scedillo-wq/TanqueComb/IMG-20260904-WA0024.jpg

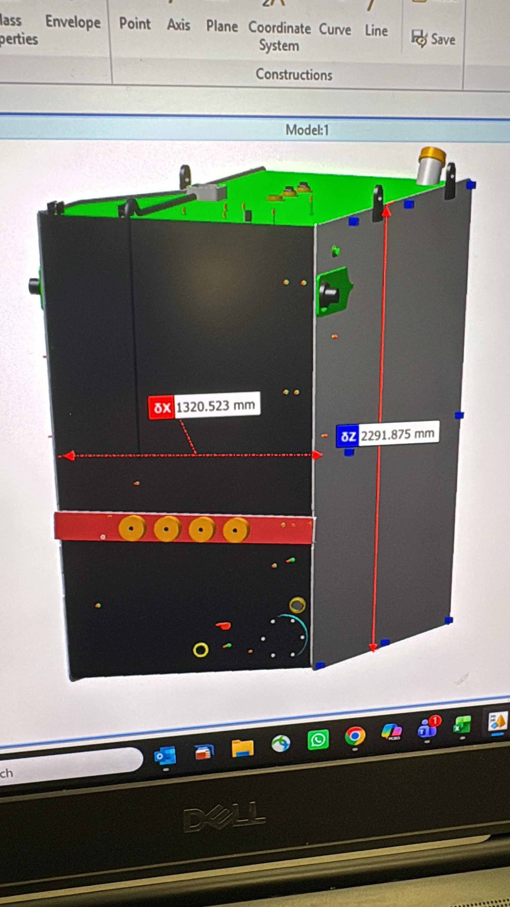
IMG-20260904-WA0024.jpg
