scedillo-wq/TanqueComb/Plano TK1.jpeg

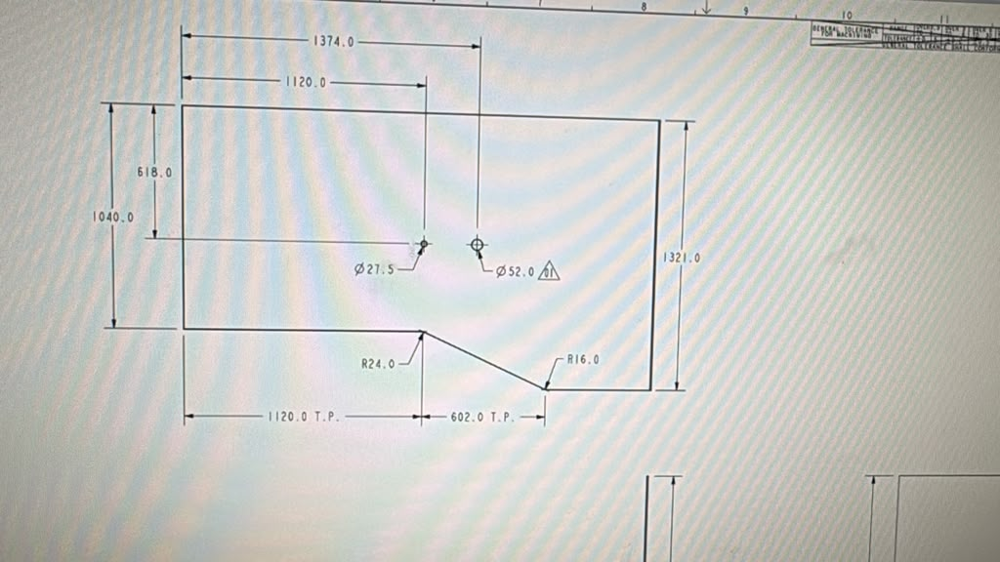
Plano TK1.jpeg
