scedillo-wq/TanqueComb/README.md

# TanqueComb
naliza las propuestas de raul, realiza las 2 propuestas en 3d compatible con fusion360 saca los planos y ademas realiza el analisis de elementos finitos apoyate del contexto adjunto
