scedillo-wq/TanqueComb/Stress Analysis Report 2 (1).pdf

31/12/2016 | Stress Analysis Report 2
file:///C:/Users/DOCUMENTOS/Desktop/SIMULACION/ENSAMBLE%20GENERAL%20Stress%20Analysis%20Report%2031_12_2016.html | 1/50

# Stress Analysis Report 2

Analyzed File: | ENSAMBLE GENERAL.iam
Autodesk Inventor Version: | 2015 (Build 190159000, 159)
Creation Date: | 31/12/2016, 11:25 a.m.
Simulation Author: | DOCUMENTOS
Summary:

### Project Info (iProperties)

Summary
Author DOCUMENTOS

Project
Part Number | ENSAMBLE GENERAL
Designer | DOCUMENTOS
Cost | S/. 0.00
Date Created | 31/12/2016

Status
Design Status WorkInProgress

Physical
Mass | 686.139 kg
Area | 67517700 mm^2
Volume | 686139000 mm^3
Center of Gravity | x=368.817 mm y=-534.213 mm z=354.259 mm

Note: Physical values could be different from Physical values used by FEA reported below.

## SIMULACION ENSAYO

General objective and settings:
Design Objective | Single Point
Simulation Type | Static Analysis
Last Modification Date | 31/12/2016, 11:22 a.m.
Detect and Eliminate Rigid Body Modes | No
Separate Stresses Across Contact Surfaces | No
Motion Loads Analysis | No

Mesh settings:
Avg. Element Size (fraction of model diameter) | 0.1
Min. Element Size (fraction of avg. size) | 0.2
Grading Factor | 1.5
Max. Turn Angle | 60 deg
Create Curved Mesh Elements | No

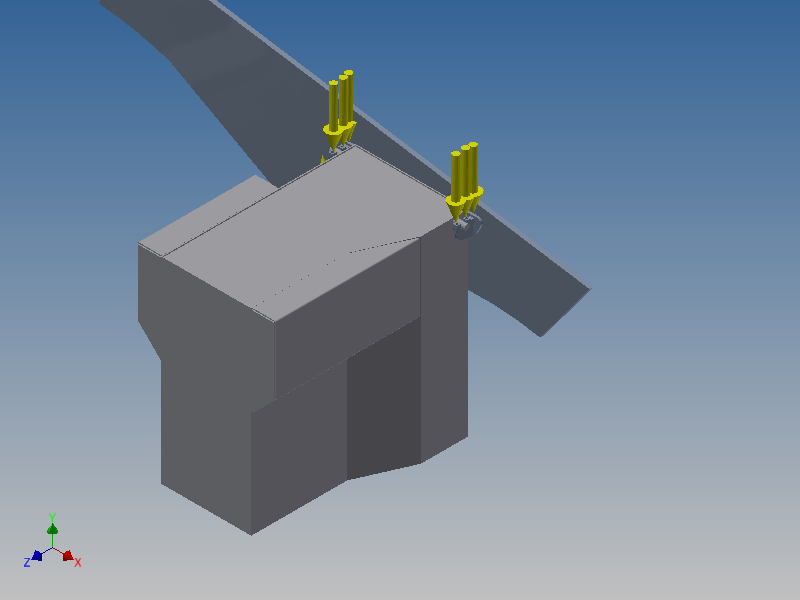
[picture p12: figure]

file:///C:/Users/DOCUMENTOS/Desktop/SIMULACION/ENSAMBLE%20GENERAL%20Stress%20Analysis%20Report%2031_12_2016.html | 2/50
Create Curved Mesh Elements | No
Use part based measure for Assembly mesh | Yes

### Material(s)

Name | Steel
General | Mass Density | 7.85 g/cm^3
| Yield Strength | 207 MPa
| Ultimate Tensile Strength | 345 MPa
Stress | Young's Modulus | 210 GPa
| Poisson's Ratio | 0.3 ul
| Shear Modulus | 80.7692 GPa
Part Name(s) | ESQUELETO 2 TANQUE COMBUSTIBLE CUERPO 1 TAPA 1 TAPA 1 CUERPO 2 TAPA 2 EJE PIN EJE PIN

### Operating conditions

Gravity
Load Type | Gravity
Magnitude | 9810.000 mm/s^2
Vector X | 0.000 mm/s^2
Vector Y | -9810.000 mm/s^2
Vector Z | 0.000 mm/s^2

Selected Face(s)

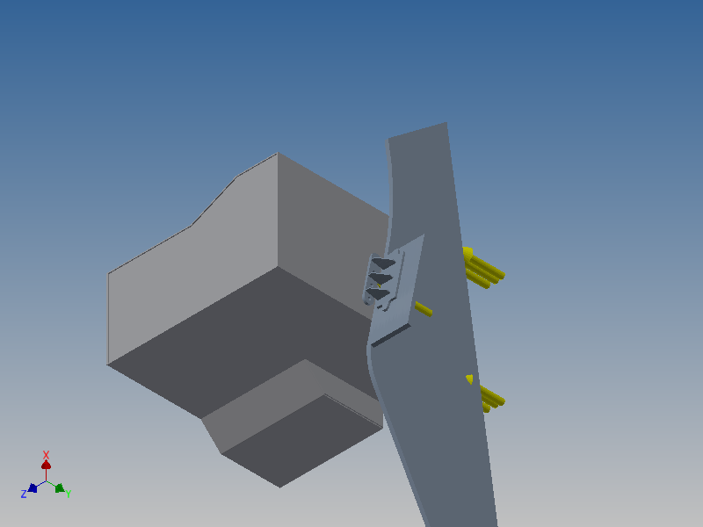
[picture p13: figure]
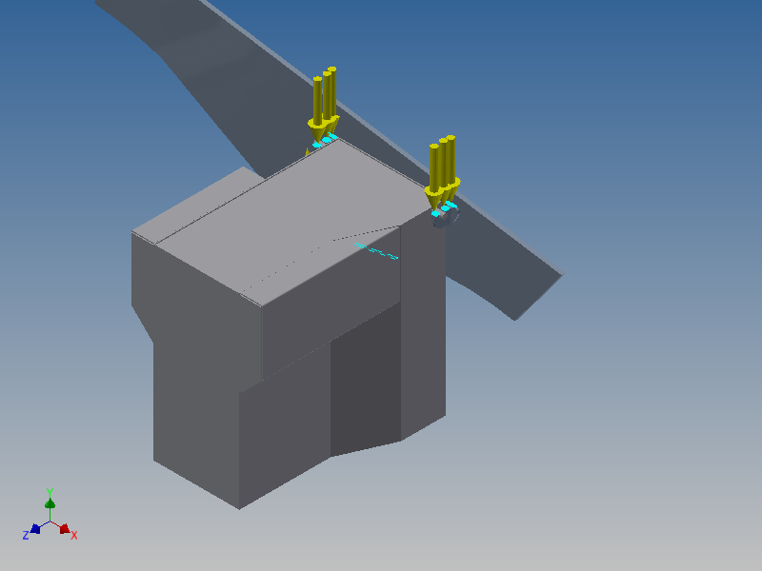
[picture p14: figure]

file:///C:/Users/DOCUMENTOS/Desktop/SIMULACION/ENSAMBLE%20GENERAL%20Stress%20Analysis%20Report%2031_12_2016.html | 3/50

Force:1
Load Type | Force
Magnitude | 88200.000 N
Vector X | 0.000 N
Vector Y | -88200.000 N
Vector Z | 0.000 N

Selected Face(s)

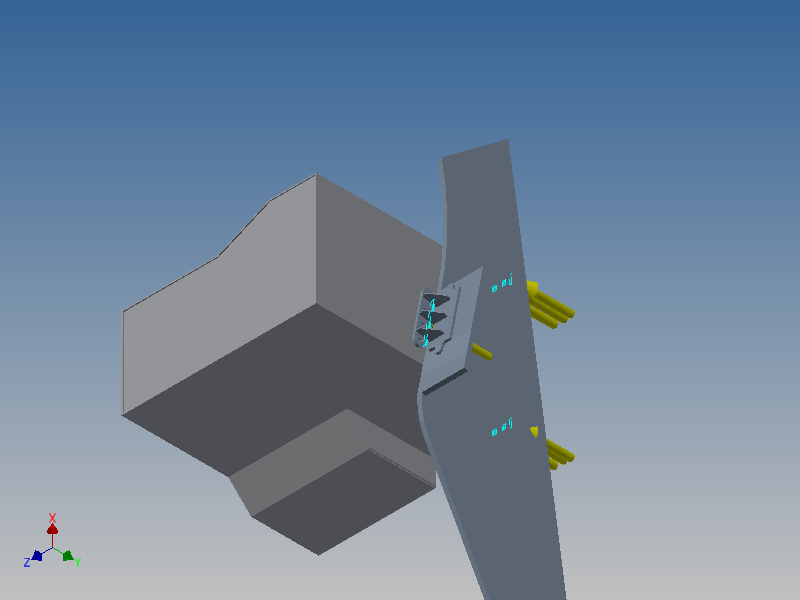
[picture p15: figure]
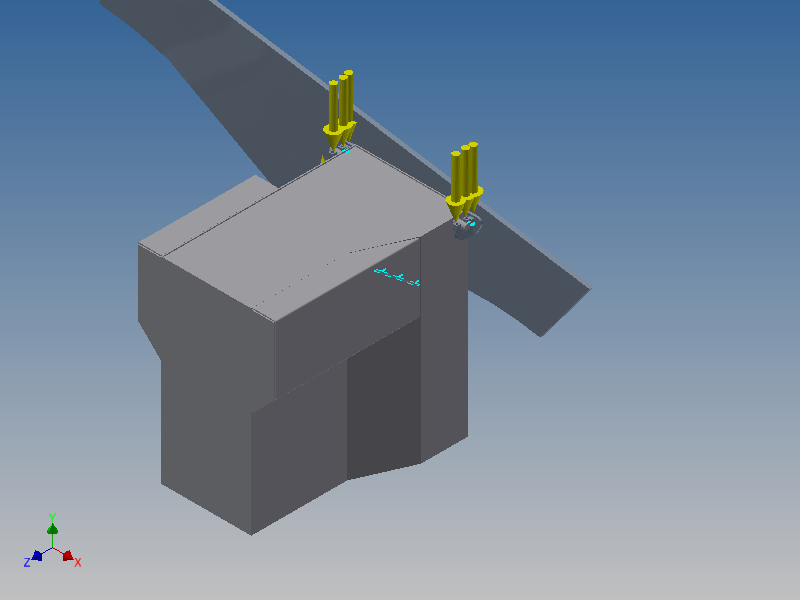
[picture p16: figure]

file:///C:/Users/DOCUMENTOS/Desktop/SIMULACION/ENSAMBLE%20GENERAL%20Stress%20Analysis%20Report%2031_12_2016.html | 4/50

Remote Force:1
Load Type | Remote Force
Magnitude | 88200.000 N
Vector X | -17099.795 N
Vector Y | 86526.511 N
Vector Z | 0.000 N
Remote Point X | 0.000 mm
Remote Point Y | 0.000 mm
Remote Point Z | 0.000 mm

Selected Face(s)

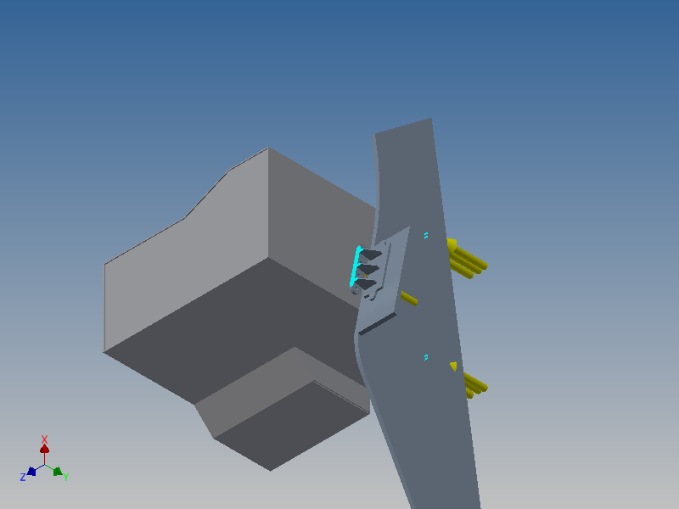
[picture p17: figure]
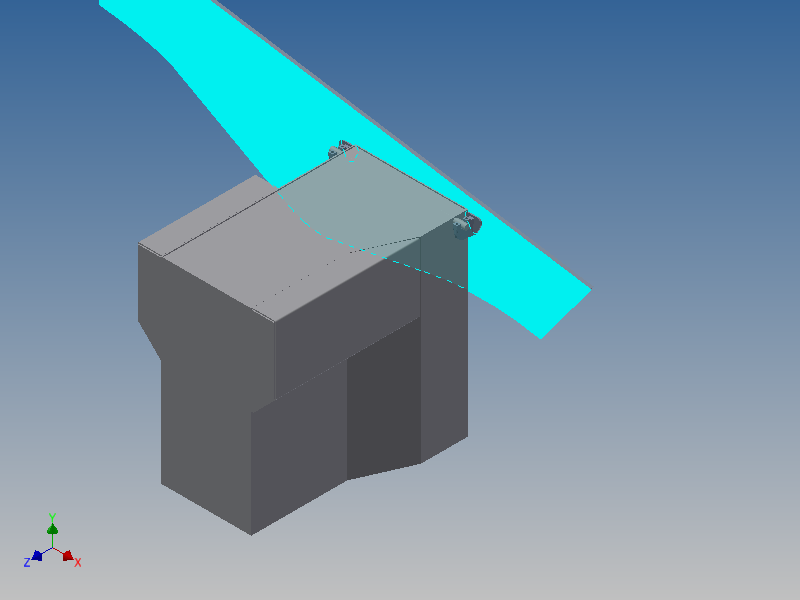
[picture p18: figure]

file:///C:/Users/DOCUMENTOS/Desktop/SIMULACION/ENSAMBLE%20GENERAL%20Stress%20Analysis%20Report%2031_12_2016.html | 5/50

Fixed Constraint:1
Constraint Type Fixed Constraint

Selected Face(s)

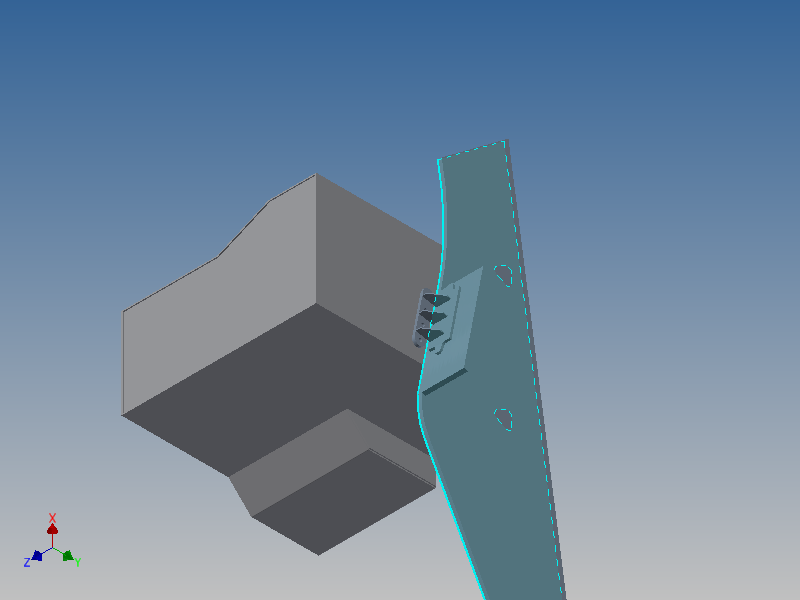
[picture p19: figure]

file:///C:/Users/DOCUMENTOS/Desktop/SIMULACION/ENSAMBLE%20GENERAL%20Stress%20Analysis%20Report%2031_12_2016.html | 6/50

Contacts (Bonded)
Name | Part Name(s)
Bonded:1 | ESQUELETO 2:1 TANQUE COMB. GENERAL 1:1/TANQUE COMBUSTIBLE_1
Bonded:2 | TANQUE COMB. GENERAL 1:1/TANQUE COMBUSTIBLE_1 TANQUE COMB. GENERAL 1:1/ENSAMBLE CAJON 01_4/CUERPO 1_8
Bonded:3 | TANQUE COMB. GENERAL 1:1/TANQUE COMBUSTIBLE_1 TANQUE COMB. GENERAL 1:1/ENSAMBLE CAJON 01_4/TAPA 1_9
Bonded:4 | TANQUE COMB. GENERAL 1:1/TANQUE COMBUSTIBLE_1 TANQUE COMB. GENERAL 1:1/ENSAMBLE CAJON 01_4/TAPA 1_10
Bonded:5 | TANQUE COMB. GENERAL 1:1/TANQUE COMBUSTIBLE_1 TANQUE COMB. GENERAL 1:1/ENSAMBLE CAJON 02_5/CUERPO 2_6
Bonded:6 | TANQUE COMB. GENERAL 1:1/TANQUE COMBUSTIBLE_1 TANQUE COMB. GENERAL 1:1/ENSAMBLE CAJON 02_5/TAPA 2_7
Bonded:7 | TANQUE COMB. GENERAL 1:1/ENSAMBLE CAJON 01_4/CUERPO 1_8 TANQUE COMB. GENERAL 1:1/ENSAMBLE CAJON 01_4/TAPA 1_9
Bonded:8 | TANQUE COMB. GENERAL 1:1/ENSAMBLE CAJON 01_4/CUERPO 1_8 TANQUE COMB. GENERAL 1:1/ENSAMBLE CAJON 01_4/TAPA 1_9
Bonded:9 | TANQUE COMB. GENERAL 1:1/ENSAMBLE CAJON 01_4/CUERPO 1_8 TANQUE COMB. GENERAL 1:1/ENSAMBLE CAJON 01_4/TAPA 1_10
Bonded:10 | TANQUE COMB. GENERAL 1:1/ENSAMBLE CAJON 01_4/CUERPO 1_8 TANQUE COMB. GENERAL 1:1/ENSAMBLE CAJON 01_4/TAPA 1_10
Bonded:11 | TANQUE COMB. GENERAL 1:1/ENSAMBLE CAJON 02_5/CUERPO 2_6 TANQUE COMB. GENERAL 1:1/ENSAMBLE CAJON 02_5/TAPA 2_7
Bonded:12 | TANQUE COMB. GENERAL 1:1/ENSAMBLE CAJON 02_5/CUERPO 2_6 TANQUE COMB. GENERAL 1:1/ENSAMBLE CAJON 02_5/TAPA 2_7

### Results

Reaction Force and Moment on Constraints
Constraint Name | Reaction Force | Reaction Moment
Magnitude | Component (X,Y,Z) | Magnitude | Component (X,Y,Z)
Fixed Constraint:1 | 57115.9 N | 17099.8 N | 88454.9 N m | -13486.9 N m
| | 54496 N | | 3426.82 N m
| | 0 N | | 87353.5 N m

Result Summary
Name | Minimum | Maximum
Volume | 686139000 mm^3
Mass | 5386.19 kg

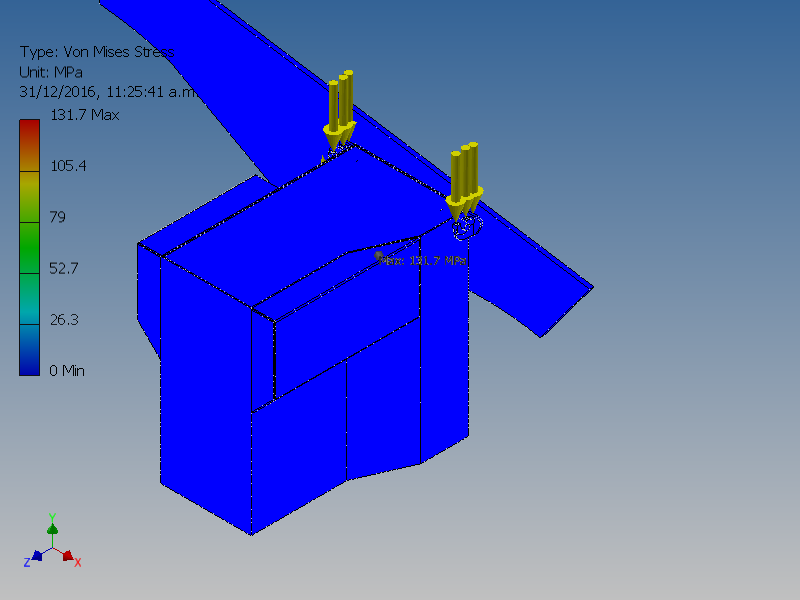
[picture p20: figure]

file:///C:/Users/DOCUMENTOS/Desktop/SIMULACION/ENSAMBLE%20GENERAL%20Stress%20Analysis%20Report%2031_12_2016.html | 7/50
Mass | 5386.19 kg
Von Mises Stress
0.00000579188 MPa | 131.688 MPa
1st Principal Stress | -20.3792 MPa | 41.4119 MPa
3rd Principal Stress | -154.852 MPa | 3.88798 MPa
Displacement | 0 mm | 3517.83 mm
Safety Factor | 1.57189 ul | 15 ul
Stress XX | -47.8519 MPa | 19.2757 MPa
Stress XY | -10.1605 MPa | 52.5278 MPa
Stress XZ | -18.8326 MPa | 8.06918 MPa
Stress YY | -120.83 MPa | 25.5228 MPa
Stress YZ | -17.5065 MPa | 25.0024 MPa
Stress ZZ | -35.0782 MPa | 20.6811 MPa
X Displacement | -21.416 mm | 21.7659 mm
Y Displacement | -3517.83 mm | 0.0466419 mm
Z Displacement | -37.3652 mm | 36.8066 mm
Equivalent Strain | 0.000000000024127 ul | 0.000572764 ul
1st Principal Strain | -0.00000106062 ul | 0.000219728 ul
3rd Principal Strain | -0.000670939 ul | 0.00000387183 ul
Strain XX | -0.000140328 ul | 0.000106401 ul
Strain XY | -0.0000628984 ul | 0.000325172 ul
Strain XZ | -0.000116583 ul | 0.0000499521 ul
Strain YY | -0.000460327 ul | 0.000107784 ul
Strain YZ | -0.000108374 ul | 0.000154777 ul
Strain ZZ | -0.0000836718 ul | 0.000113239 ul
Contact Pressure | 0 MPa | 106.77 MPa
Contact Pressure X | -72.1221 MPa | 104.44 MPa
Contact Pressure Y | -25.3022 MPa | 21.4789 MPa
Contact Pressure Z | -11.3562 MPa | 9.55096 MPa

Figures

Von Mises Stress

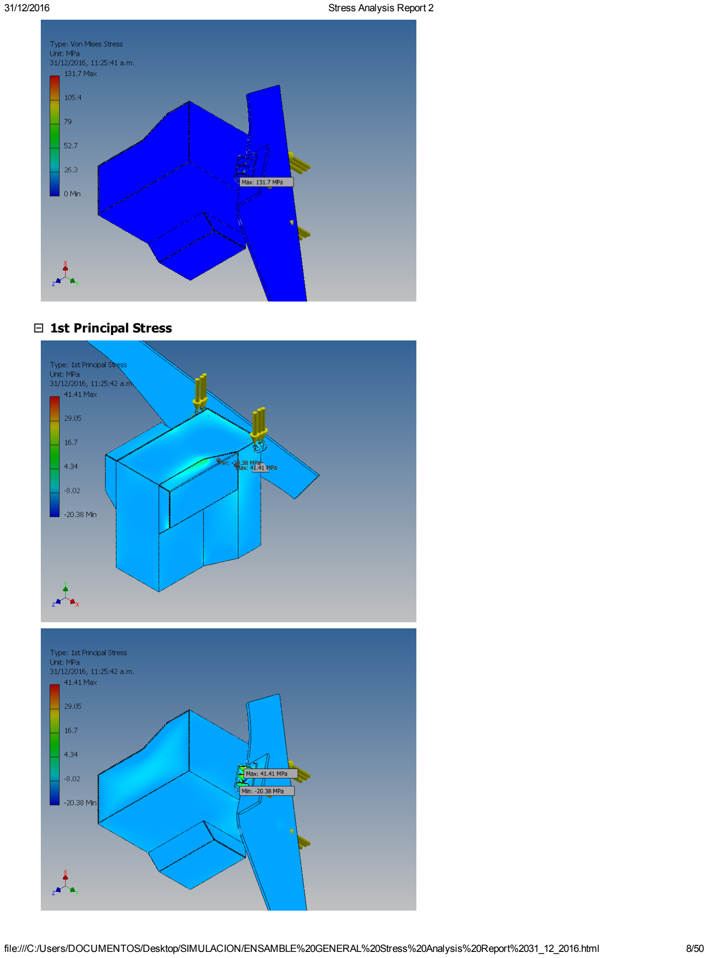
[picture p21: page 8]

file:///C:/Users/DOCUMENTOS/Desktop/SIMULACION/ENSAMBLE%20GENERAL%20Stress%20Analysis%20Report%2031_12_2016.html | 8/50

1st Principal Stress

3rd Principal Stress

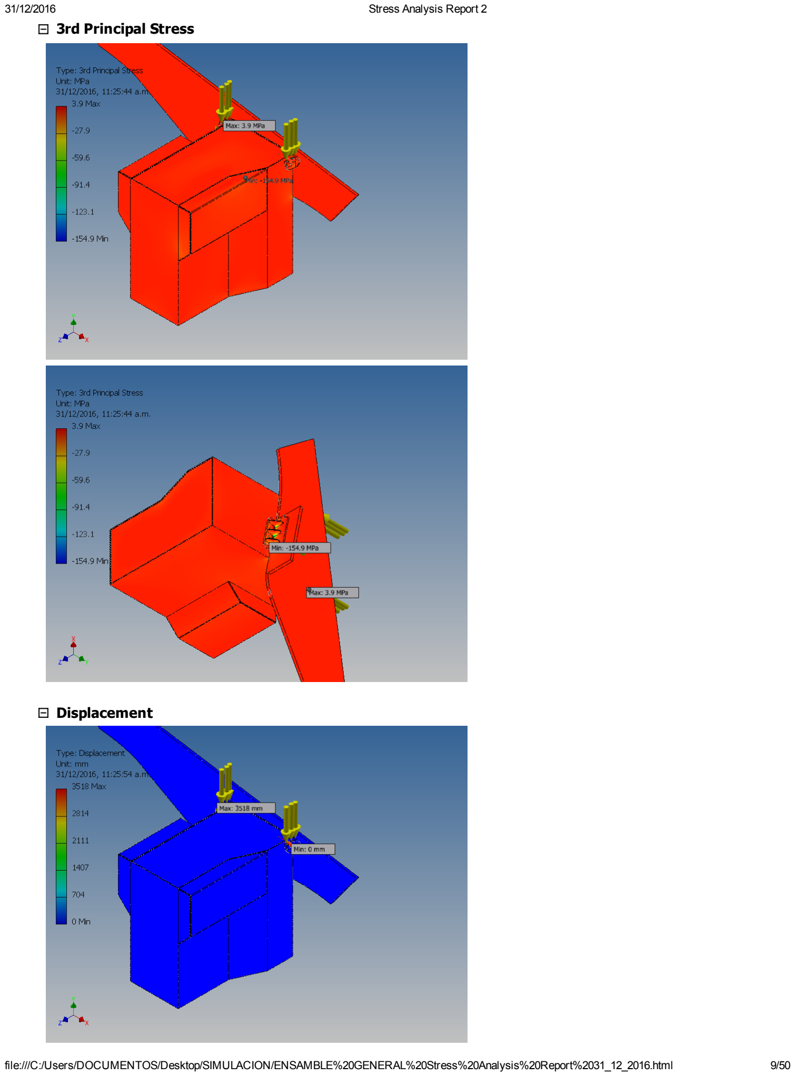
[picture p22: page 9]

file:///C:/Users/DOCUMENTOS/Desktop/SIMULACION/ENSAMBLE%20GENERAL%20Stress%20Analysis%20Report%2031_12_2016.html | 9/50

3rd Principal Stress

Displacement

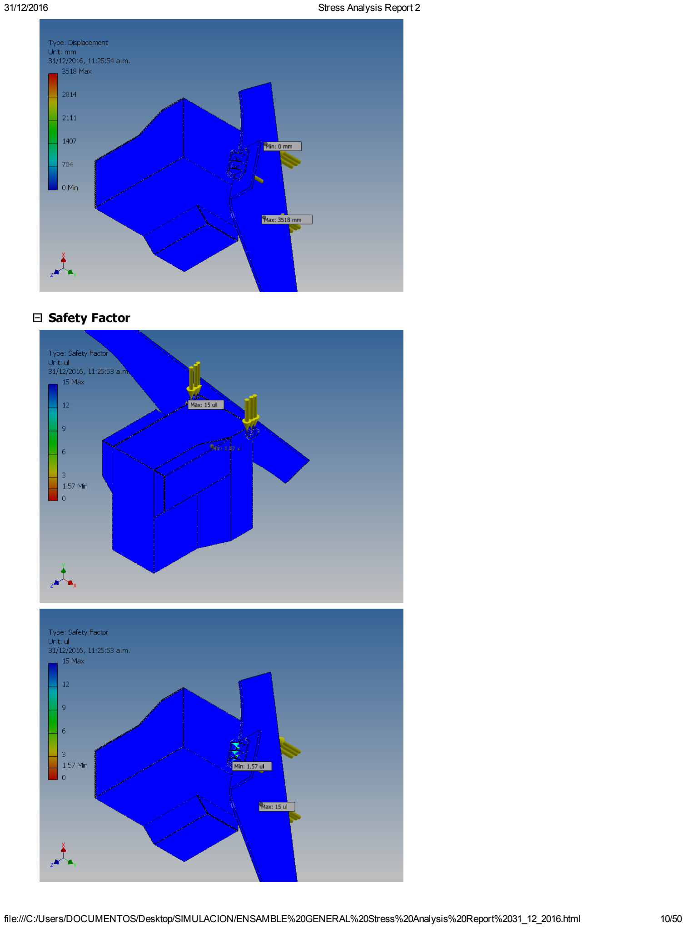
[picture p23: page 10]

file:///C:/Users/DOCUMENTOS/Desktop/SIMULACION/ENSAMBLE%20GENERAL%20Stress%20Analysis%20Report%2031_12_2016.html | 10/50

Safety Factor

Stress XX

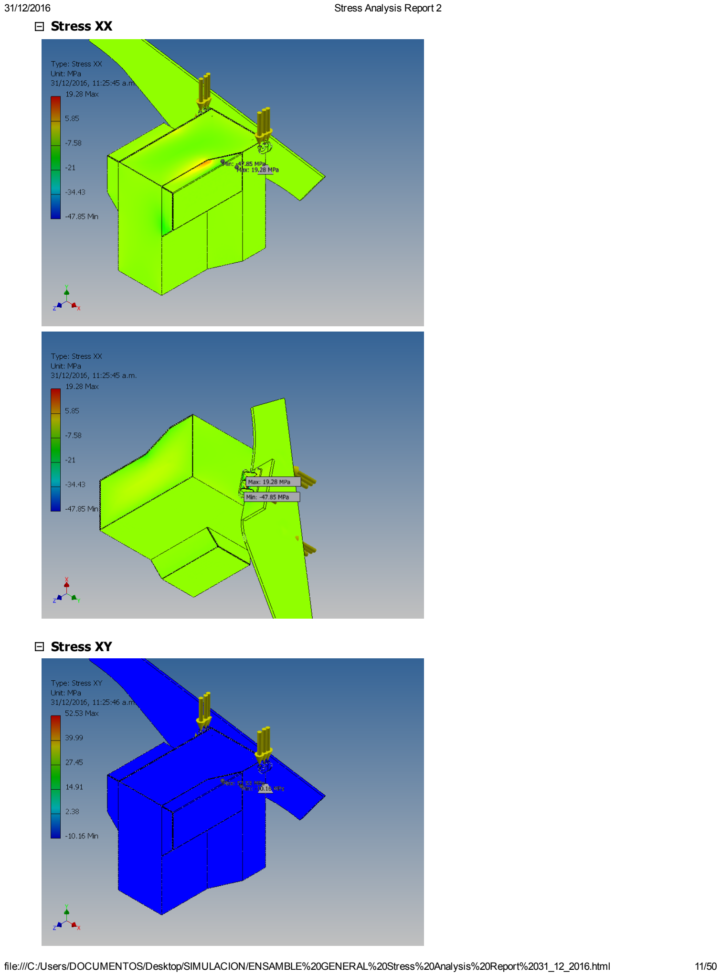
[picture p24: page 11]

file:///C:/Users/DOCUMENTOS/Desktop/SIMULACION/ENSAMBLE%20GENERAL%20Stress%20Analysis%20Report%2031_12_2016.html | 11/50

Stress XX

Stress XY

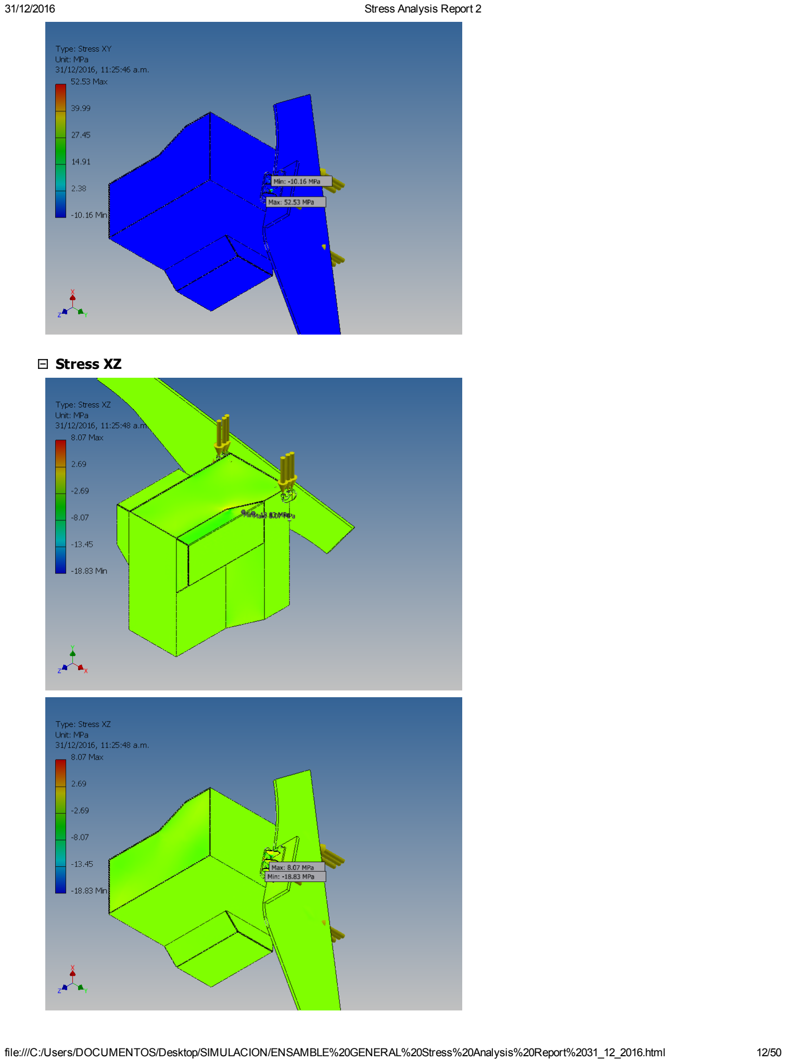
[picture p25: page 12]

file:///C:/Users/DOCUMENTOS/Desktop/SIMULACION/ENSAMBLE%20GENERAL%20Stress%20Analysis%20Report%2031_12_2016.html | 12/50

Stress XZ

Stress YY

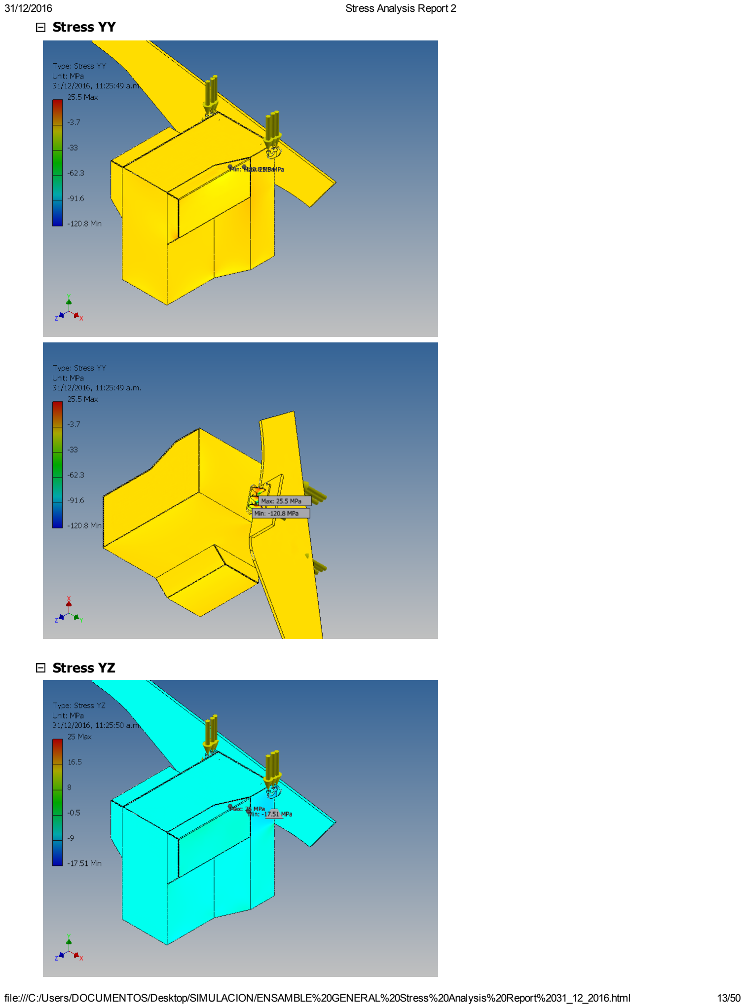
[picture p26: page 13]

file:///C:/Users/DOCUMENTOS/Desktop/SIMULACION/ENSAMBLE%20GENERAL%20Stress%20Analysis%20Report%2031_12_2016.html | 13/50

Stress YY

Stress YZ

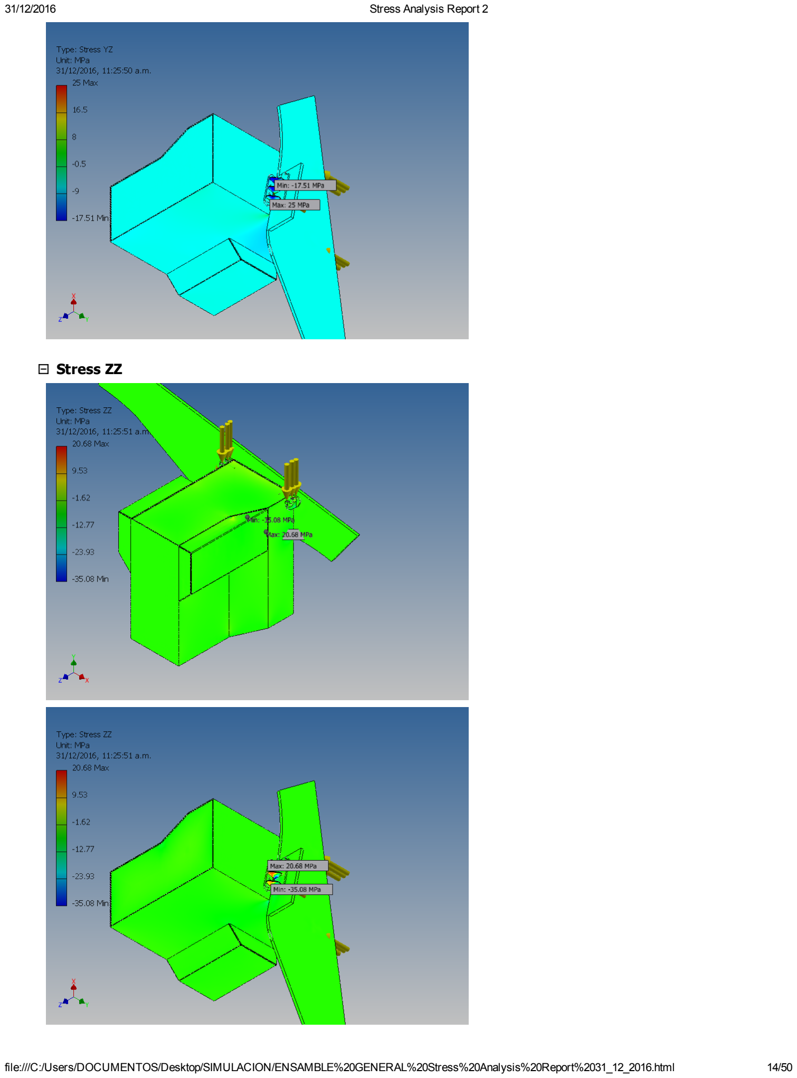
[picture p27: page 14]

file:///C:/Users/DOCUMENTOS/Desktop/SIMULACION/ENSAMBLE%20GENERAL%20Stress%20Analysis%20Report%2031_12_2016.html | 14/50

Stress ZZ

X Displacement

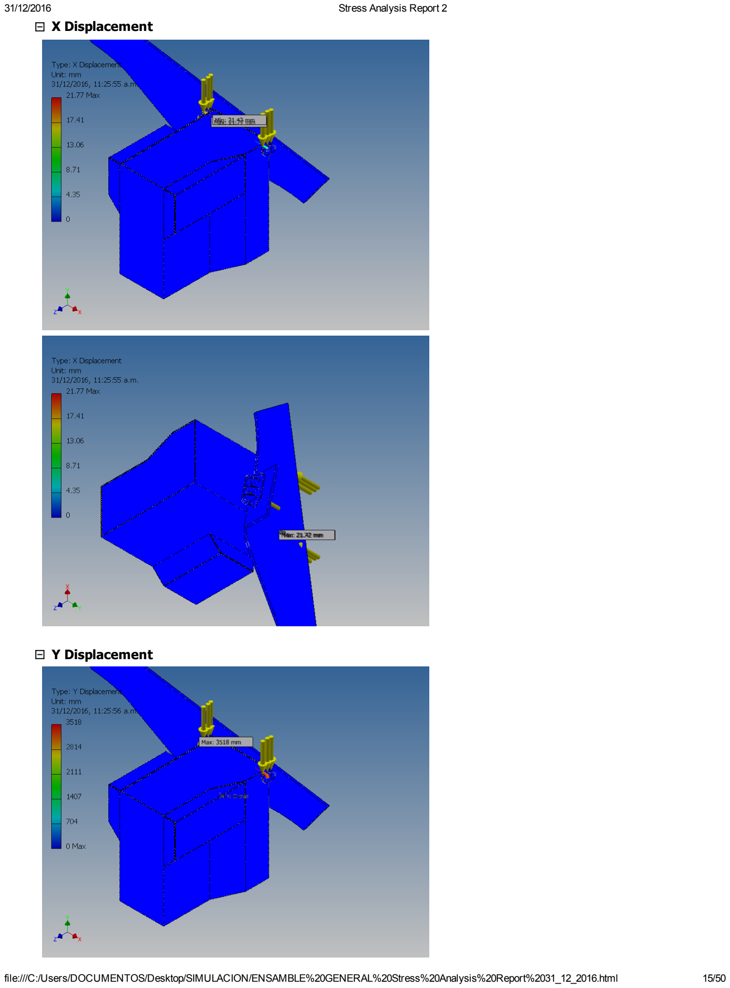
[picture p28: page 15]

file:///C:/Users/DOCUMENTOS/Desktop/SIMULACION/ENSAMBLE%20GENERAL%20Stress%20Analysis%20Report%2031_12_2016.html | 15/50

X Displacement

Y Displacement

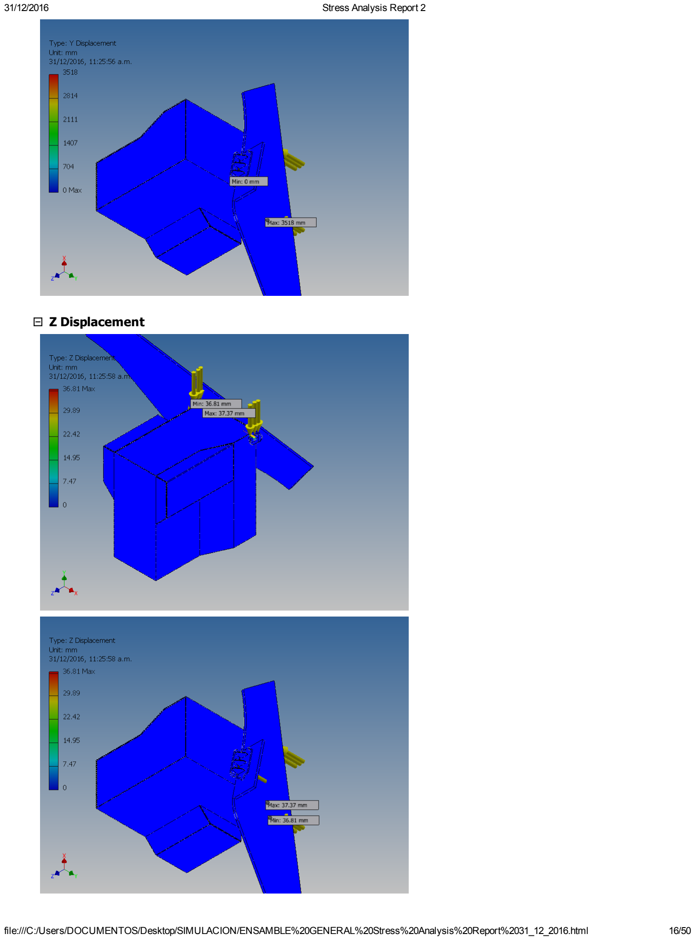
[picture p29: page 16]

file:///C:/Users/DOCUMENTOS/Desktop/SIMULACION/ENSAMBLE%20GENERAL%20Stress%20Analysis%20Report%2031_12_2016.html | 16/50

Z Displacement

Equivalent Strain

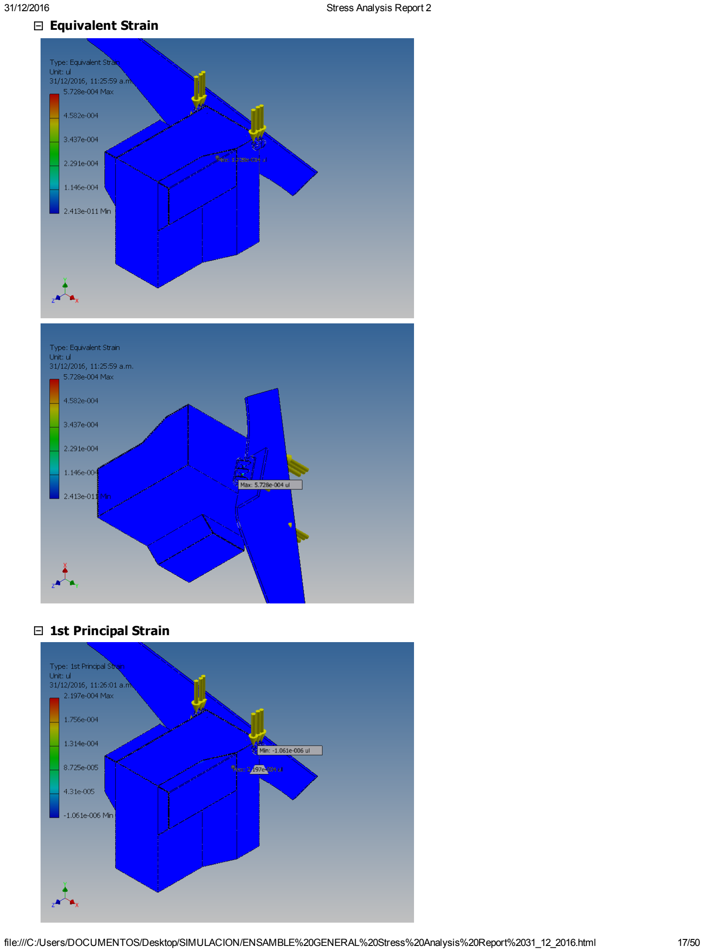
[picture p30: page 17]

file:///C:/Users/DOCUMENTOS/Desktop/SIMULACION/ENSAMBLE%20GENERAL%20Stress%20Analysis%20Report%2031_12_2016.html | 17/50

Equivalent Strain

1st Principal Strain

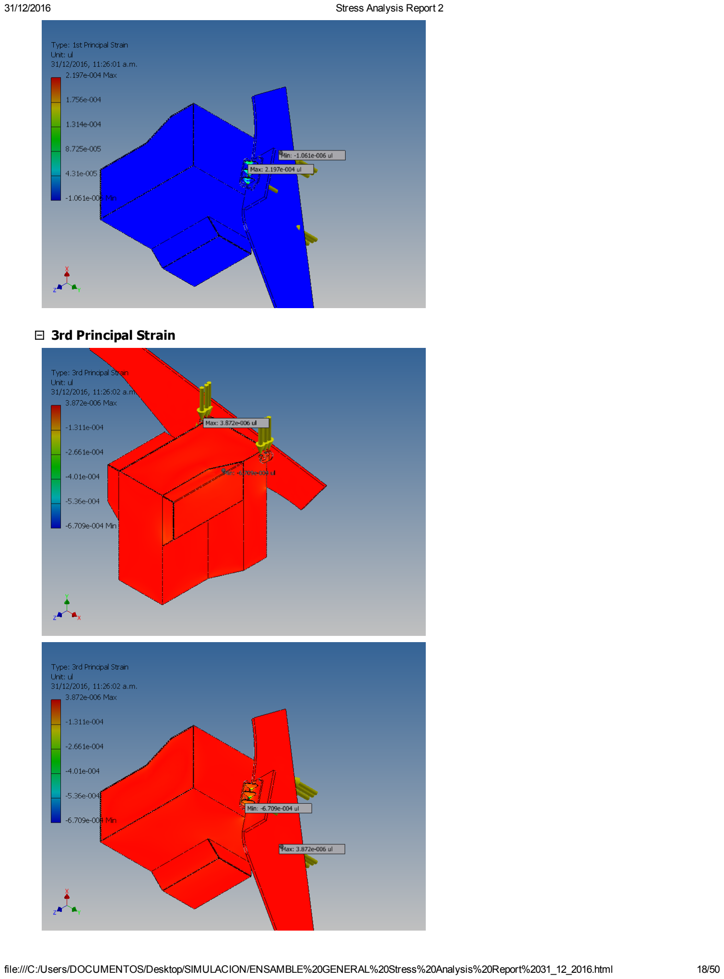
[picture p31: page 18]

file:///C:/Users/DOCUMENTOS/Desktop/SIMULACION/ENSAMBLE%20GENERAL%20Stress%20Analysis%20Report%2031_12_2016.html | 18/50

3rd Principal Strain

Strain XX

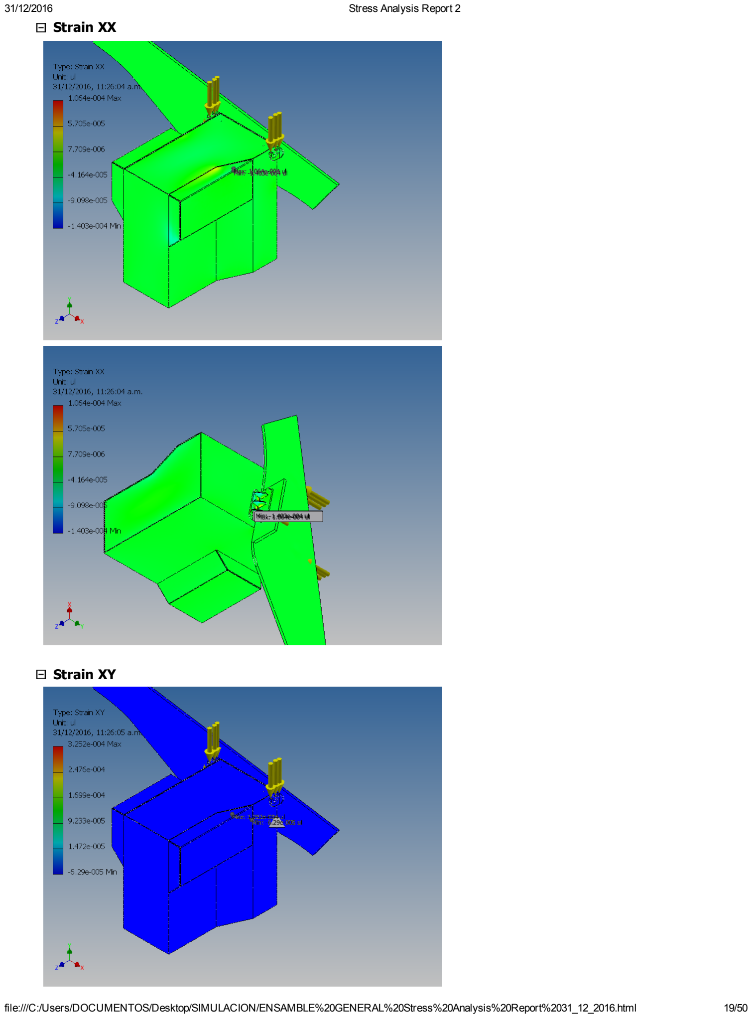
[picture p32: page 19]

file:///C:/Users/DOCUMENTOS/Desktop/SIMULACION/ENSAMBLE%20GENERAL%20Stress%20Analysis%20Report%2031_12_2016.html | 19/50

Strain XX

Strain XY

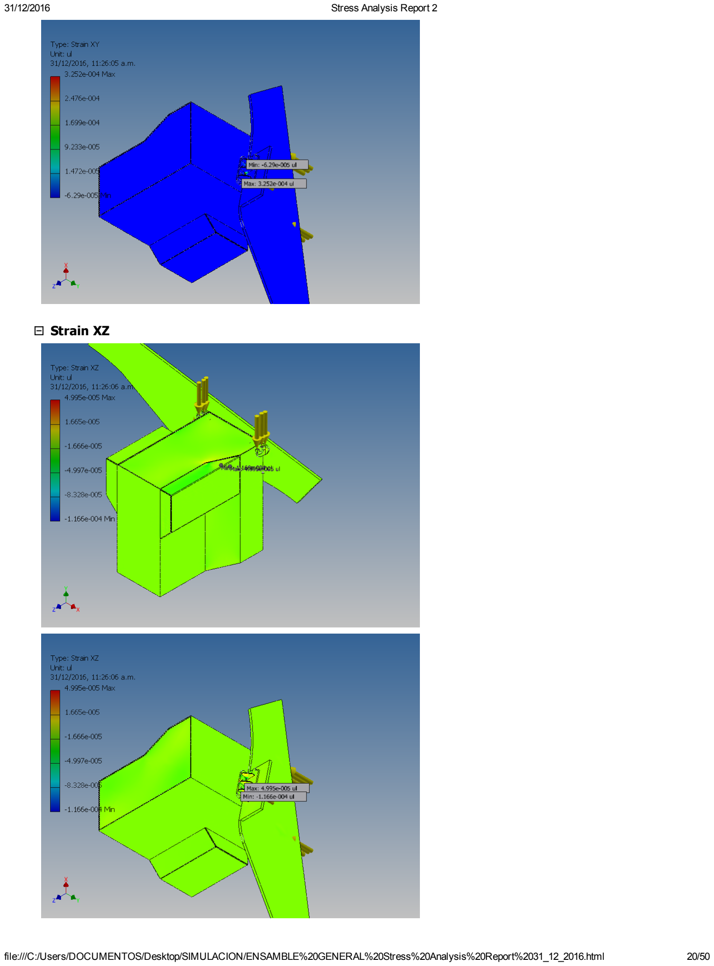
[picture p33: page 20]

file:///C:/Users/DOCUMENTOS/Desktop/SIMULACION/ENSAMBLE%20GENERAL%20Stress%20Analysis%20Report%2031_12_2016.html | 20/50

Strain XZ

Strain YY

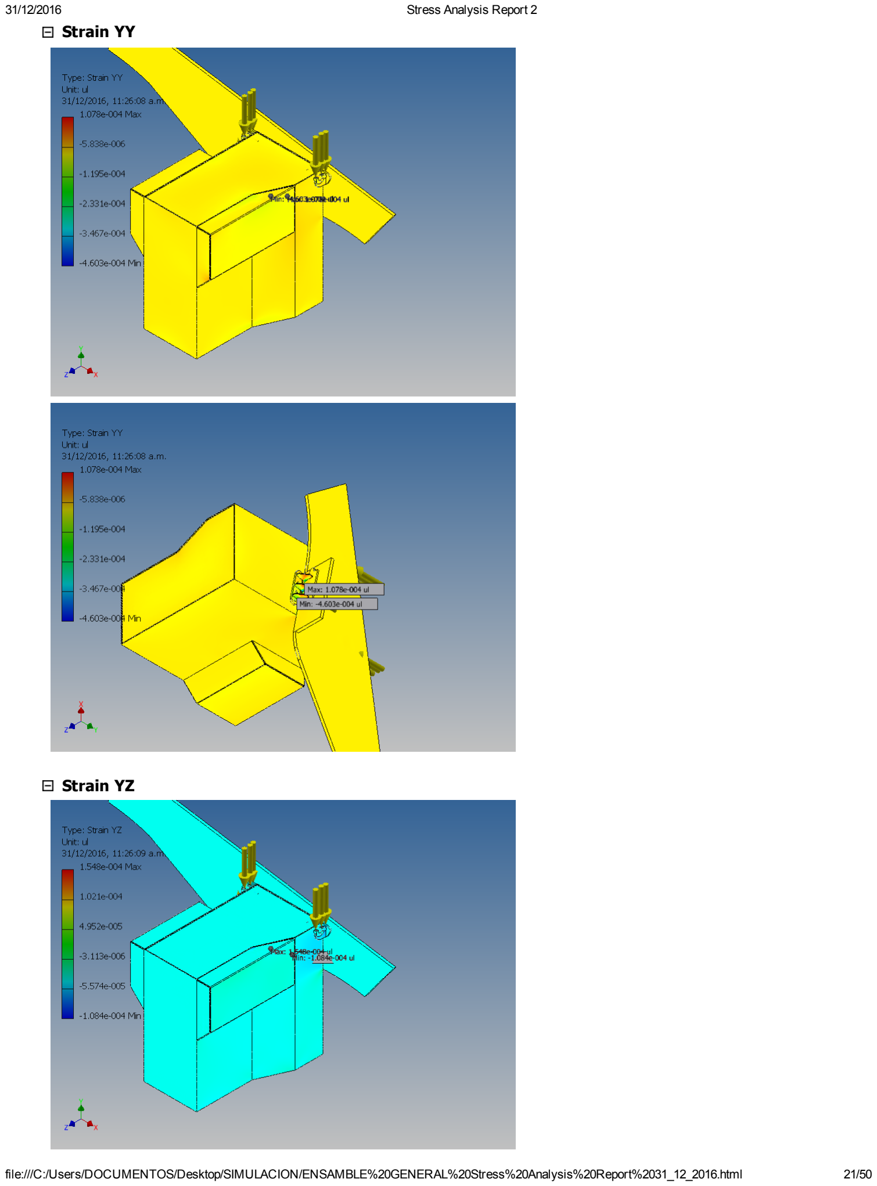
[picture p34: page 21]

file:///C:/Users/DOCUMENTOS/Desktop/SIMULACION/ENSAMBLE%20GENERAL%20Stress%20Analysis%20Report%2031_12_2016.html | 21/50

Strain YY

Strain YZ

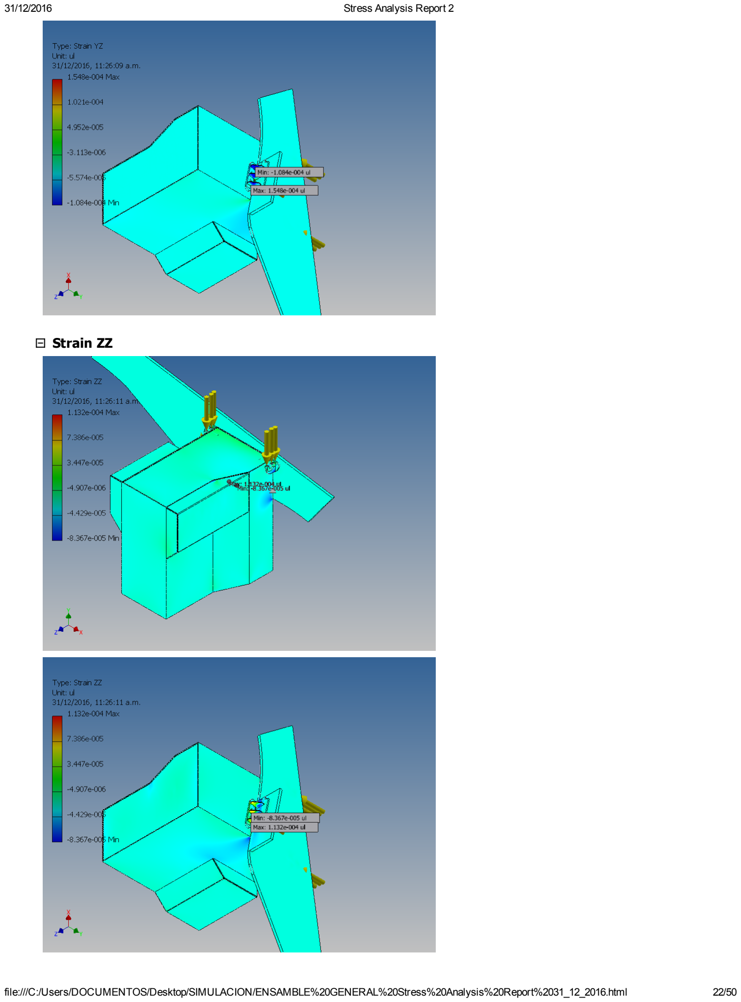
[picture p35: page 22]

file:///C:/Users/DOCUMENTOS/Desktop/SIMULACION/ENSAMBLE%20GENERAL%20Stress%20Analysis%20Report%2031_12_2016.html | 22/50

Strain ZZ

Contact Pressure

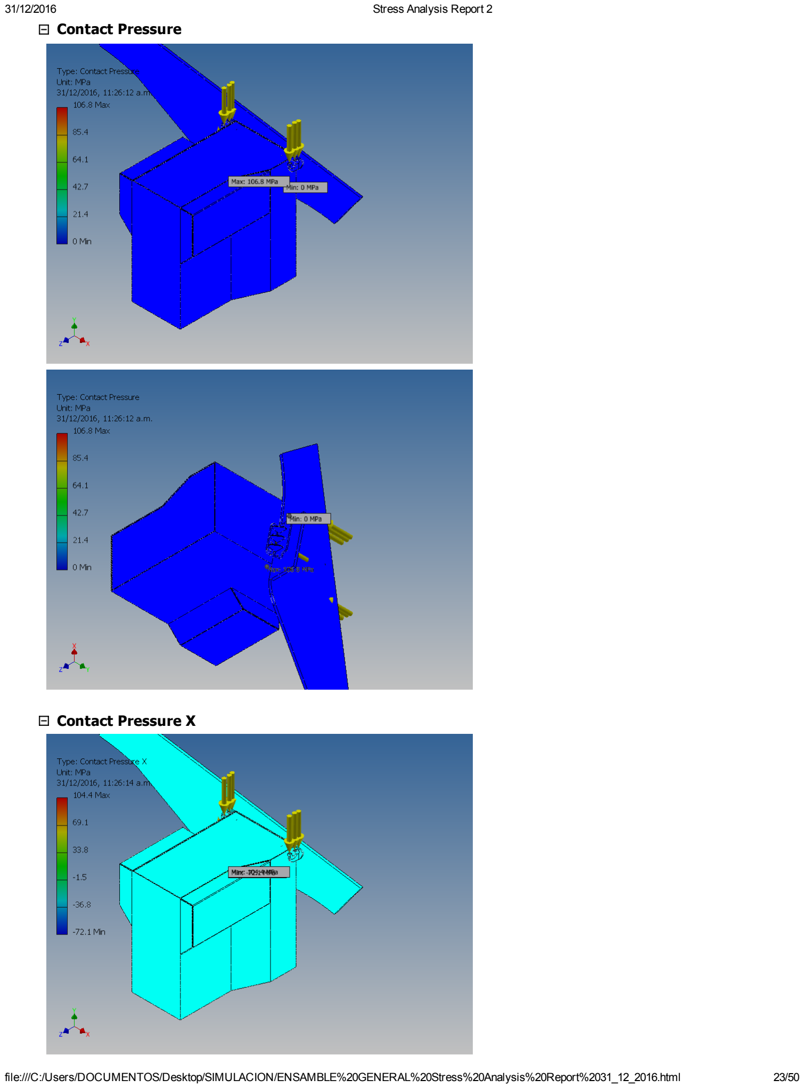
[picture p36: page 23]

file:///C:/Users/DOCUMENTOS/Desktop/SIMULACION/ENSAMBLE%20GENERAL%20Stress%20Analysis%20Report%2031_12_2016.html | 23/50

Contact Pressure

Contact Pressure X

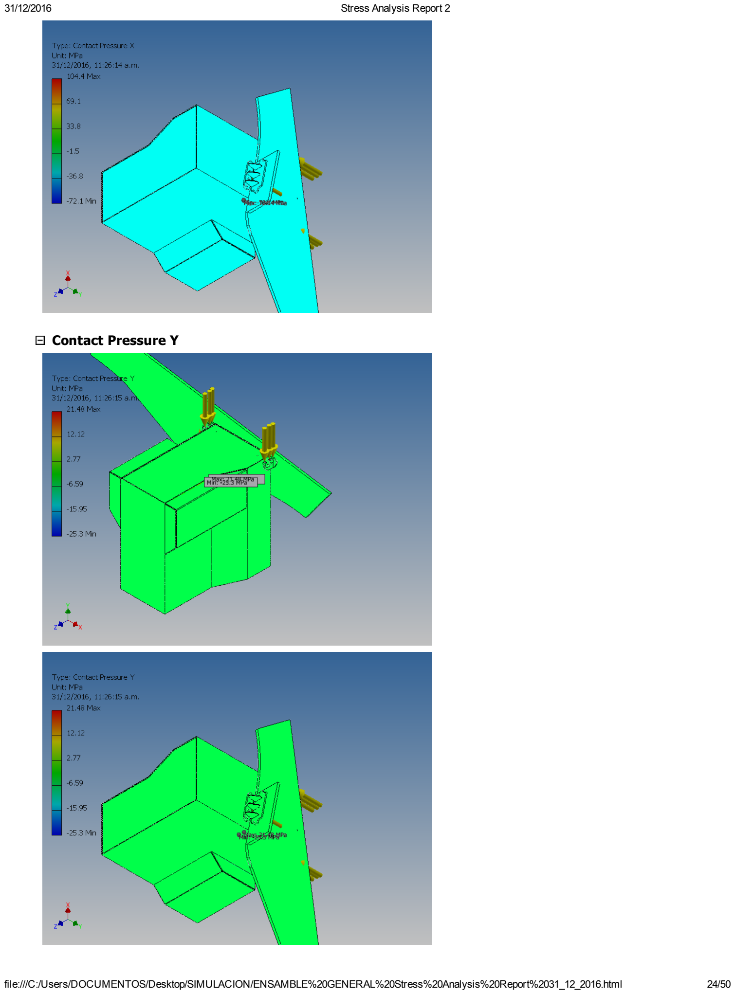
[picture p37: page 24]

file:///C:/Users/DOCUMENTOS/Desktop/SIMULACION/ENSAMBLE%20GENERAL%20Stress%20Analysis%20Report%2031_12_2016.html | 24/50

Contact Pressure Y

Contact Pressure Z

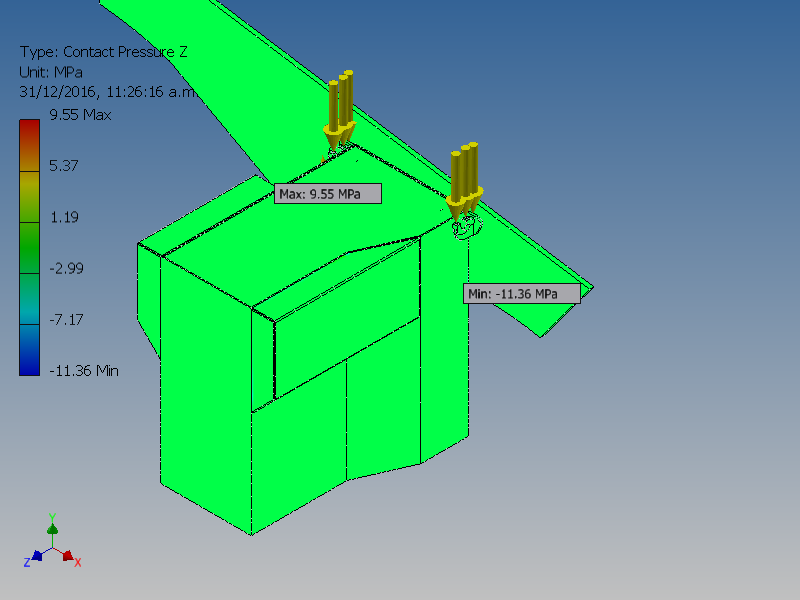
[picture p38: figure]
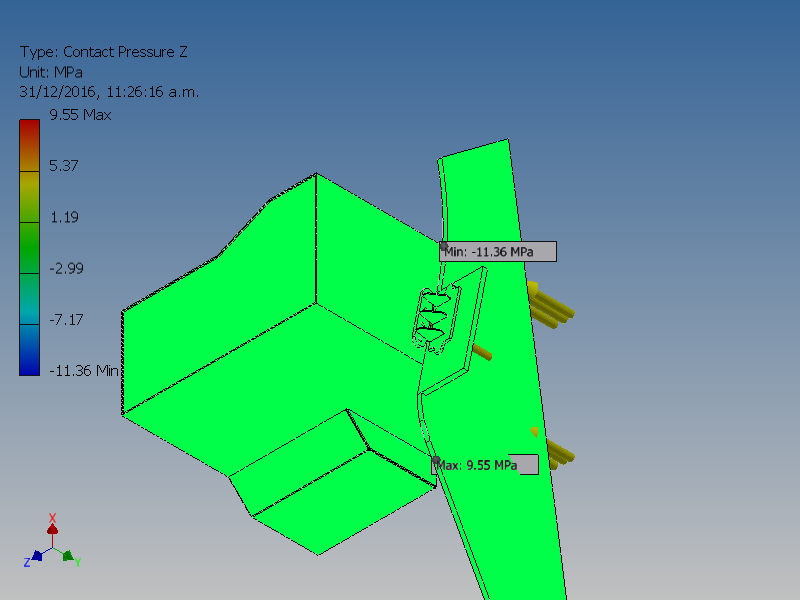
[picture p39: figure]

file:///C:/Users/DOCUMENTOS/Desktop/SIMULACION/ENSAMBLE%20GENERAL%20Stress%20Analysis%20Report%2031_12_2016.html | 25/50

Contact Pressure Z

## Simulation Ensayo 2

General objective and settings:
Design Objective | Single Point
Simulation Type | Static Analysis
Last Modification Date | 31/12/2016, 10:55 a.m.
Detect and Eliminate Rigid Body Modes | No
Separate Stresses Across Contact Surfaces | No
Motion Loads Analysis | No

Mesh settings:
Avg. Element Size (fraction of model diameter) | 0.1
Min. Element Size (fraction of avg. size) | 0.2
Grading Factor | 1.5
Max. Turn Angle | 60 deg
Create Curved Mesh Elements | No
Use part based measure for Assembly mesh | Yes

### Material(s)

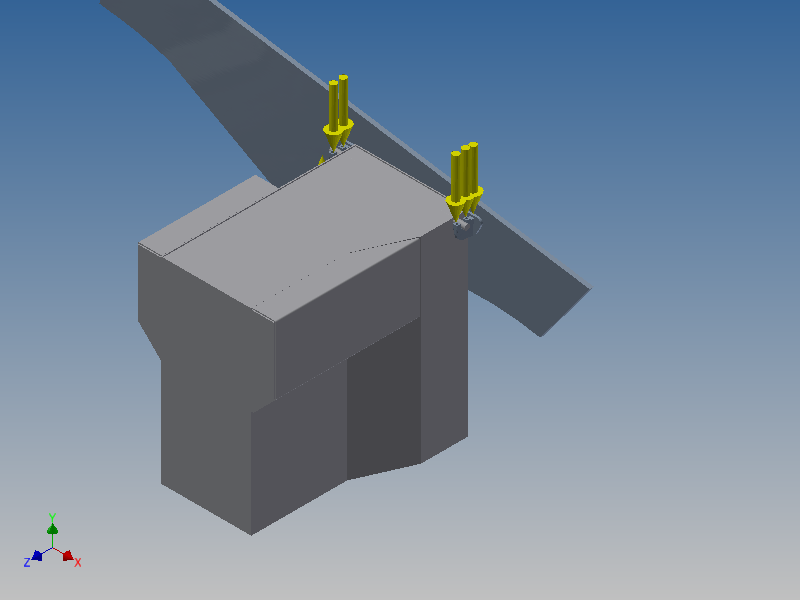
[picture p40: figure]

file:///C:/Users/DOCUMENTOS/Desktop/SIMULACION/ENSAMBLE%20GENERAL%20Stress%20Analysis%20Report%2031_12_2016.html | 26/50

### Material(s)

Name | Steel
General | Mass Density | 7.85 g/cm^3
| Yield Strength | 207 MPa
| Ultimate Tensile Strength | 345 MPa
Stress | Young's Modulus | 210 GPa
| Poisson's Ratio | 0.3 ul
| Shear Modulus | 80.7692 GPa
Part Name(s) | ESQUELETO 2 TANQUE COMBUSTIBLE CUERPO 1 TAPA 1 TAPA 1 CUERPO 2 TAPA 2 EJE PIN EJE PIN

### Operating conditions

Gravity
Load Type | Gravity
Magnitude | 9810.000 mm/s^2
Vector X | 0.000 mm/s^2
Vector Y | -9810.000 mm/s^2
Vector Z | 0.000 mm/s^2

Selected Face(s)

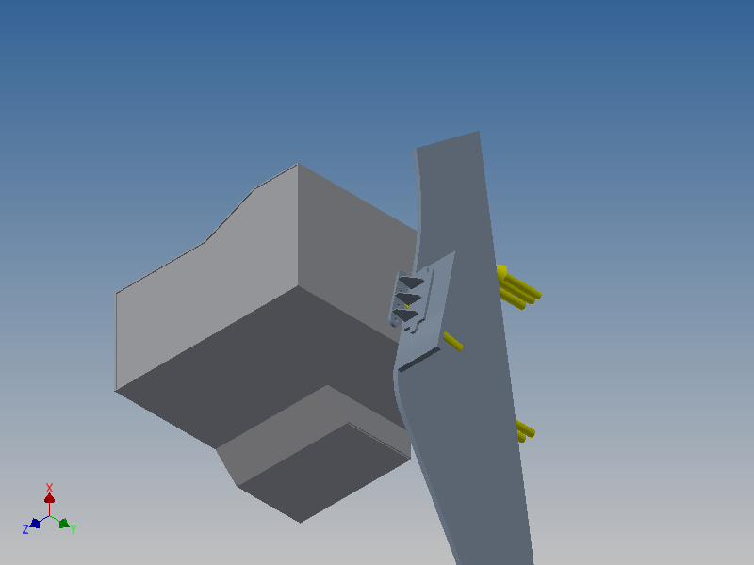
[picture p41: figure]
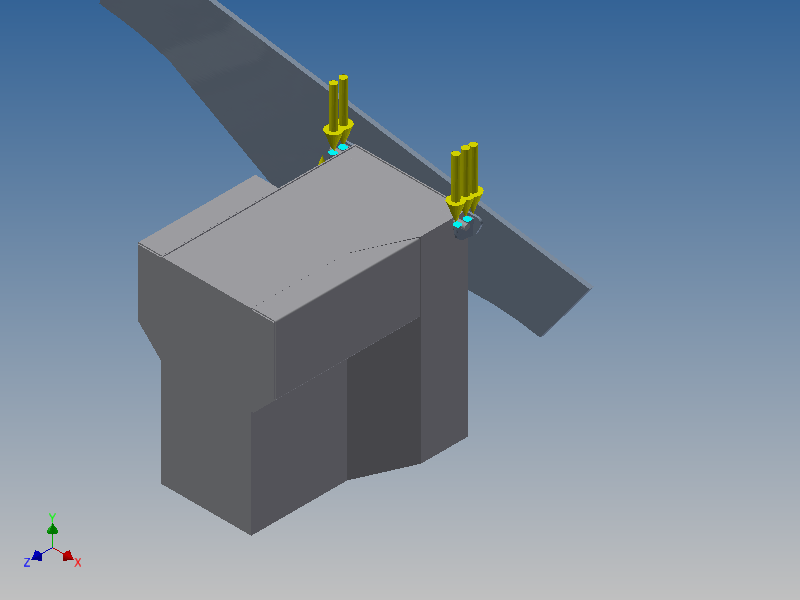
[picture p42: figure]

file:///C:/Users/DOCUMENTOS/Desktop/SIMULACION/ENSAMBLE%20GENERAL%20Stress%20Analysis%20Report%2031_12_2016.html | 27/50

Force:1
Load Type | Force
Magnitude | 88200.000 N
Vector X | 0.000 N
Vector Y | -88200.000 N
Vector Z | 0.000 N

Selected Face(s)

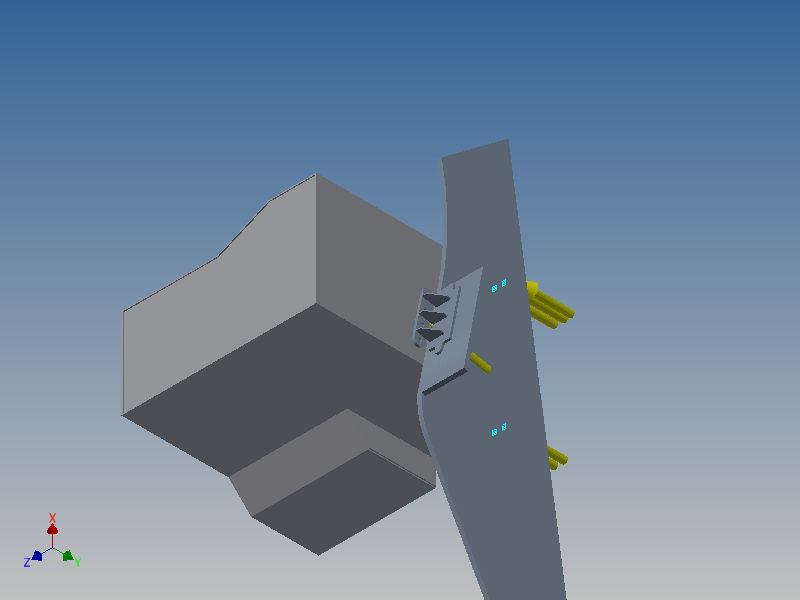
[picture p43: figure]
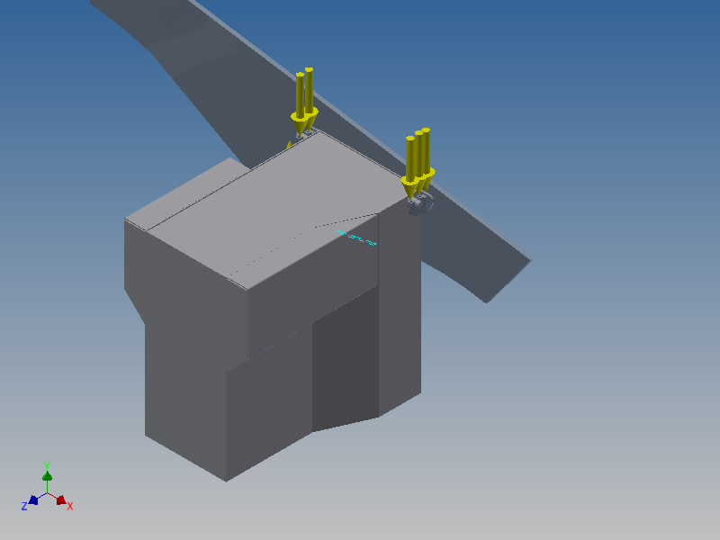
[picture p44: figure]

file:///C:/Users/DOCUMENTOS/Desktop/SIMULACION/ENSAMBLE%20GENERAL%20Stress%20Analysis%20Report%2031_12_2016.html | 28/50

Force:2
Load Type | Force
Magnitude | 88200.000 N
Vector X | 17099.795 N
Vector Y | -86526.511 N
Vector Z | -0.000 N

Selected Face(s)

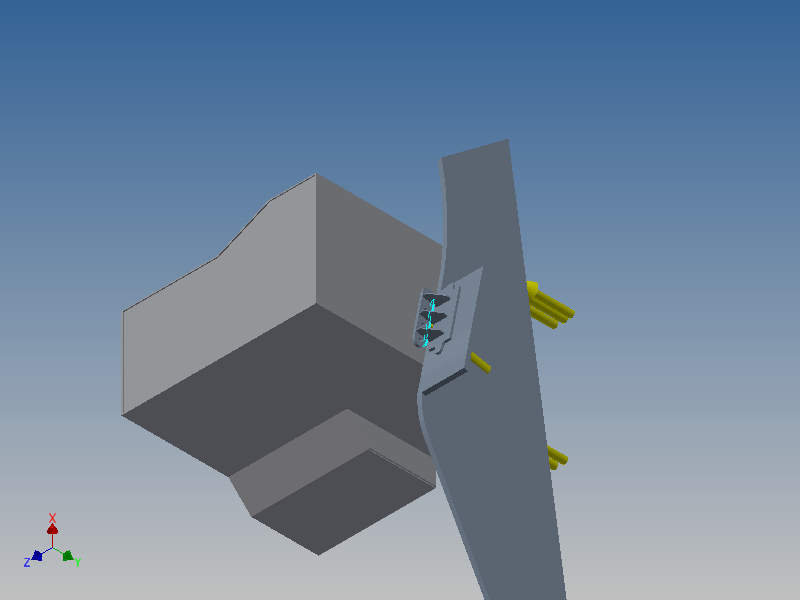
[picture p45: figure]
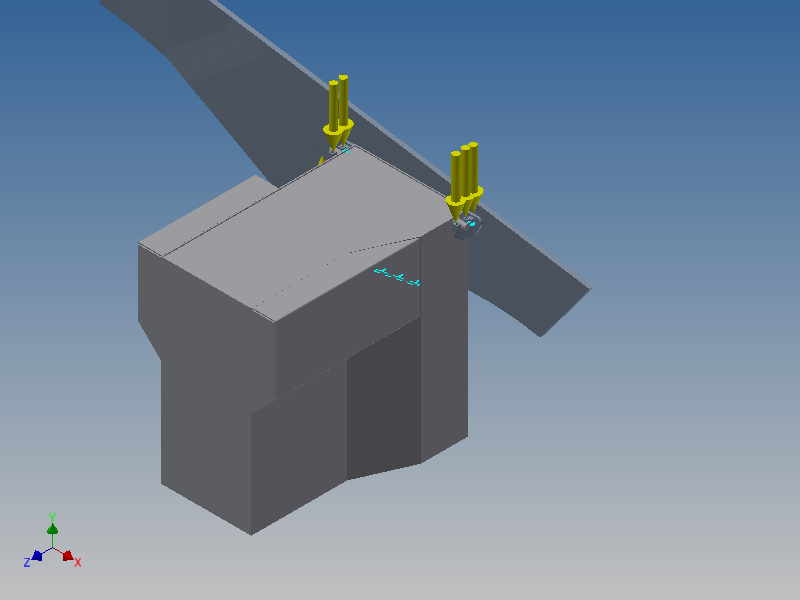
[picture p46: figure]

file:///C:/Users/DOCUMENTOS/Desktop/SIMULACION/ENSAMBLE%20GENERAL%20Stress%20Analysis%20Report%2031_12_2016.html | 29/50

Remote Force:1
Load Type | Remote Force
Magnitude | 88200.000 N
Vector X | -0.000 N
Vector Y | 88200.000 N
Vector Z | 0.000 N
Remote Point X | 0.000 mm
Remote Point Y | 0.000 mm
Remote Point Z | 0.000 mm

Selected Face(s)

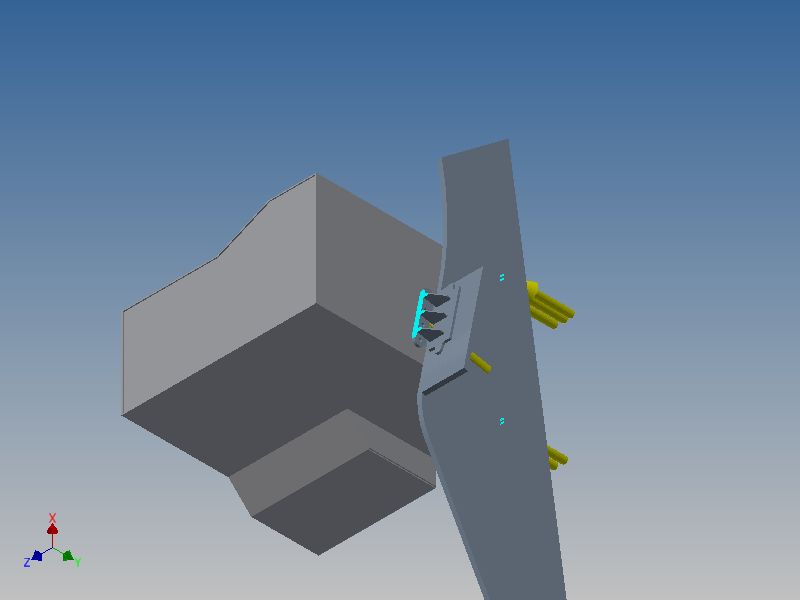
[picture p47: figure]

file:///C:/Users/DOCUMENTOS/Desktop/SIMULACION/ENSAMBLE%20GENERAL%20Stress%20Analysis%20Report%2031_12_2016.html | 30/50

Fixed Constraint:1
Constraint Type Fixed Constraint

Selected Face(s)

file:///C:/Users/DOCUMENTOS/Desktop/SIMULACION/ENSAMBLE%20GENERAL%20Stress%20Analysis%20Report%2031_12_2016.html | 31/50

Contacts (Bonded)
Name | Part Name(s)
Bonded:1 | ESQUELETO 2:1 TANQUE COMB. GENERAL 1:1/TANQUE COMBUSTIBLE_1
Bonded:2 | TANQUE COMB. GENERAL 1:1/TANQUE COMBUSTIBLE_1 TANQUE COMB. GENERAL 1:1/ENSAMBLE CAJON 01_4/CUERPO 1_8
Bonded:3 | TANQUE COMB. GENERAL 1:1/TANQUE COMBUSTIBLE_1 TANQUE COMB. GENERAL 1:1/ENSAMBLE CAJON 01_4/TAPA 1_9
Bonded:4 | TANQUE COMB. GENERAL 1:1/TANQUE COMBUSTIBLE_1 TANQUE COMB. GENERAL 1:1/ENSAMBLE CAJON 01_4/TAPA 1_10
Bonded:5 | TANQUE COMB. GENERAL 1:1/TANQUE COMBUSTIBLE_1 TANQUE COMB. GENERAL 1:1/ENSAMBLE CAJON 02_5/CUERPO 2_6
Bonded:6 | TANQUE COMB. GENERAL 1:1/TANQUE COMBUSTIBLE_1 TANQUE COMB. GENERAL 1:1/ENSAMBLE CAJON 02_5/TAPA 2_7
Bonded:7 | TANQUE COMB. GENERAL 1:1/ENSAMBLE CAJON 01_4/CUERPO 1_8 TANQUE COMB. GENERAL 1:1/ENSAMBLE CAJON 01_4/TAPA 1_9
Bonded:8 | TANQUE COMB. GENERAL 1:1/ENSAMBLE CAJON 01_4/CUERPO 1_8 TANQUE COMB. GENERAL 1:1/ENSAMBLE CAJON 01_4/TAPA 1_9
Bonded:9 | TANQUE COMB. GENERAL 1:1/ENSAMBLE CAJON 01_4/CUERPO 1_8 TANQUE COMB. GENERAL 1:1/ENSAMBLE CAJON 01_4/TAPA 1_10
Bonded:10 | TANQUE COMB. GENERAL 1:1/ENSAMBLE CAJON 01_4/CUERPO 1_8 TANQUE COMB. GENERAL 1:1/ENSAMBLE CAJON 01_4/TAPA 1_10
Bonded:11 | TANQUE COMB. GENERAL 1:1/ENSAMBLE CAJON 02_5/CUERPO 2_6 TANQUE COMB. GENERAL 1:1/ENSAMBLE CAJON 02_5/TAPA 2_7
Bonded:12 | TANQUE COMB. GENERAL 1:1/ENSAMBLE CAJON 02_5/CUERPO 2_6 TANQUE COMB. GENERAL 1:1/ENSAMBLE CAJON 02_5/TAPA 2_7

### Results

Reaction Force and Moment on Constraints
Constraint Name | Reaction Force | Reaction Moment
Magnitude | Component (X,Y,Z) | Magnitude | Component (X,Y,Z)
Fixed Constraint:1 | 140394 N | -17099.8 N | 149460 N m | -20534.5 N m
| | 139349 N | | 968.664 N m
| | 0 N | | 148040 N m

Result Summary
Name | Minimum | Maximum
Volume | 686139000 mm^3
Mass | 5386.19 kg

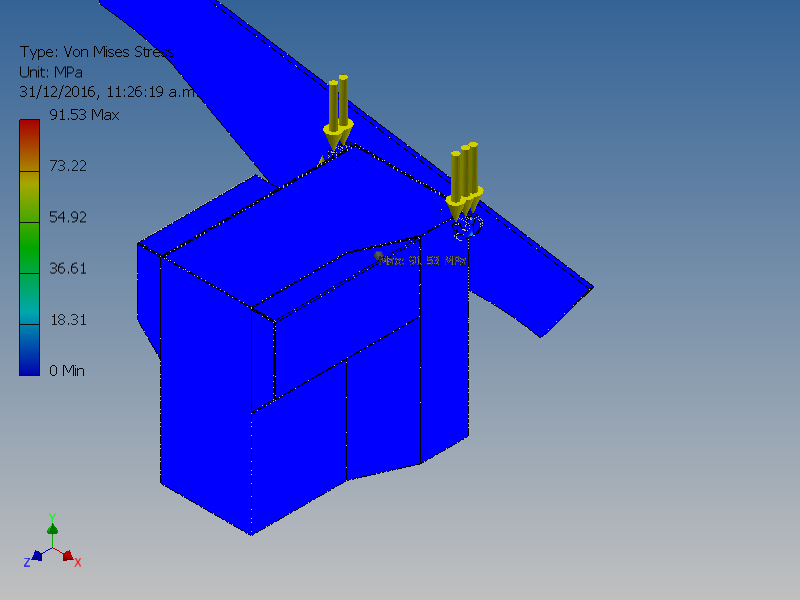
[picture p48: figure]

file:///C:/Users/DOCUMENTOS/Desktop/SIMULACION/ENSAMBLE%20GENERAL%20Stress%20Analysis%20Report%2031_12_2016.html | 32/50
Mass | 5386.19 kg
Von Mises Stress
0.00000397188 MPa | 91.5293 MPa
1st Principal Stress | -13.345 MPa | 60.1526 MPa
3rd Principal Stress | -107.084 MPa | 10.1959 MPa
Displacement | 0 mm | 3517.86 mm
Safety Factor | 2.26157 ul | 15 ul
Stress XX | -26.6768 MPa | 13.2612 MPa
Stress XY | -6.06549 MPa | 32.0339 MPa
Stress XZ | -9.87063 MPa | 9.23259 MPa
Stress YY | -90.6338 MPa | 54.0458 MPa
Stress YZ | -15.9286 MPa | 15.0621 MPa
Stress ZZ | -34.9971 MPa | 35.8052 MPa
X Displacement | -21.4164 mm | 21.7624 mm
Y Displacement | -3517.86 mm | 0.0452763 mm
Z Displacement | -37.3655 mm | 36.8086 mm
Equivalent Strain | 0.0000000000166942 ul | 0.000397647 ul
1st Principal Strain | -0.00000117335 ul | 0.000277827 ul
3rd Principal Strain | -0.000465235 ul | 0.00000386723 ul
Strain XX | -0.0000982477 ul | 0.0000753744 ul
Strain XY | -0.0000375482 ul | 0.000198305 ul
Strain XZ | -0.0000611039 ul | 0.0000571542 ul
Strain YY | -0.000363401 ul | 0.000240024 ul
Strain YZ | -0.0000986055 ul | 0.0000932414 ul
Strain ZZ | -0.000159977 ul | 0.000157142 ul
Contact Pressure | 0 MPa | 106.705 MPa
Contact Pressure X | -71.8119 MPa | 104.253 MPa
Contact Pressure Y | -25.1967 MPa | 21.9462 MPa
Contact Pressure Z | -11.3518 MPa | 9.72351 MPa

Figures

Von Mises Stress

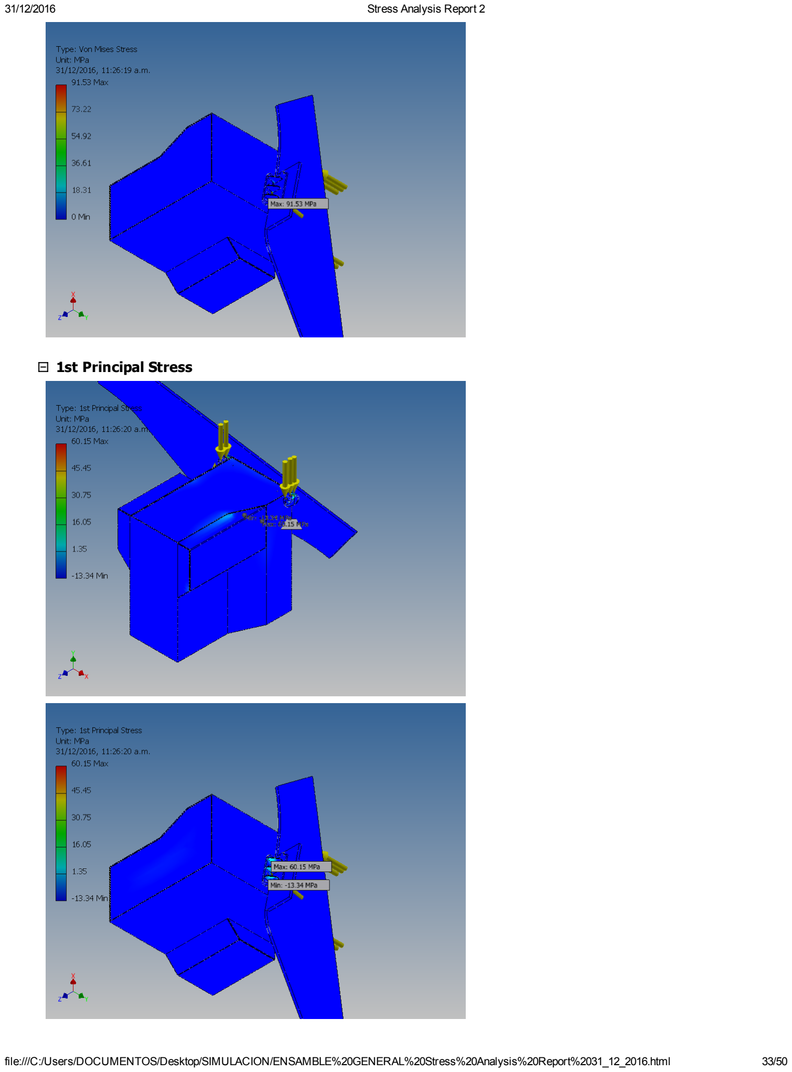
[picture p49: page 33]

file:///C:/Users/DOCUMENTOS/Desktop/SIMULACION/ENSAMBLE%20GENERAL%20Stress%20Analysis%20Report%2031_12_2016.html | 33/50

1st Principal Stress

3rd Principal Stress

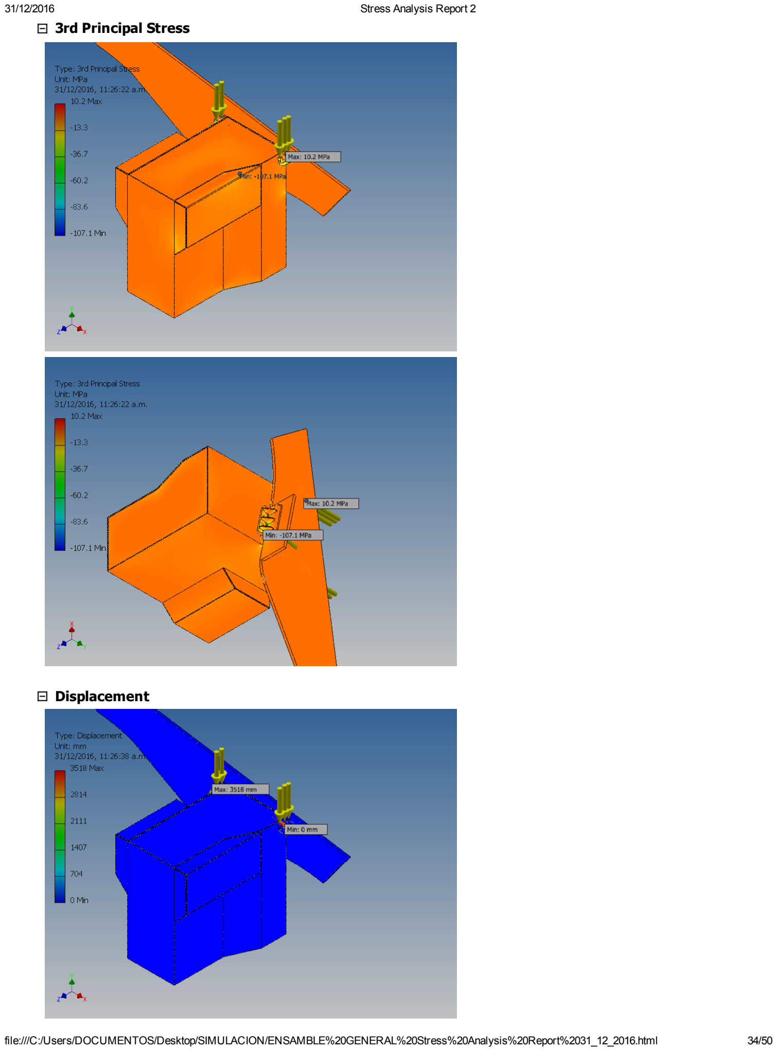
[picture p50: page 34]

file:///C:/Users/DOCUMENTOS/Desktop/SIMULACION/ENSAMBLE%20GENERAL%20Stress%20Analysis%20Report%2031_12_2016.html | 34/50

3rd Principal Stress

Displacement

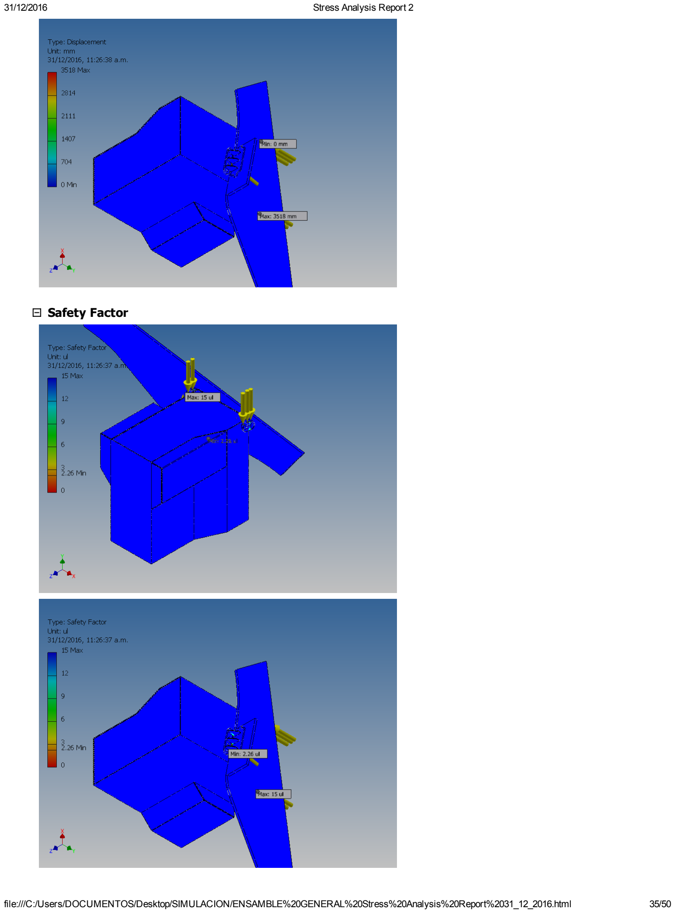
[picture p51: page 35]

file:///C:/Users/DOCUMENTOS/Desktop/SIMULACION/ENSAMBLE%20GENERAL%20Stress%20Analysis%20Report%2031_12_2016.html | 35/50

Safety Factor

Stress XX

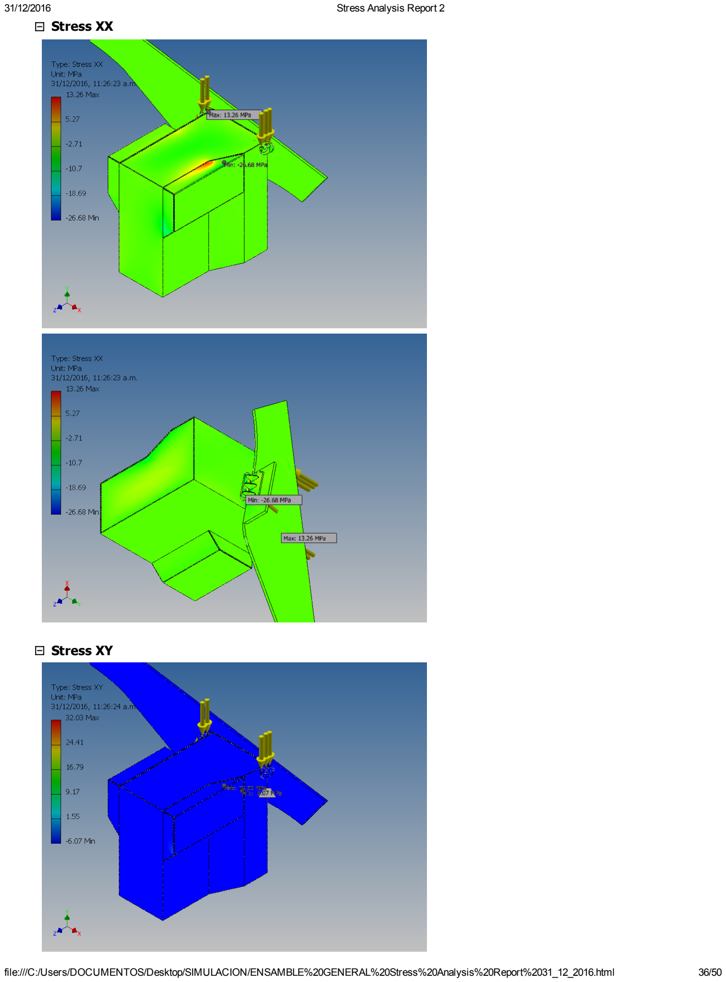
[picture p52: page 36]

file:///C:/Users/DOCUMENTOS/Desktop/SIMULACION/ENSAMBLE%20GENERAL%20Stress%20Analysis%20Report%2031_12_2016.html | 36/50

Stress XX

Stress XY

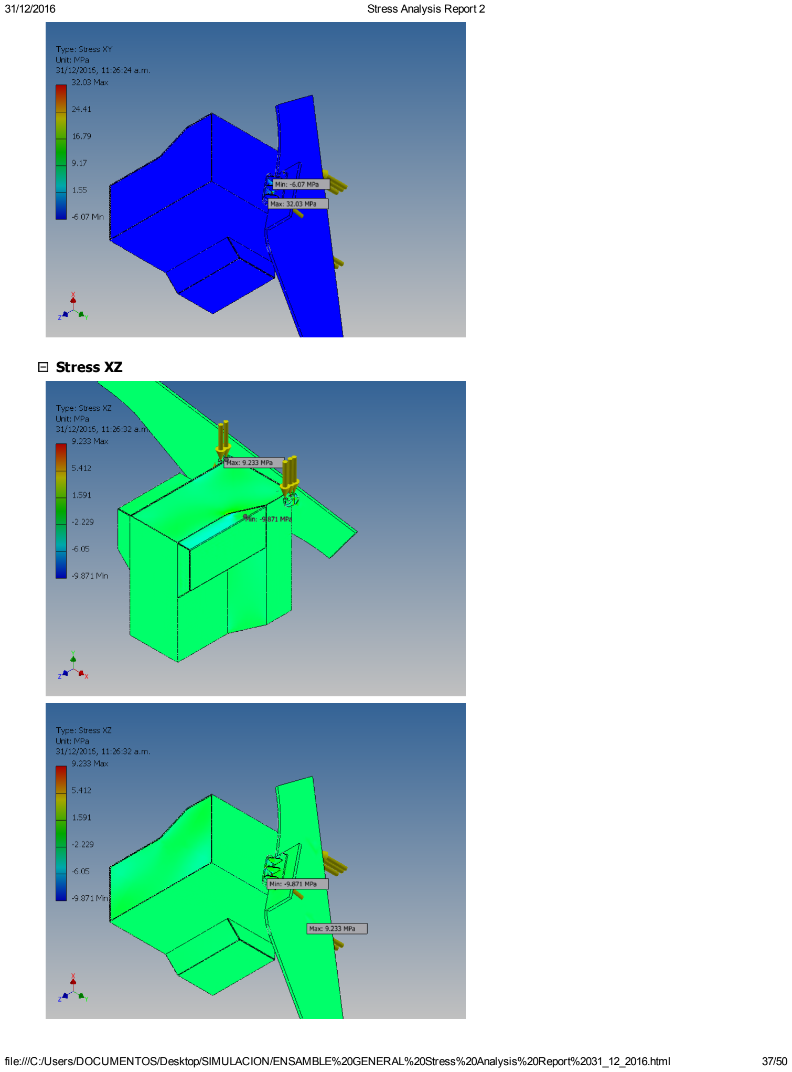
[picture p53: page 37]

file:///C:/Users/DOCUMENTOS/Desktop/SIMULACION/ENSAMBLE%20GENERAL%20Stress%20Analysis%20Report%2031_12_2016.html | 37/50

Stress XZ

Stress YY

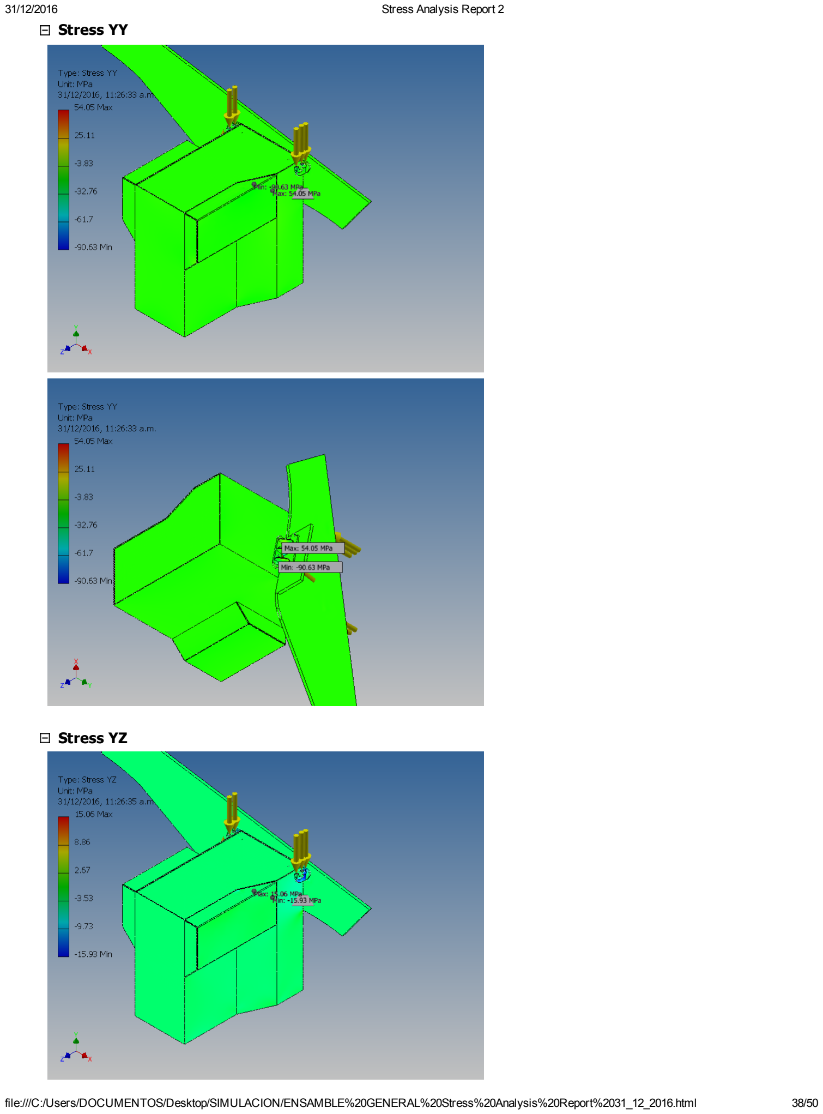
[picture p54: page 38]

file:///C:/Users/DOCUMENTOS/Desktop/SIMULACION/ENSAMBLE%20GENERAL%20Stress%20Analysis%20Report%2031_12_2016.html | 38/50

Stress YY

Stress YZ

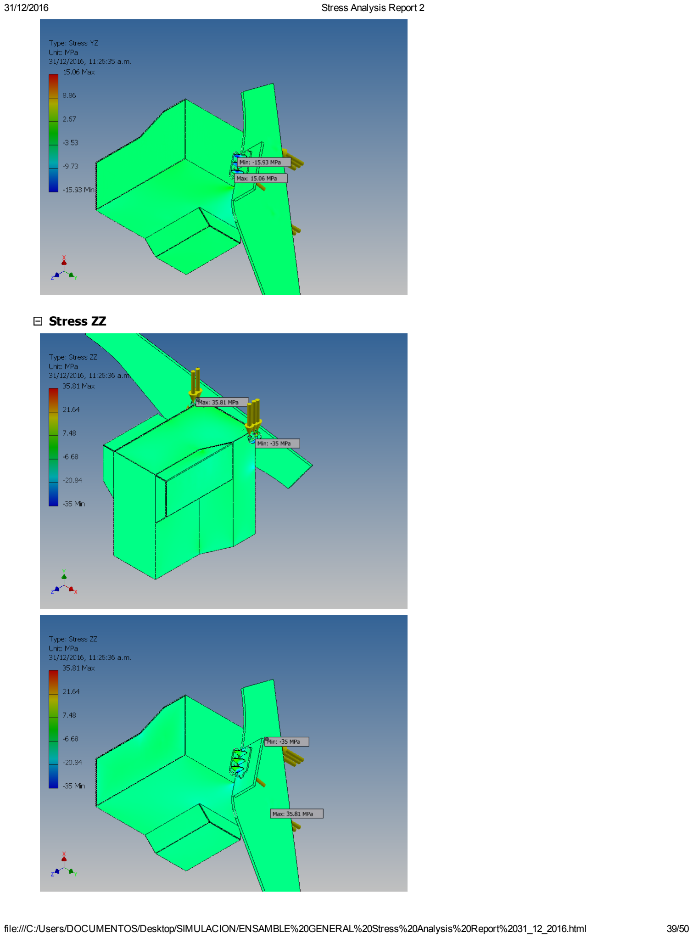
[picture p55: page 39]

file:///C:/Users/DOCUMENTOS/Desktop/SIMULACION/ENSAMBLE%20GENERAL%20Stress%20Analysis%20Report%2031_12_2016.html | 39/50

Stress ZZ

X Displacement

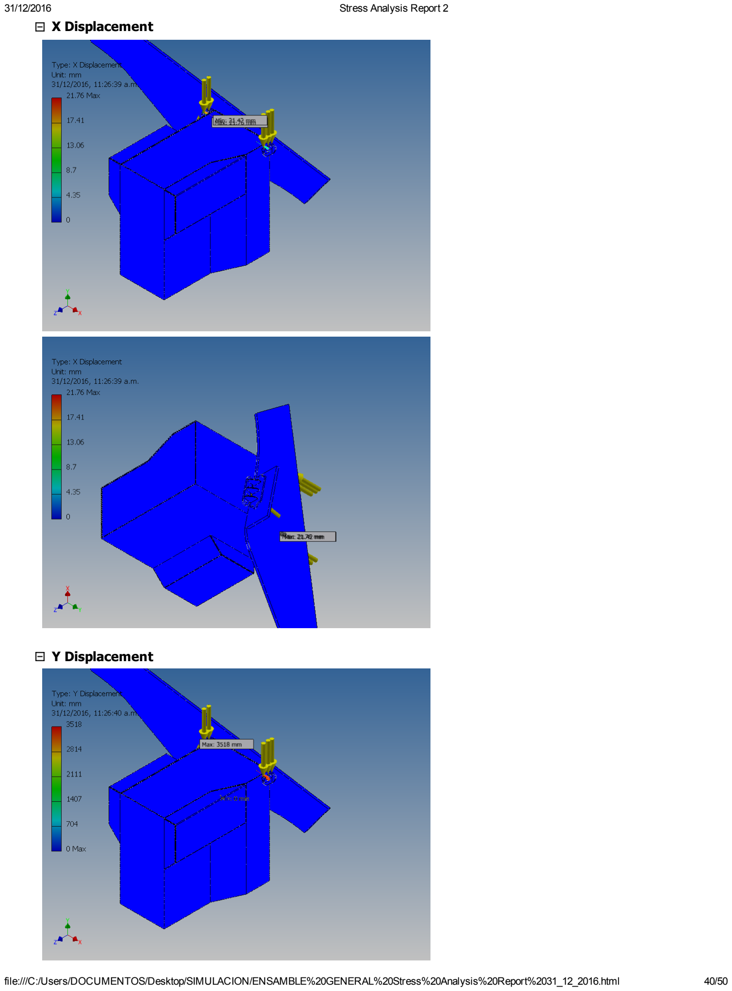
[picture p56: page 40]

file:///C:/Users/DOCUMENTOS/Desktop/SIMULACION/ENSAMBLE%20GENERAL%20Stress%20Analysis%20Report%2031_12_2016.html | 40/50

X Displacement

Y Displacement

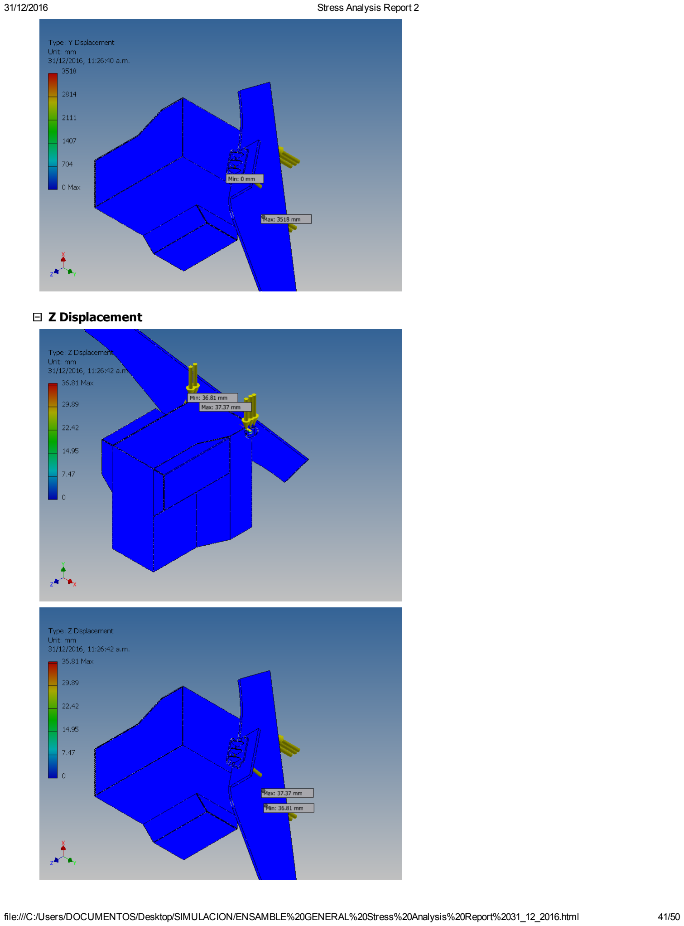
[picture p57: page 41]

file:///C:/Users/DOCUMENTOS/Desktop/SIMULACION/ENSAMBLE%20GENERAL%20Stress%20Analysis%20Report%2031_12_2016.html | 41/50

Z Displacement

Equivalent Strain

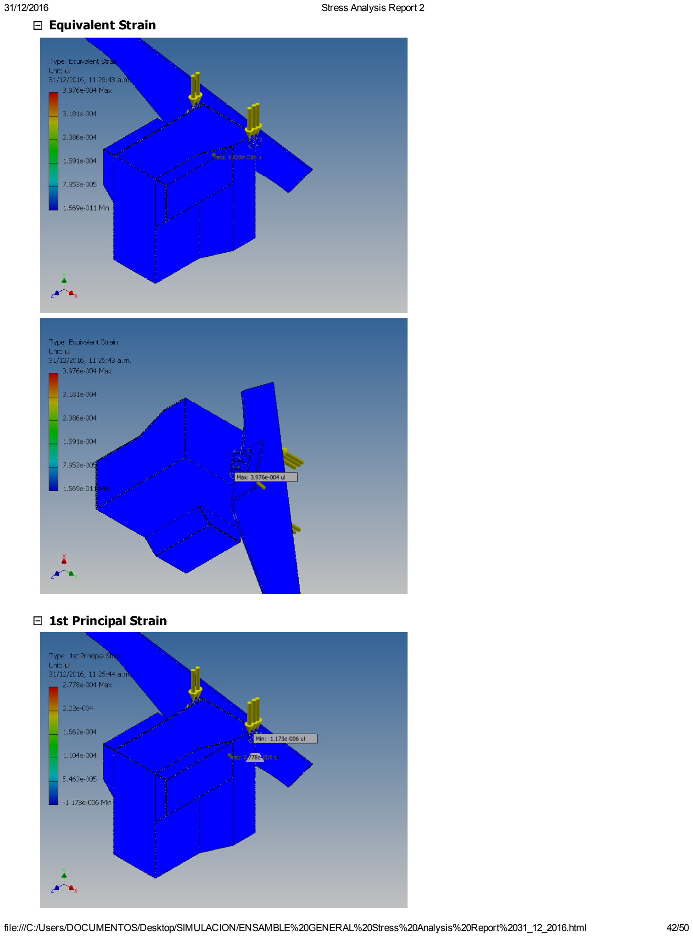
[picture p58: page 42]

file:///C:/Users/DOCUMENTOS/Desktop/SIMULACION/ENSAMBLE%20GENERAL%20Stress%20Analysis%20Report%2031_12_2016.html | 42/50

Equivalent Strain

1st Principal Strain

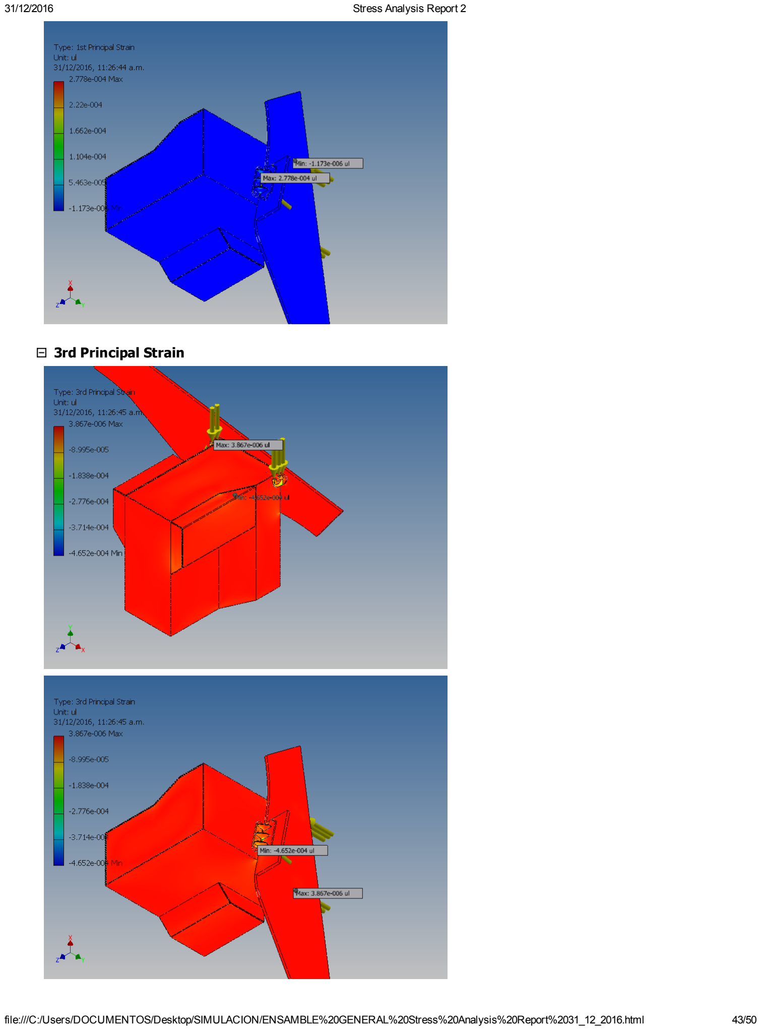
[picture p59: page 43]

file:///C:/Users/DOCUMENTOS/Desktop/SIMULACION/ENSAMBLE%20GENERAL%20Stress%20Analysis%20Report%2031_12_2016.html | 43/50

3rd Principal Strain

Strain XX

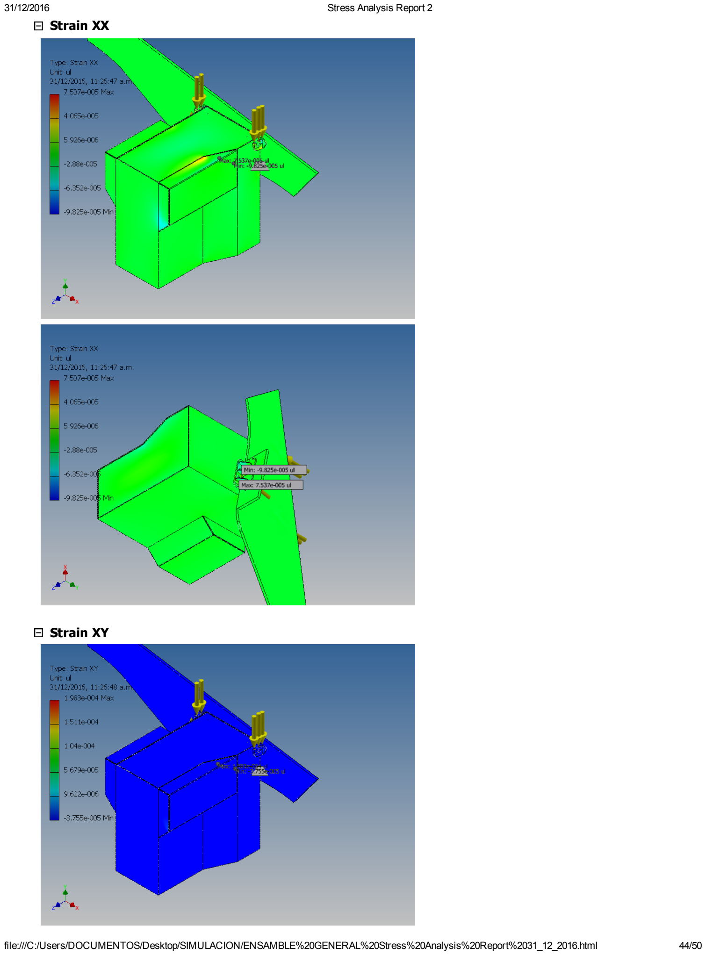
[picture p60: page 44]

file:///C:/Users/DOCUMENTOS/Desktop/SIMULACION/ENSAMBLE%20GENERAL%20Stress%20Analysis%20Report%2031_12_2016.html | 44/50

Strain XX

Strain XY

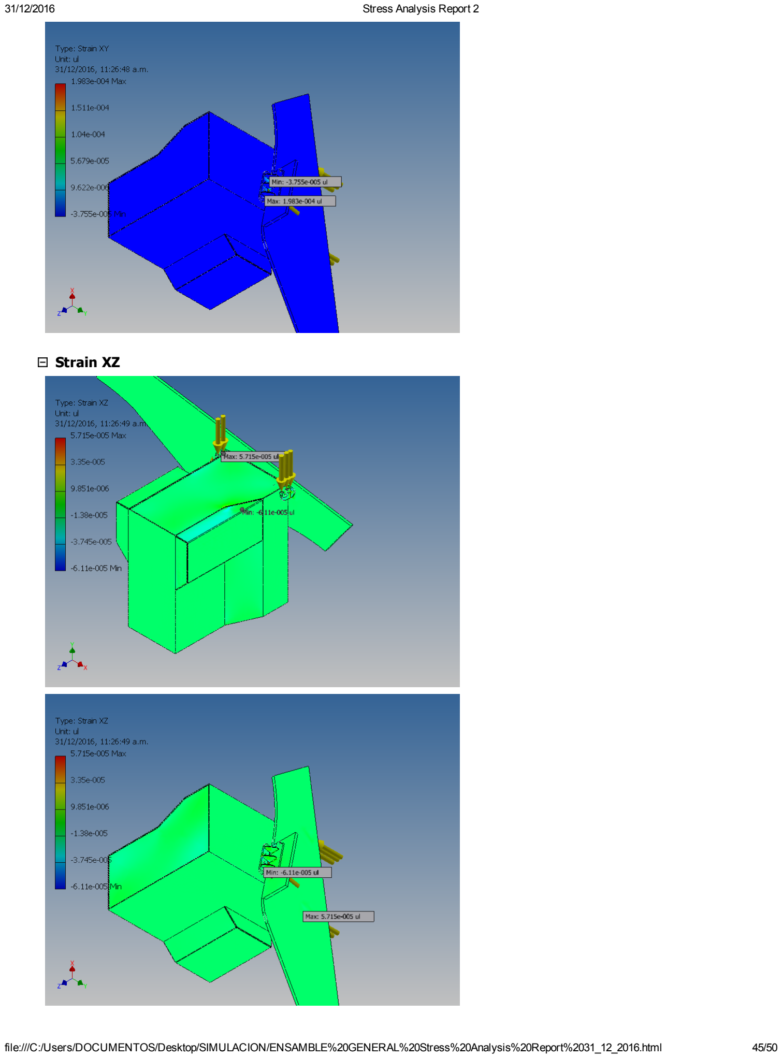
[picture p61: page 45]

file:///C:/Users/DOCUMENTOS/Desktop/SIMULACION/ENSAMBLE%20GENERAL%20Stress%20Analysis%20Report%2031_12_2016.html | 45/50

Strain XZ

Strain YY

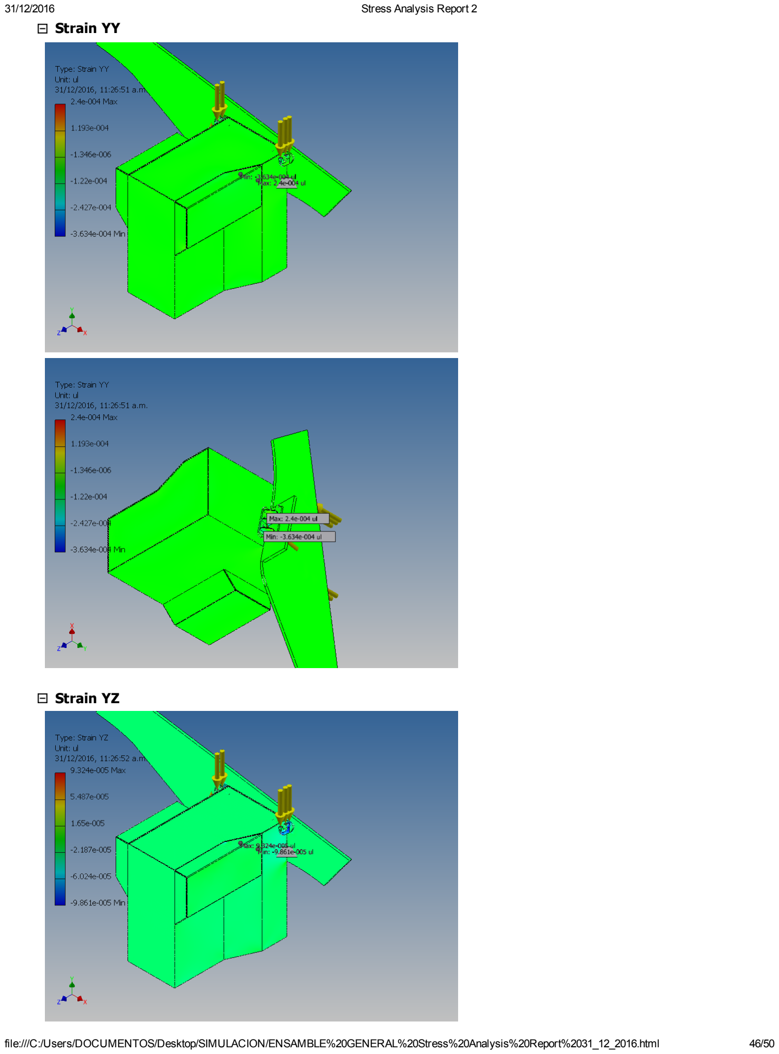
[picture p62: page 46]

file:///C:/Users/DOCUMENTOS/Desktop/SIMULACION/ENSAMBLE%20GENERAL%20Stress%20Analysis%20Report%2031_12_2016.html | 46/50

Strain YY

Strain YZ

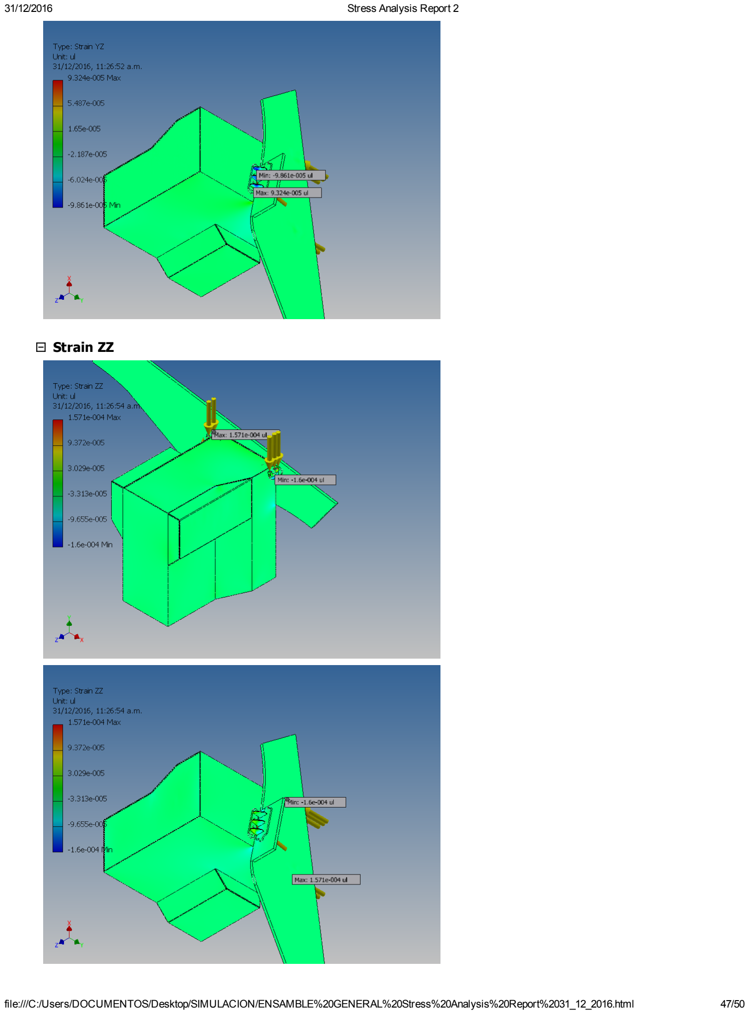
[picture p63: page 47]

file:///C:/Users/DOCUMENTOS/Desktop/SIMULACION/ENSAMBLE%20GENERAL%20Stress%20Analysis%20Report%2031_12_2016.html | 47/50

Strain ZZ

Contact Pressure

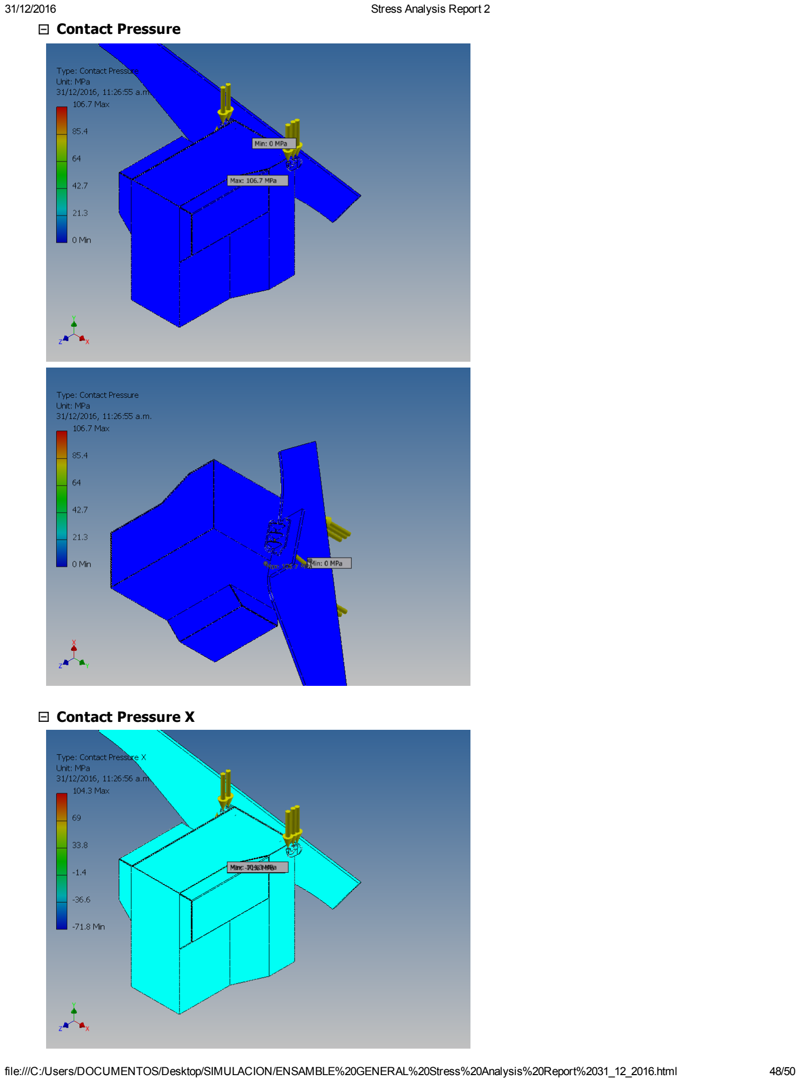
[picture p64: page 48]

file:///C:/Users/DOCUMENTOS/Desktop/SIMULACION/ENSAMBLE%20GENERAL%20Stress%20Analysis%20Report%2031_12_2016.html | 48/50

Contact Pressure

Contact Pressure X

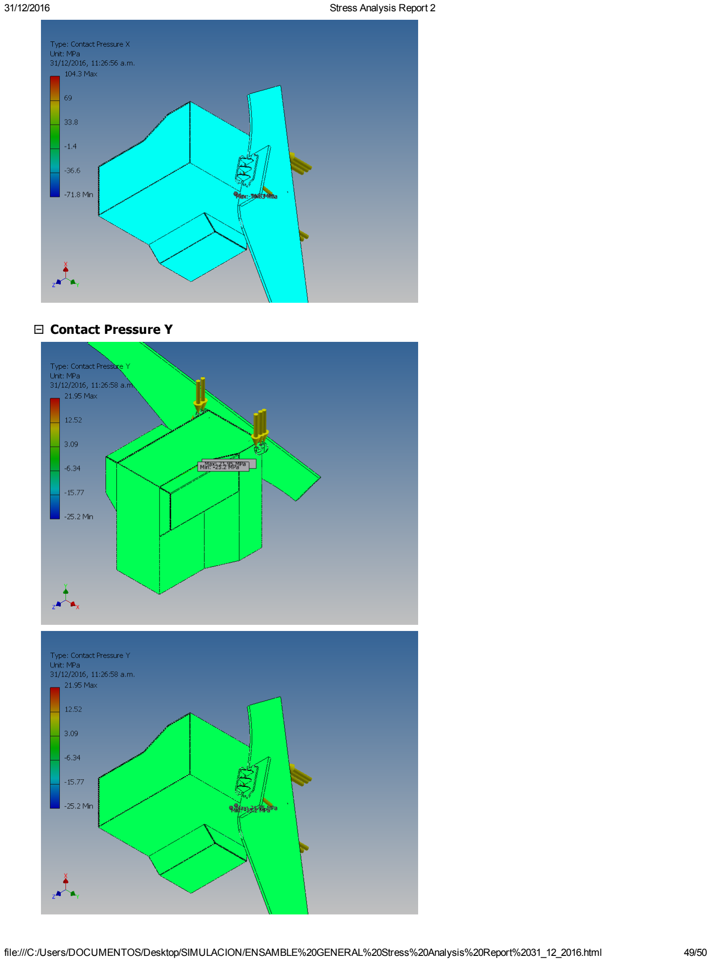
[picture p65: page 49]

file:///C:/Users/DOCUMENTOS/Desktop/SIMULACION/ENSAMBLE%20GENERAL%20Stress%20Analysis%20Report%2031_12_2016.html | 49/50

Contact Pressure Y

Contact Pressure Z

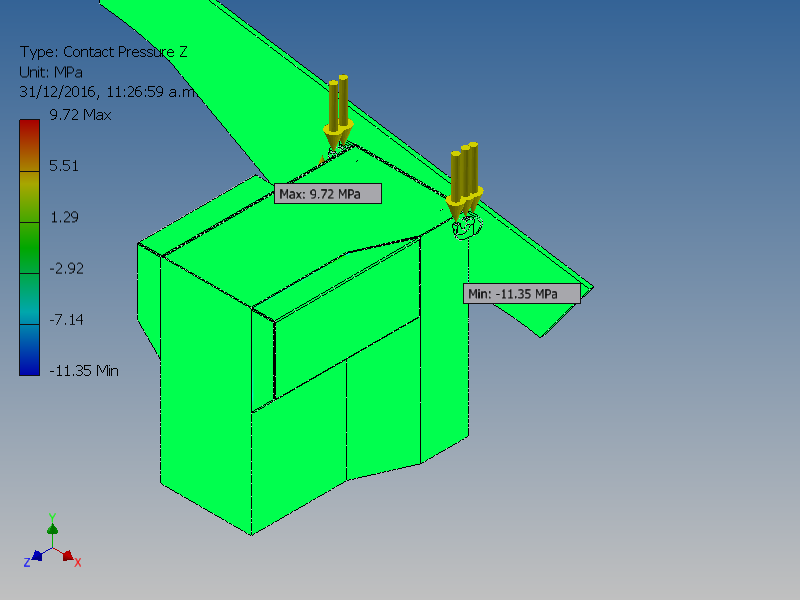
[picture p66: figure]
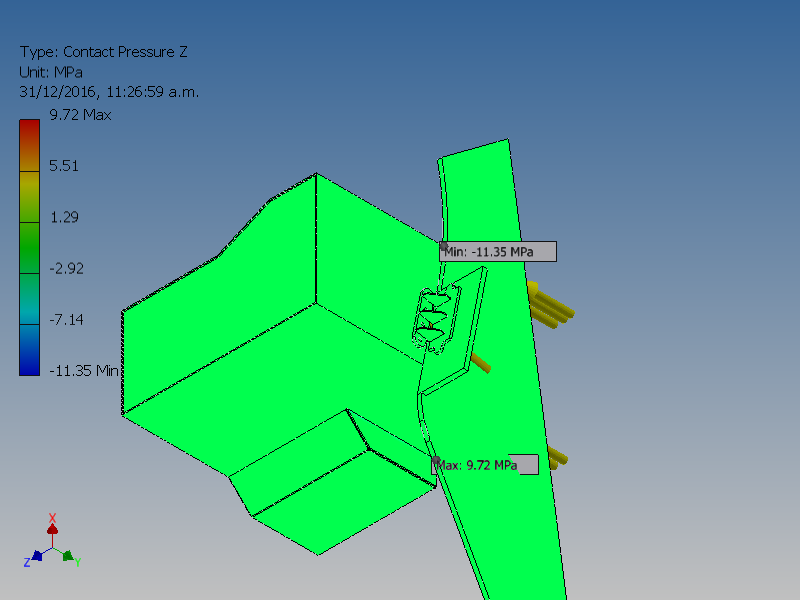
[picture p67: figure]

file:///C:/Users/DOCUMENTOS/Desktop/SIMULACION/ENSAMBLE%20GENERAL%20Stress%20Analysis%20Report%2031_12_2016.html | 50/50

Contact Pressure Z

C:\Users\DOCUMENTOS\Desktop\SIMULACION\ENSAMBLE GENERAL.iam
