scedillo-wq/TanqueComb/DISTANCIAS ENTRE NEUMATICOS.pdf

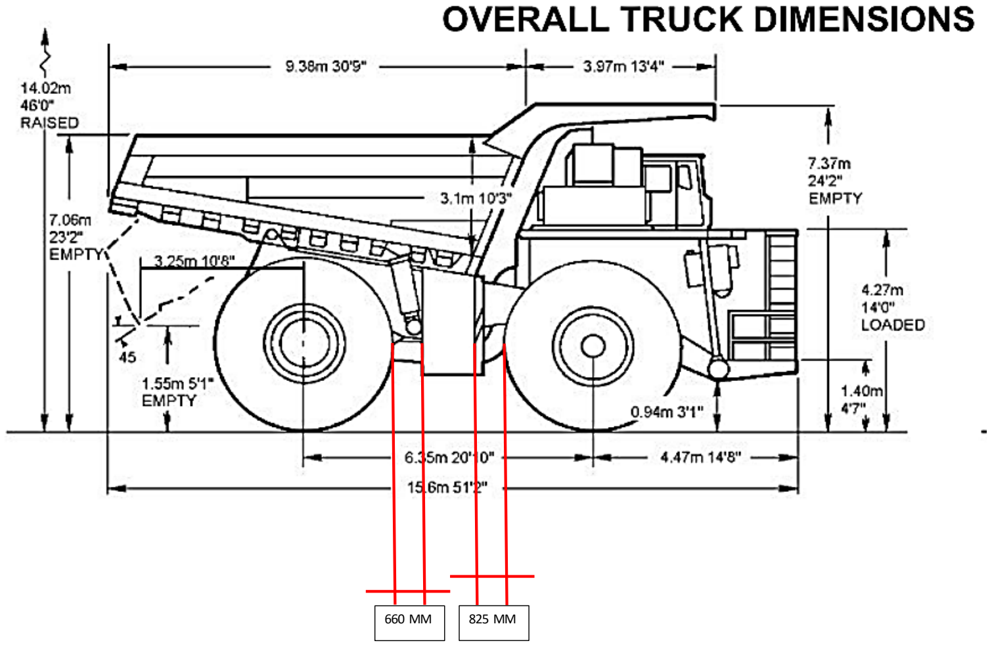
[picture p68: page 1]

660 MM 825 MM
