scedillo-wq/TanqueComb/Fuel Tank Project.pptx

## Fuel System

Fuel Tank Project

PSG EDT

## Fuel Tank Project – Proposal

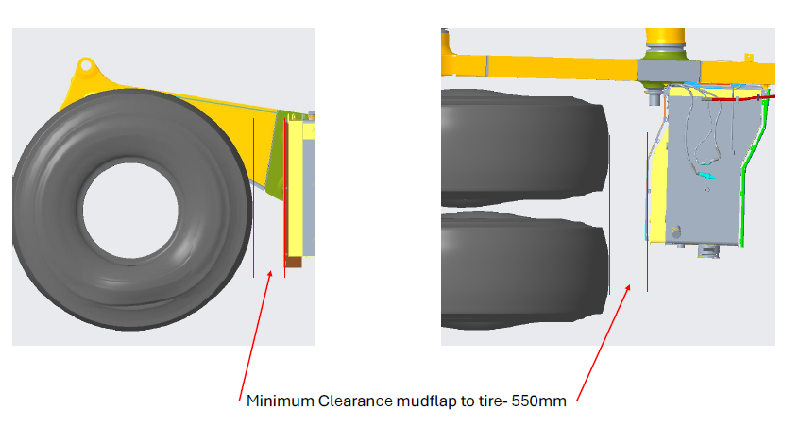
[picture p69: figure]
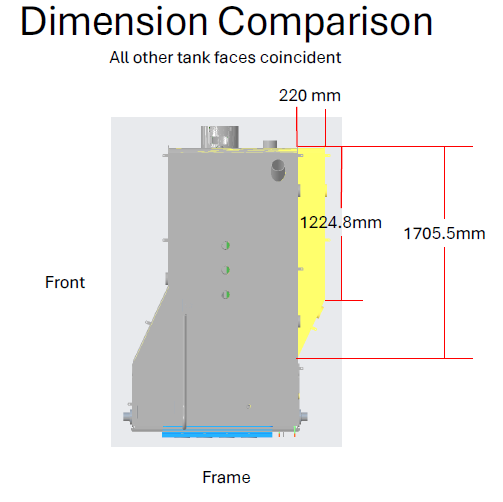
[picture p70: figure]

Notes: 1585 galones

## Fuel Tank Project – Inspection on Field ( Clearance without modification)

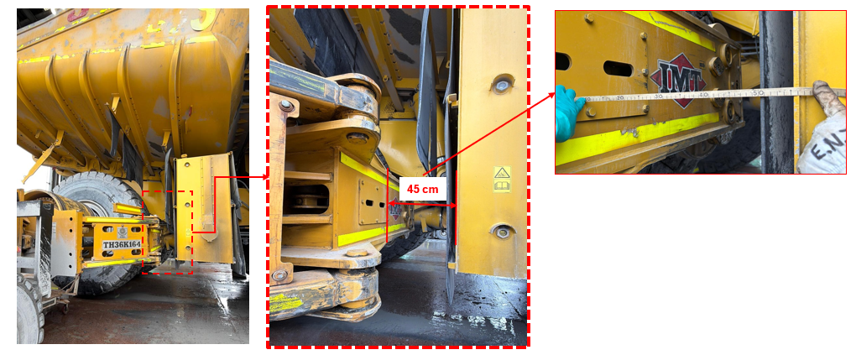
[picture p71: figure]

## Fuel Tank Project – Inspection on Field(( Clearance with modification)

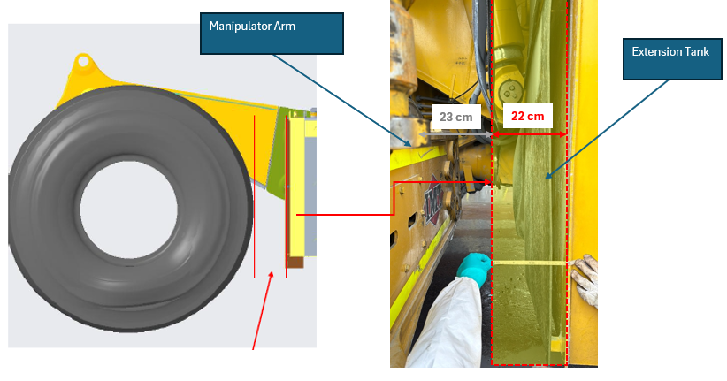
[picture p72: figure]

## Slide 5
