scedillo-wq/TanqueComb/Fuel Tank Projectss.pptx

## Fuel System

Fuel Tank Project

PSG EDT

## Fuel Tank Project – Proposal


Notes: 1585 galones

## Fuel Tank Project – Proposal

Notes: 1585 galones

## Fuel Tank Project – Inspection on Field ( Clearance without modification)


## Fuel Tank Project – Inspection on Field(( Clearance with modification)


## Slide 6

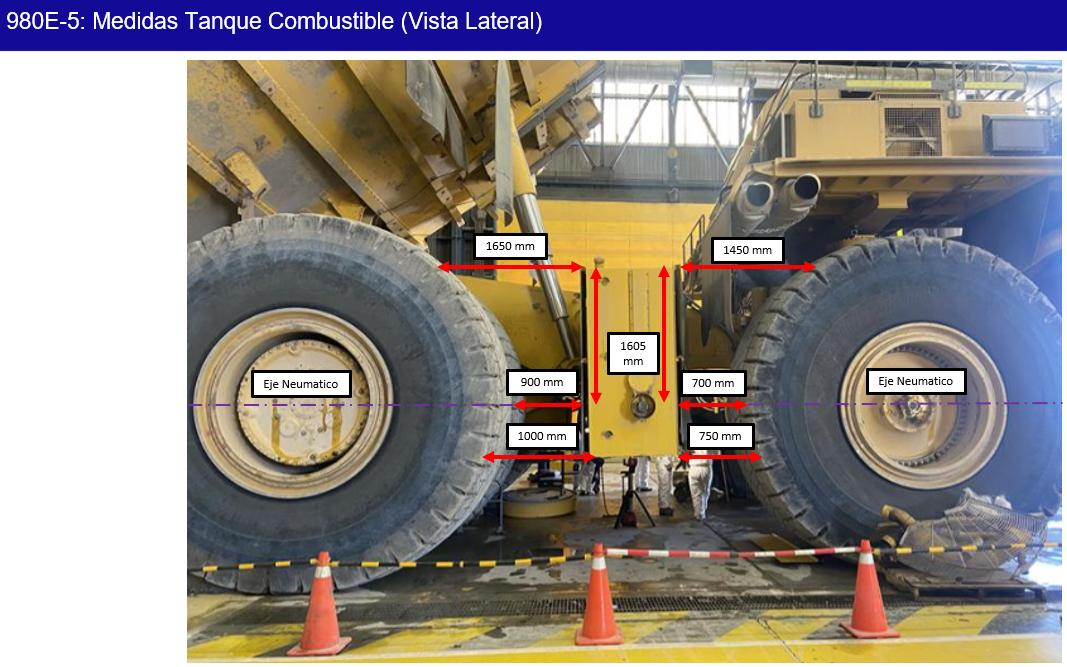
[picture p73: figure]

## Slide 7
