scedillo-wq/TanqueComb/Marco P_Proyecto - Ampliación de capacidad de tanque (00000003).pdf

### Ampliación de capacidad de almacenamiento en tanque de combustible Camión 930E4

## Marco Perú

2017

## Objetivo

- Reducir la cantidad de veces por año que el
camión | 930E | ingresa | al | surtidor | para
abastecerse de combustible, para una mayor productividad minera.

## Antecedentes

- La capacidad actual del camión 930E es de: 1400 galones.
- El peso del tanque de combustible vacío es de aproximadamente: 2100 Kg.
- Periodo para que el camión se dirija al surtidor: 18 horas.
- Máximo consumo de combustible:70 gal/hora.

## Consideraciones:

- Para efectos de éste análisis, se considerará un consumo de combustible promedio de 60
gal/hora, | se | desea | que | el | periodo | de
abastecimiento de combustible se incremente de 18 a 21 horas, por lo cual la capacidad de almacenamiento adicional debe ser de 180 galones.
- El volumen extra de diesel deberá consumirse en las primeras horas.
- Las modificaciones no deberán obstaculizar el proceso actual de mantenimiento.

## Análisis:

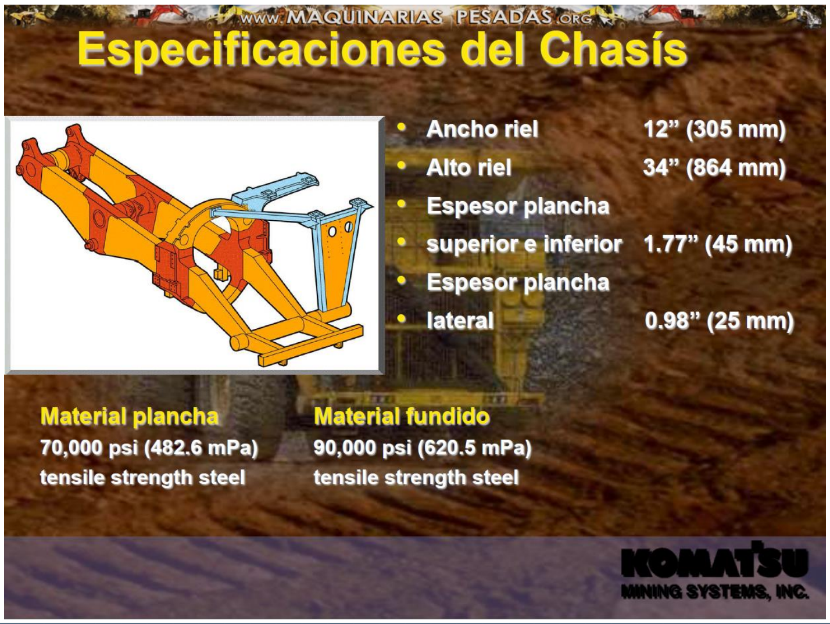
[picture p74: figure]

Vista superior referencial:

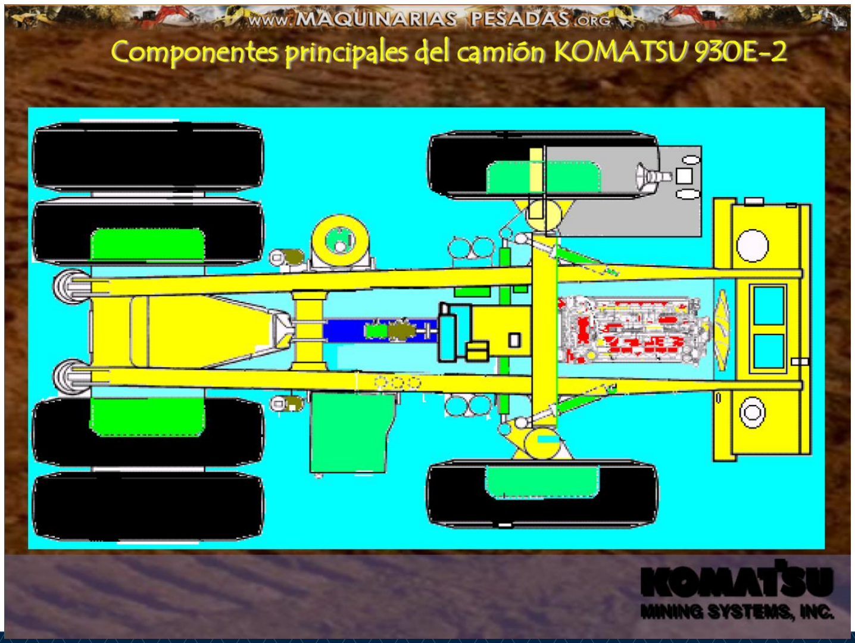
[picture p75: figure]

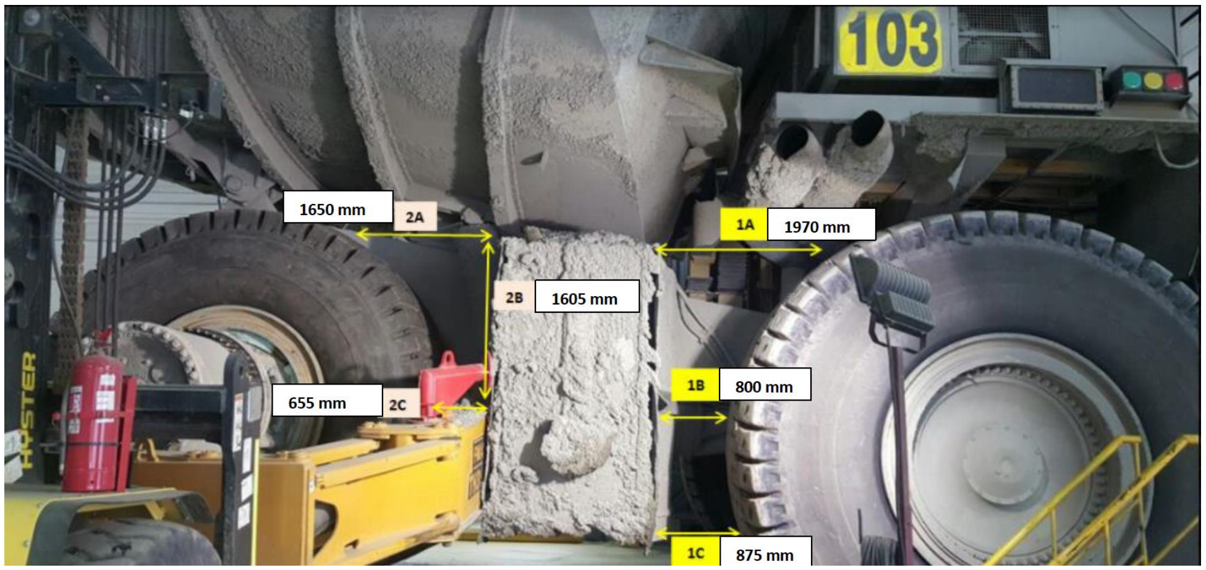
[picture p76: figure]

Dimensiones del tanque actual:

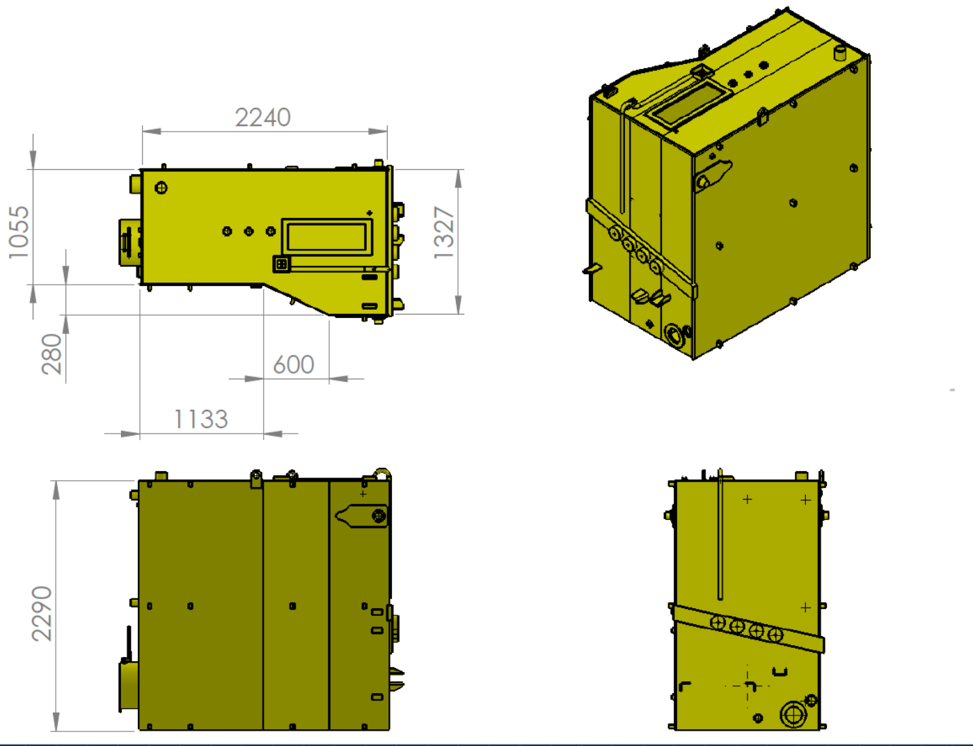
[picture p77: figure]

Vista con extensiones:

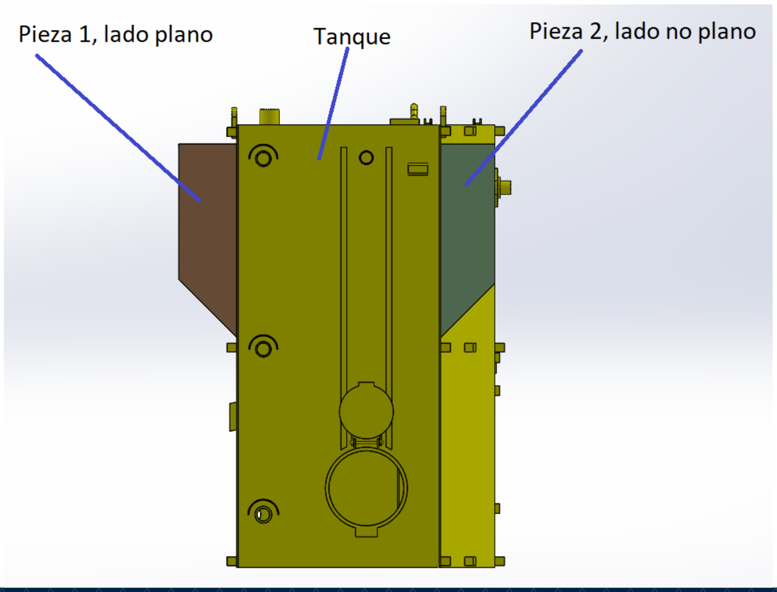
[picture p78: figure]

Pieza 2: lado no plano
al nivel original

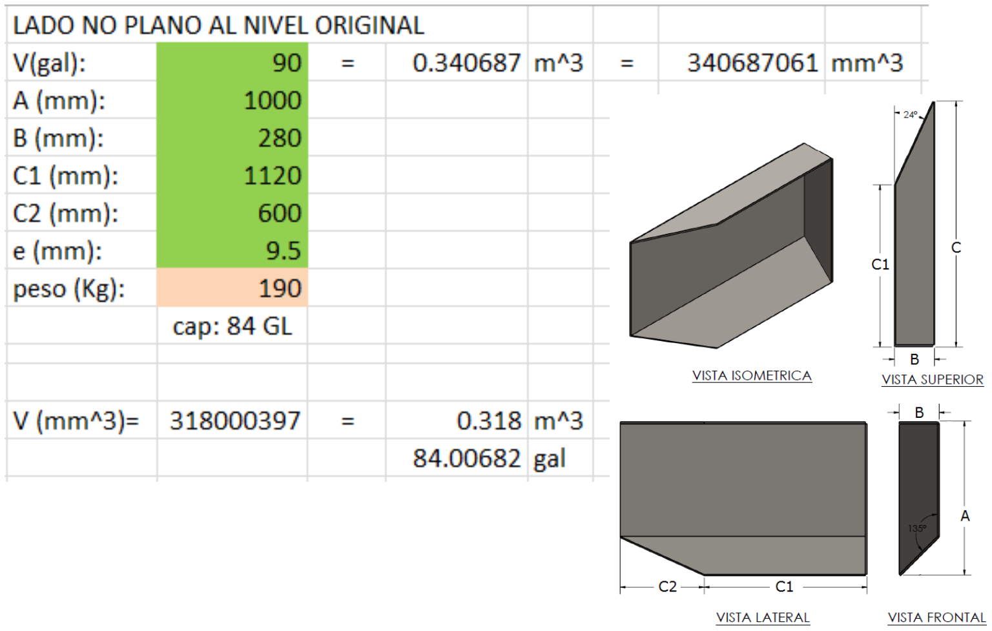
[picture p79: figure]

Pieza 1: lado plano

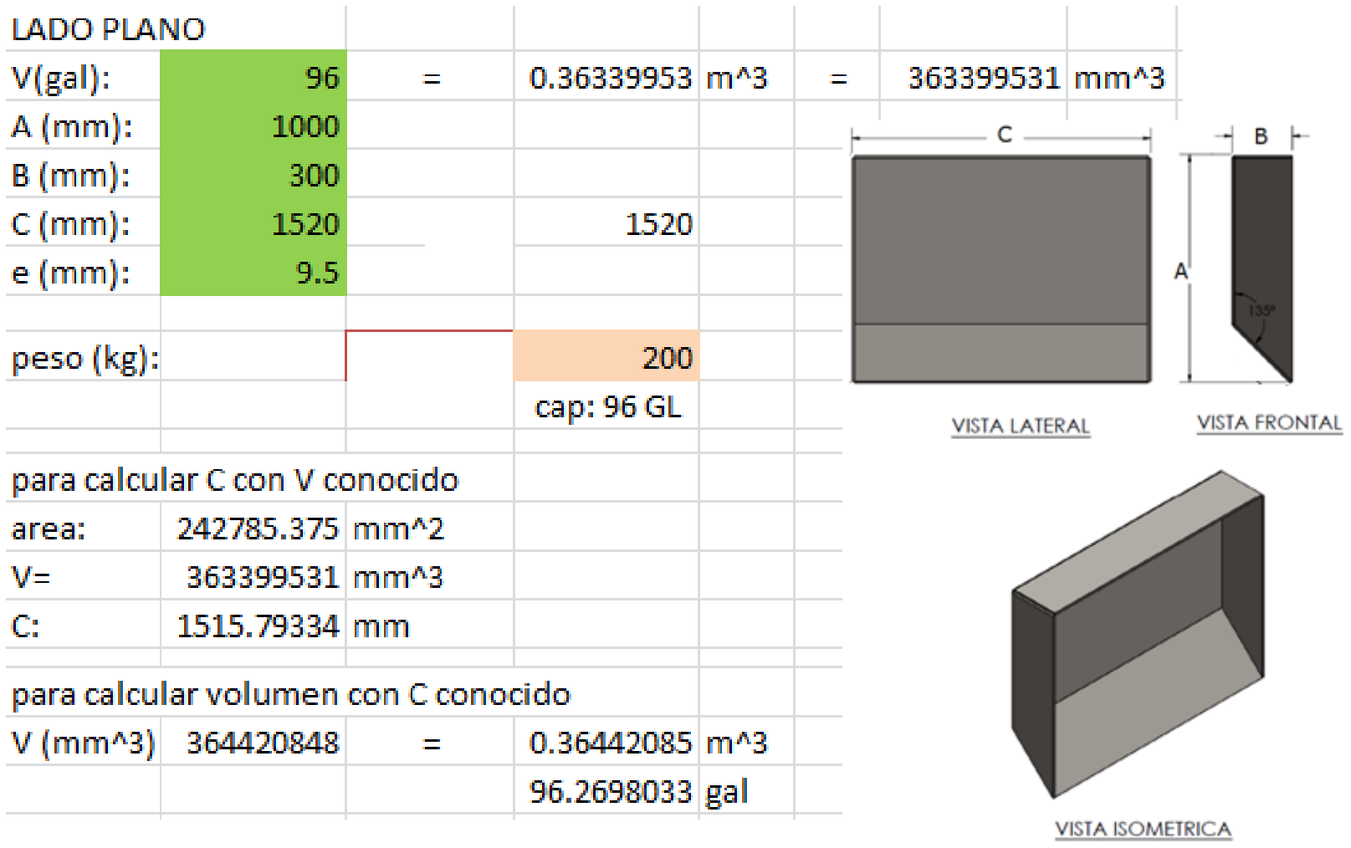
[picture p80: figure]

Pieza 1: lado plano (opción 2)

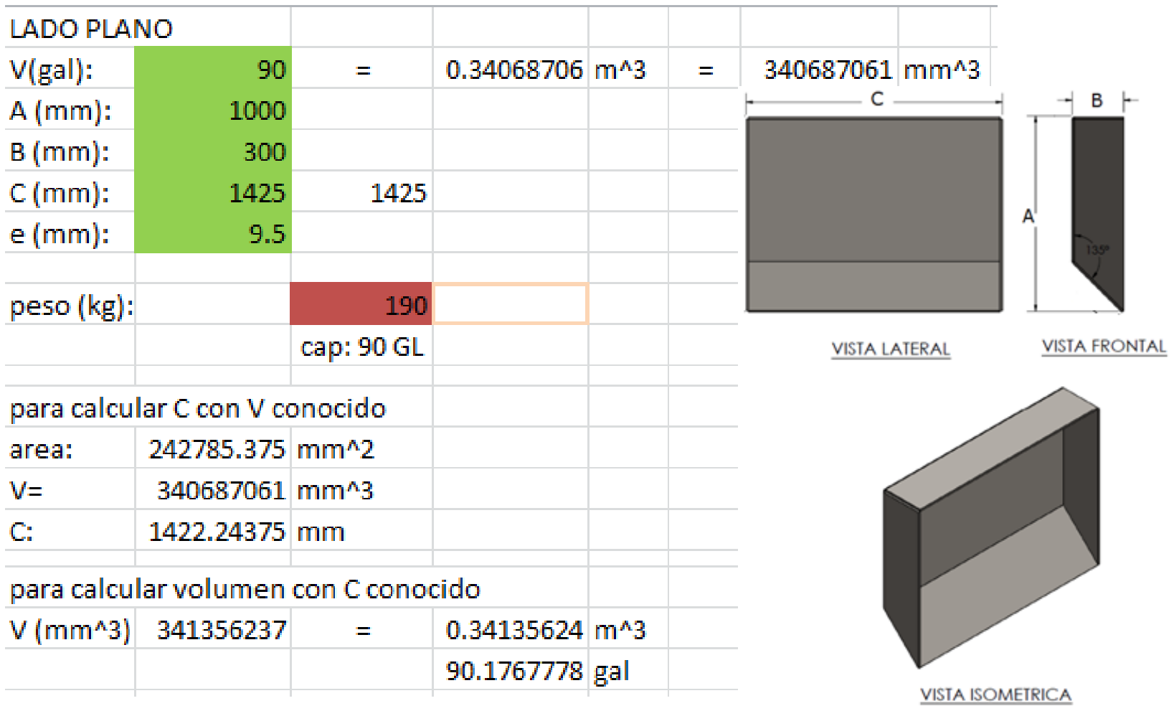
[picture p81: figure]

Pieza 2: lado no plano
sobresaliente (opción 2)

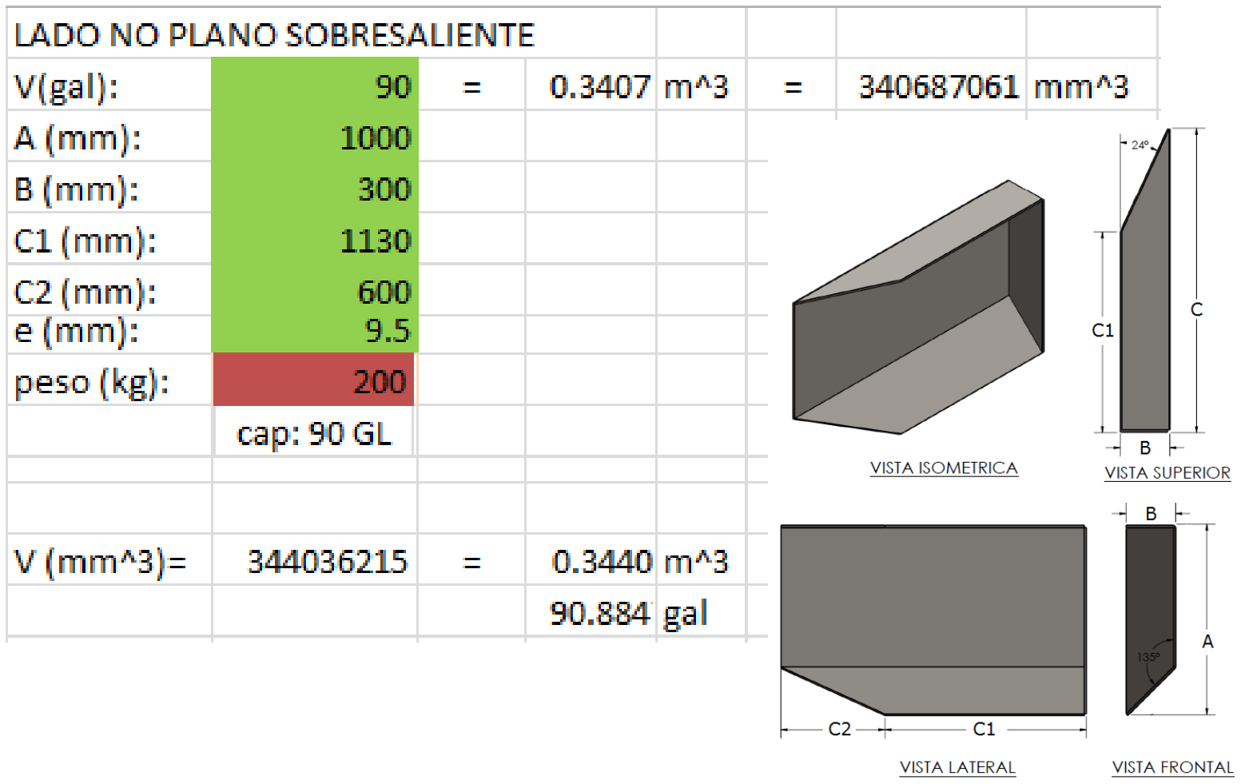
[picture p82: figure]
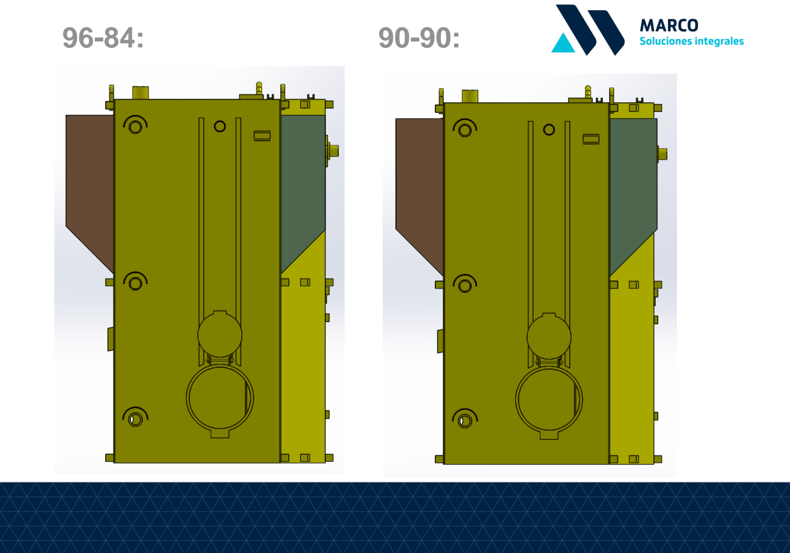
[picture p83: page 14]

96-84: | 90-90:

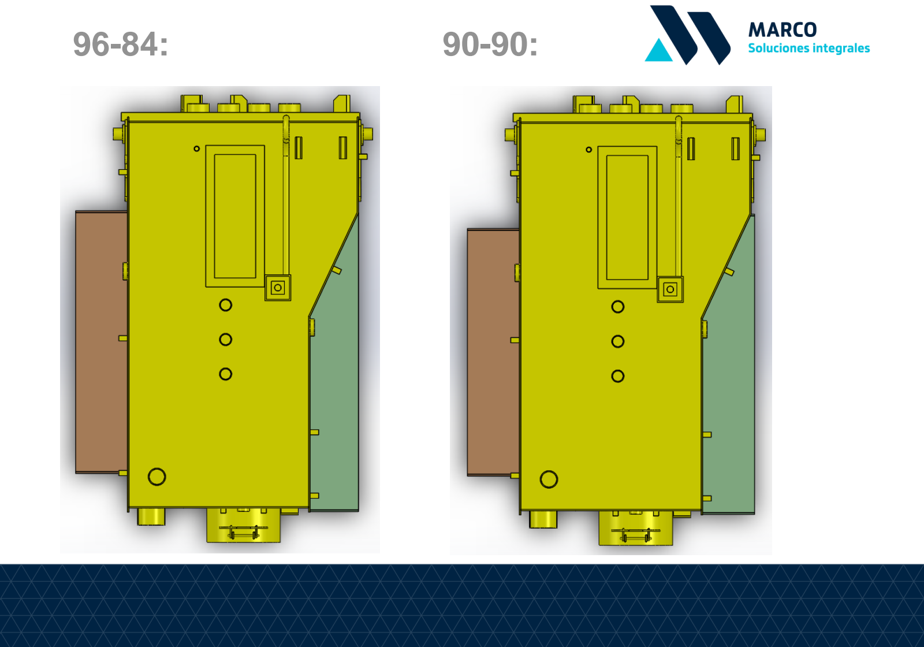
[picture p84: page 15]

96-84: | 90-90:

## Consumo de diesel:

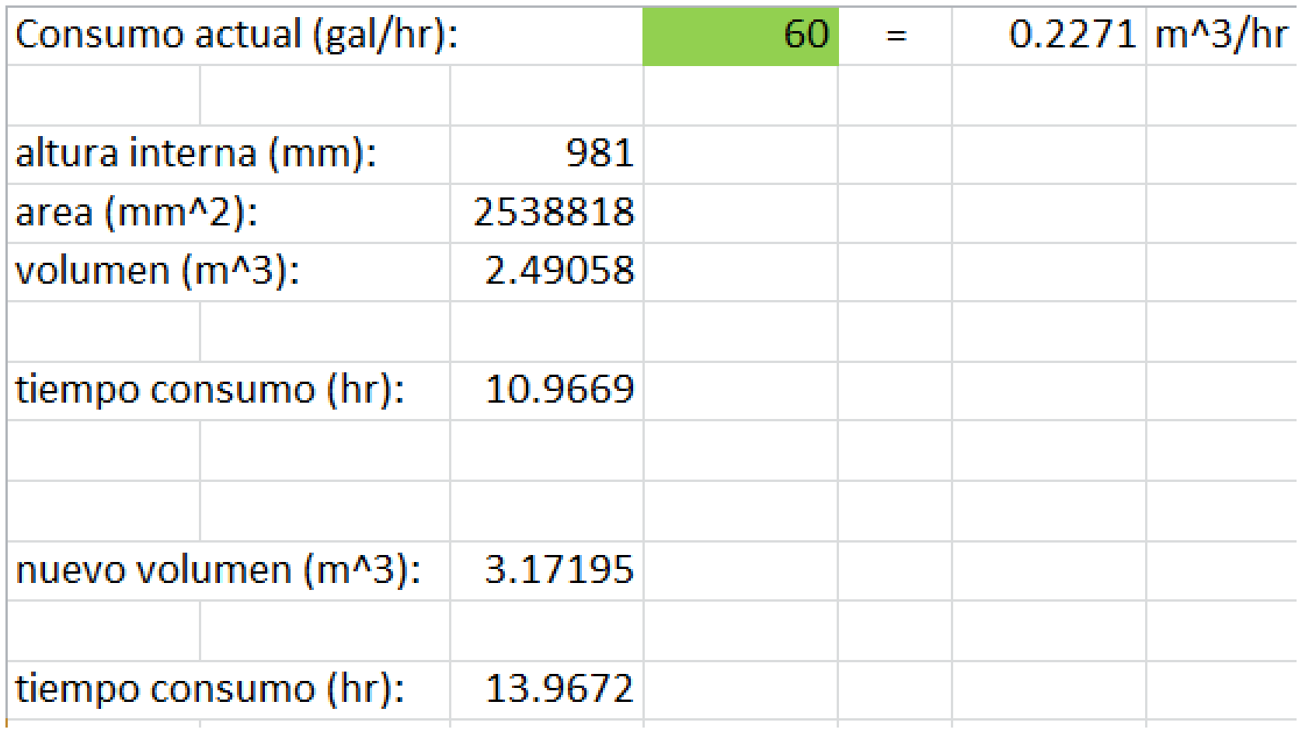
[picture p85: figure]

Resumen de pesos de tanque (Kg):

- Tanque original: | 2100
- 1400 gl Diesel: | 4452
- Total original: | 6552

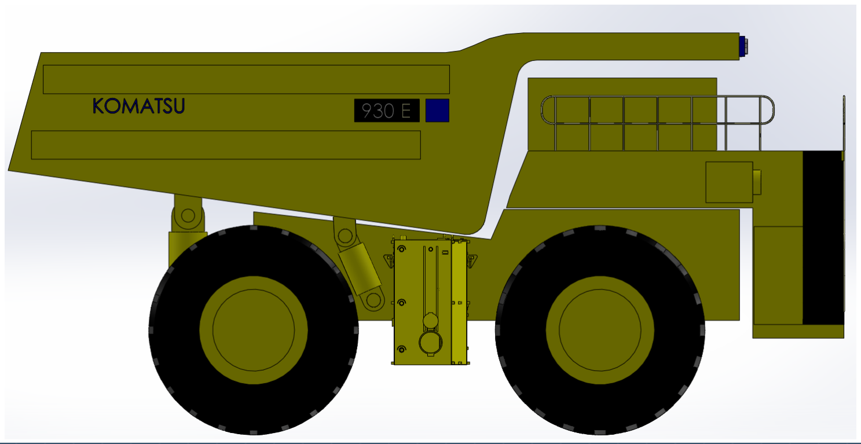
[picture p86: figure]

## Modelado:

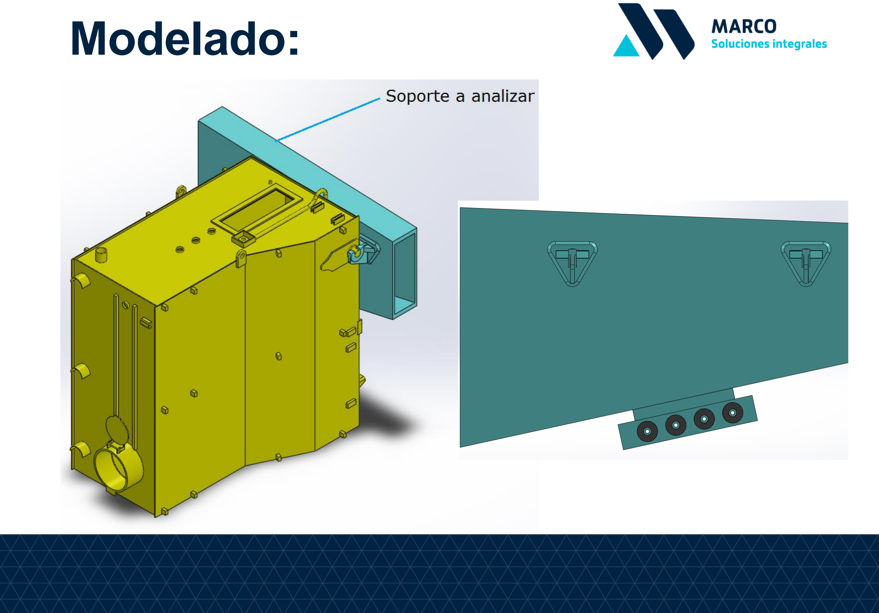
[picture p87: page 18]

## Esfuerzos (1):

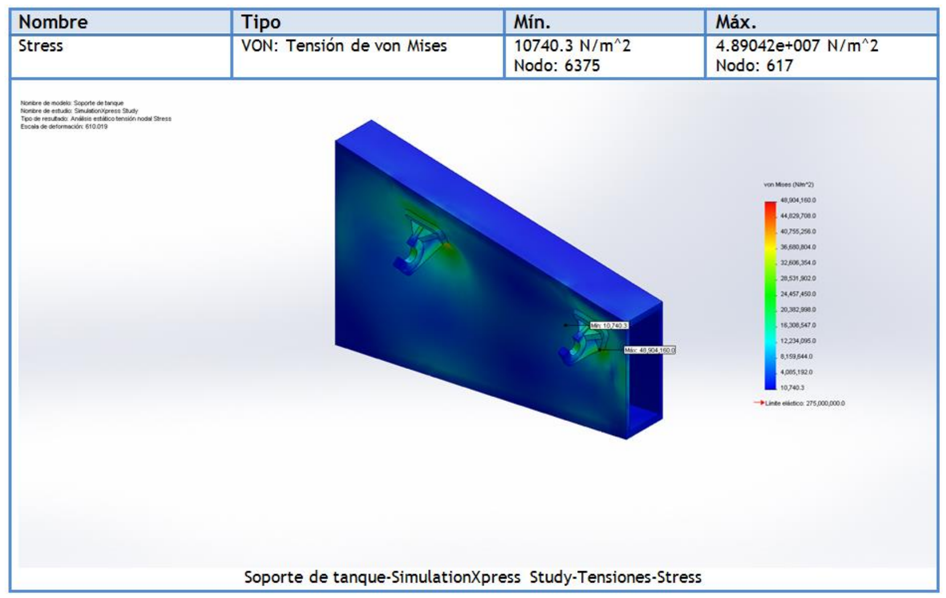
[picture p88: figure]

## Deformaciones (1):

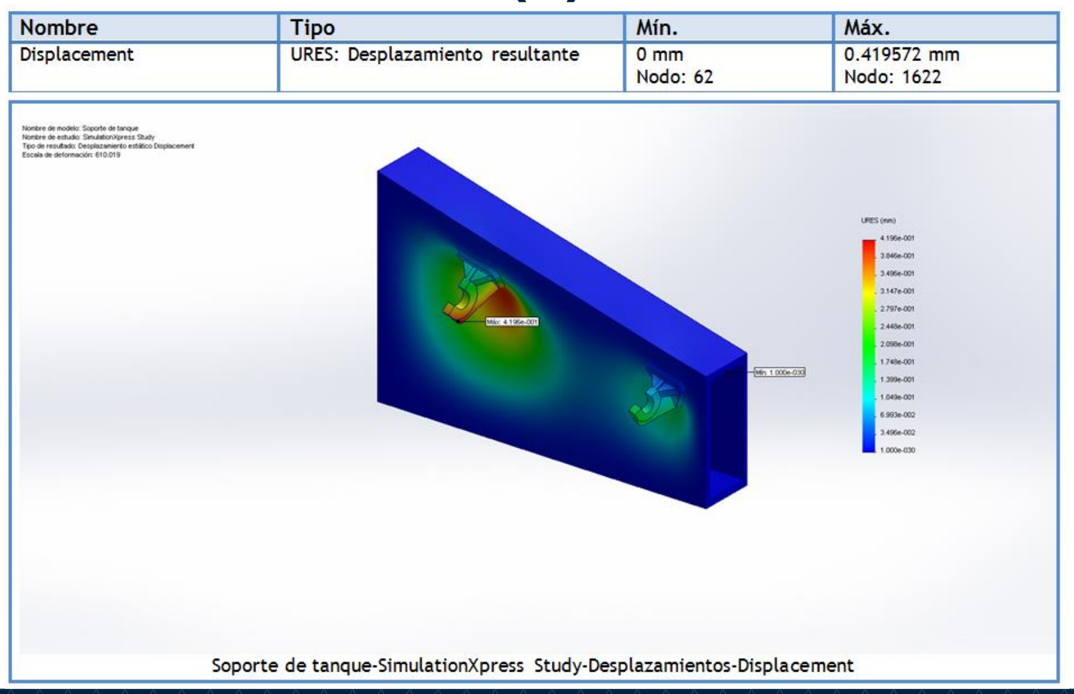
[picture p89: figure]

## Factor de seguridad (1):

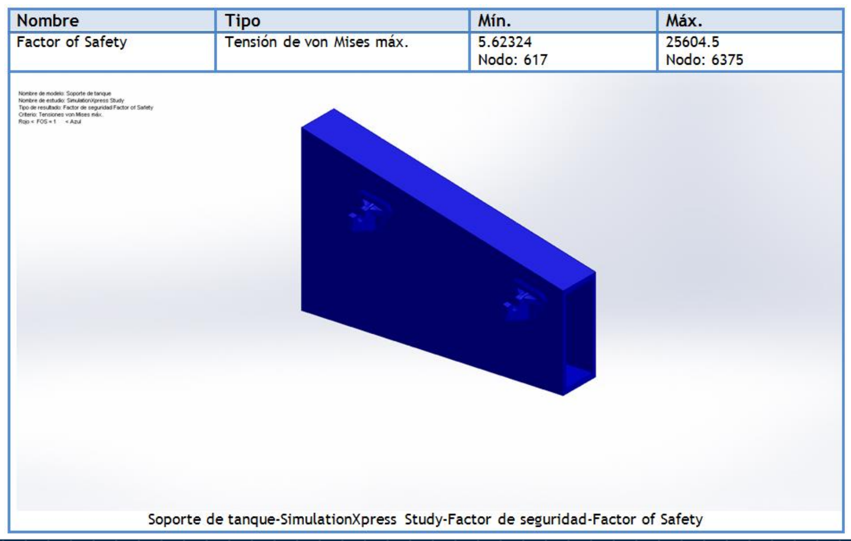
[picture p90: figure]

Resumen de pesos de tanque (Kg):

- Tanque original: 2100 | Piezas 1 y 2: | 390
- 1400 gl Diesel: | 4452 | 180 gl Diesel: | 573
- Total original: | 6552 | Total mod: | 7515

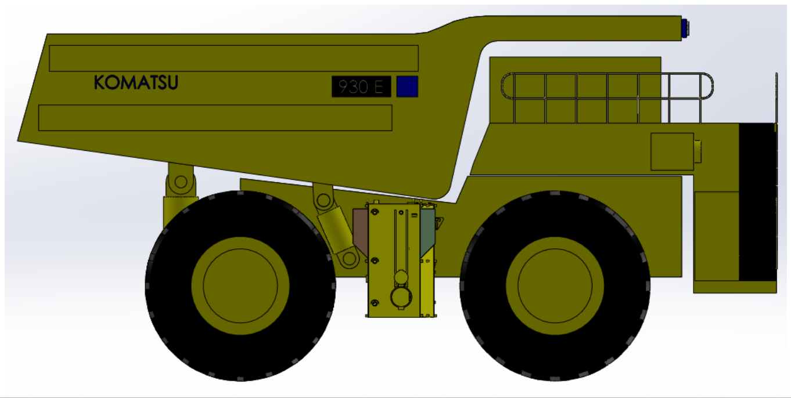
[picture p91: figure]

## Modelado:

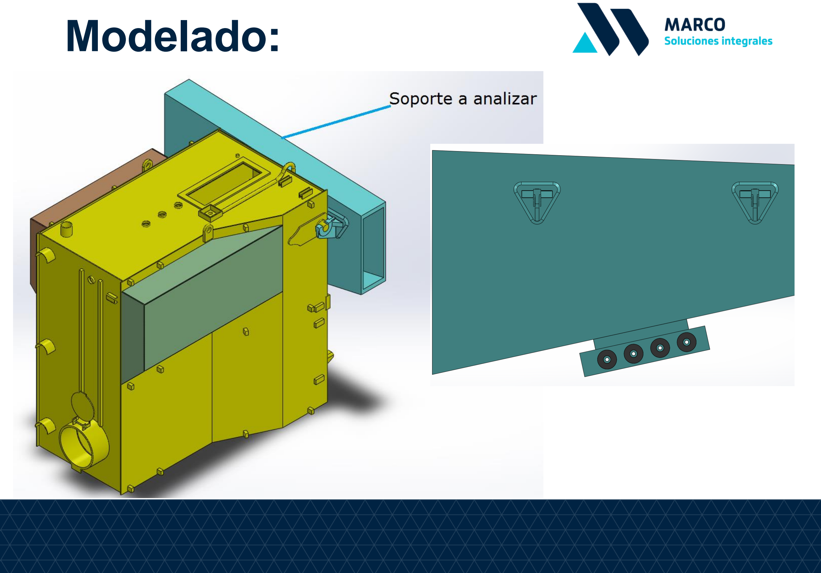
[picture p92: page 23]

## Esfuerzos (2):

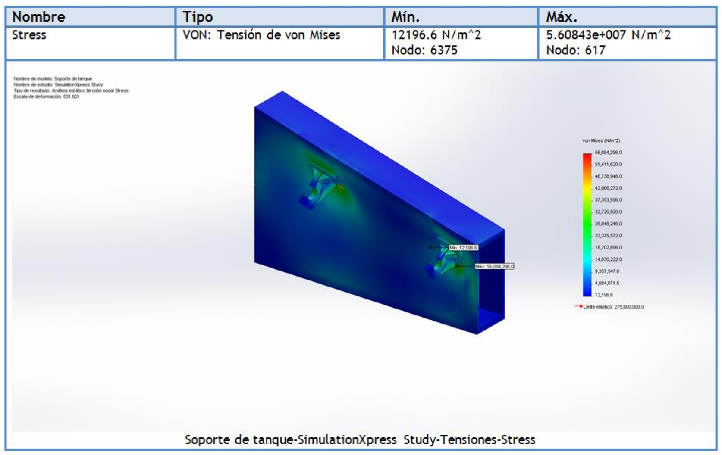
[picture p93: figure]

## Deformaciones (2):

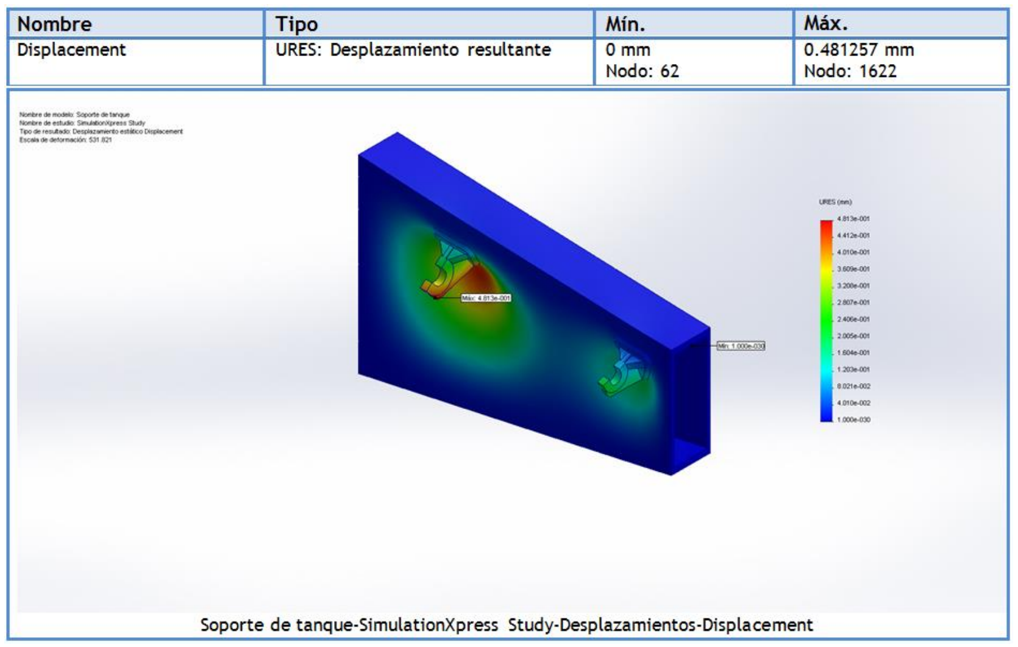
[picture p94: figure]

## Factor de seguridad (2):

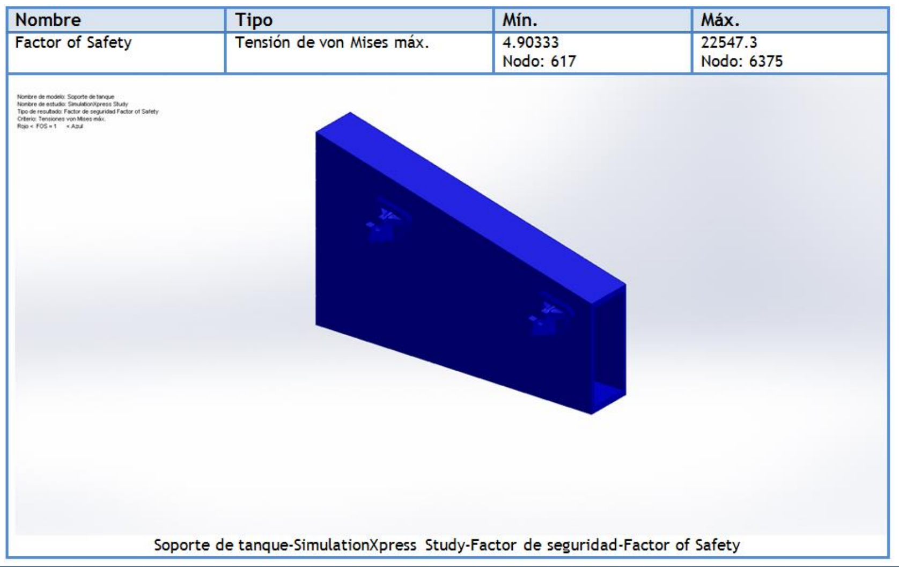
[picture p95: figure]

## Soporte modificado:

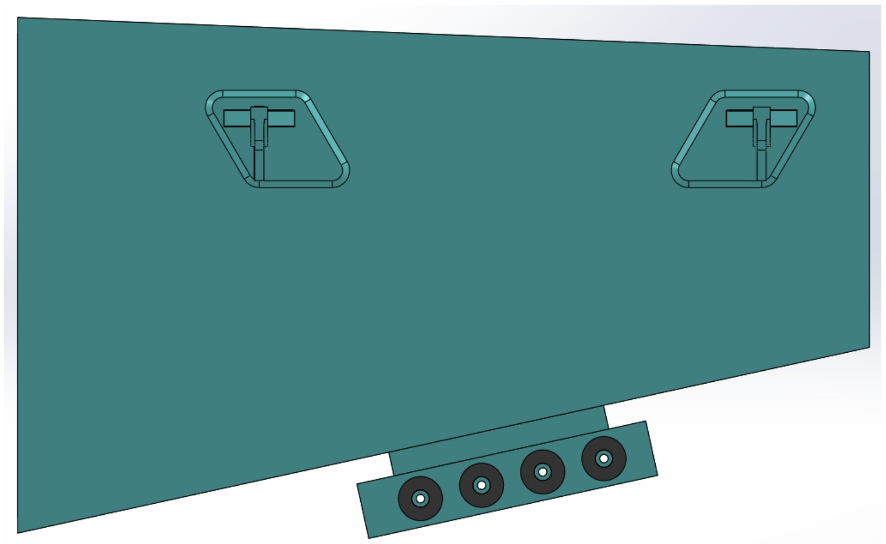
[picture p96: figure]

## Esfuerzos (3):

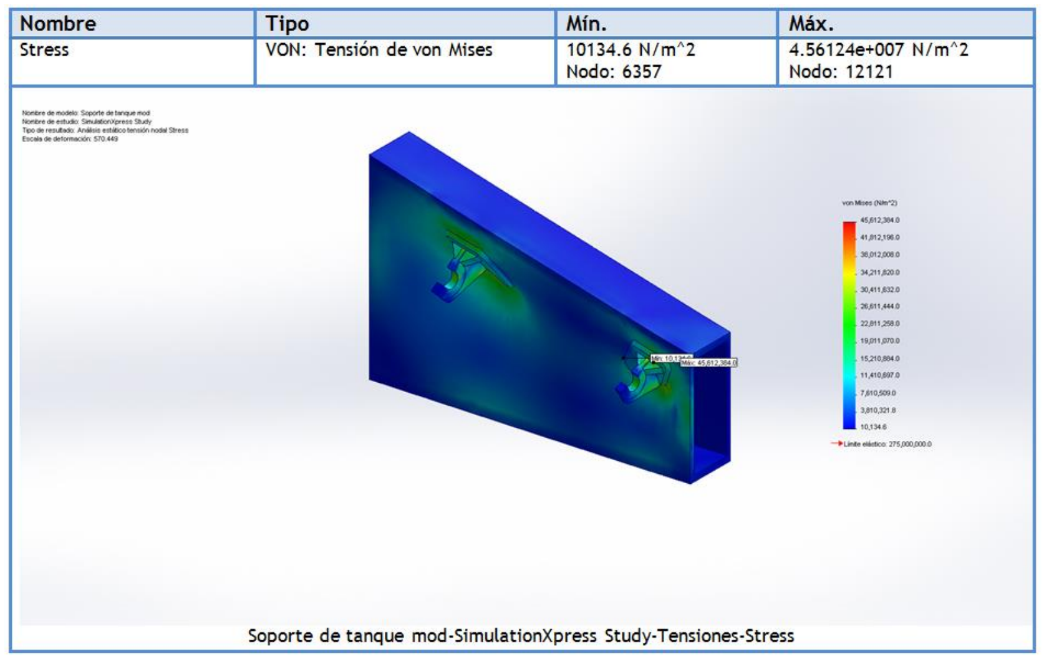
[picture p97: figure]

## Deformaciones (3):

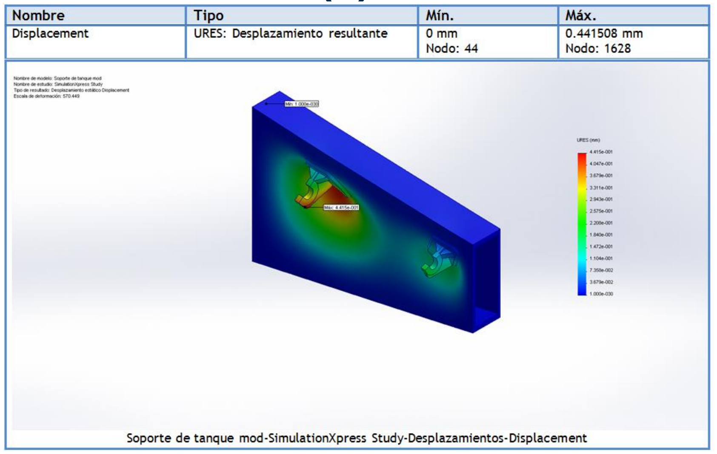
[picture p98: figure]

## Factor de seguridad (3):

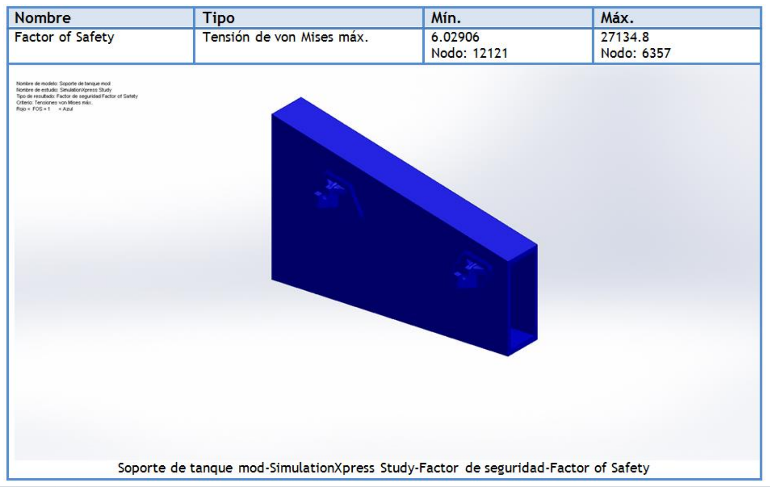
[picture p99: figure]

## Centros de gravedad:

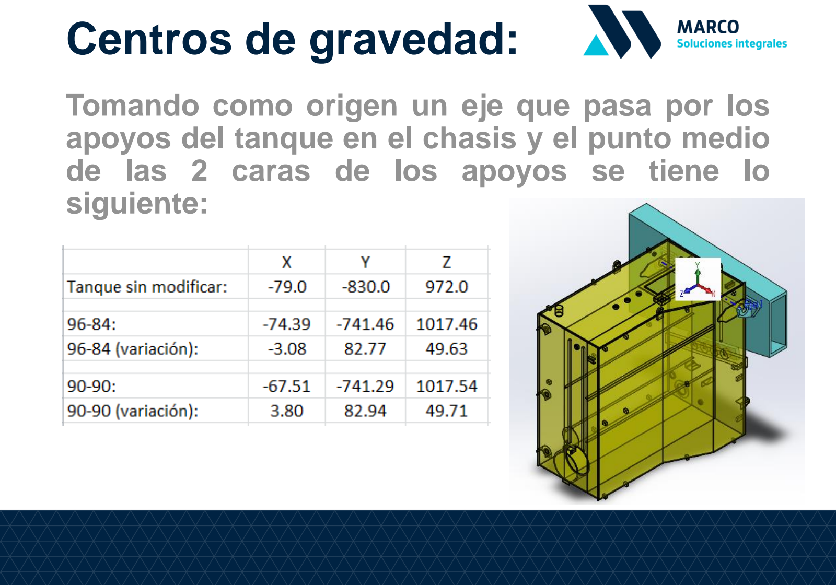
[picture p100: page 31]

Tomando como origen un eje que pasa por los apoyos del tanque en el chasis y el punto medio de las 2 caras de los apoyos se tiene lo siguiente:

## Conclusiones de pre-análisis:

- Tanque sin modificaciones:
Mínimo factor de seguridad: | 5.6
Máximo desplazamiento: | 0.42 mm
- Tanque modificado:
Mínimo factor de seguridad: | 4.9
Máximo desplazamiento: | 0.48 mm
- Con soporte modificado:
Mínimo factor de seguridad: | 6.0
Máximo desplazamiento: | 0.44 mm

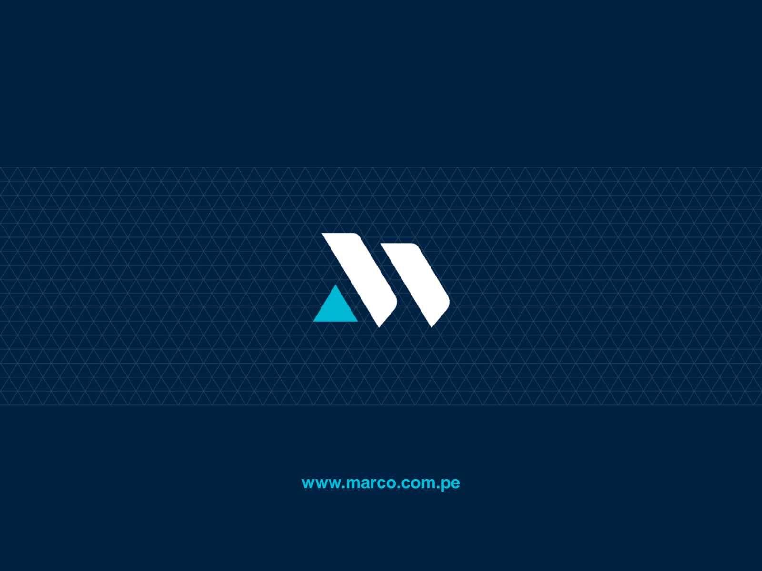
[picture p101: page 33]

www.marco.com.pe
