scedillo-wq/TanqueComb/MEDIDAS DE MANIPULADOR LAS BAMBAS.pdf

# MEDIDAS DE MANIPULADOR LAS BAMBAS

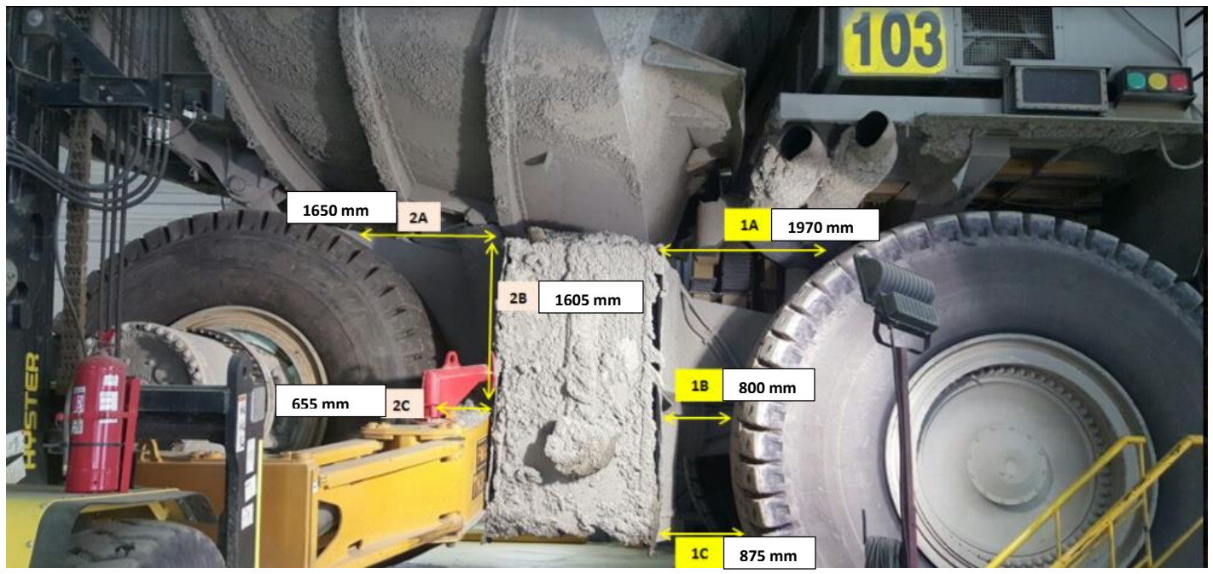
[picture p102: figure]
