scedillo-wq/TanqueComb/01.JPG

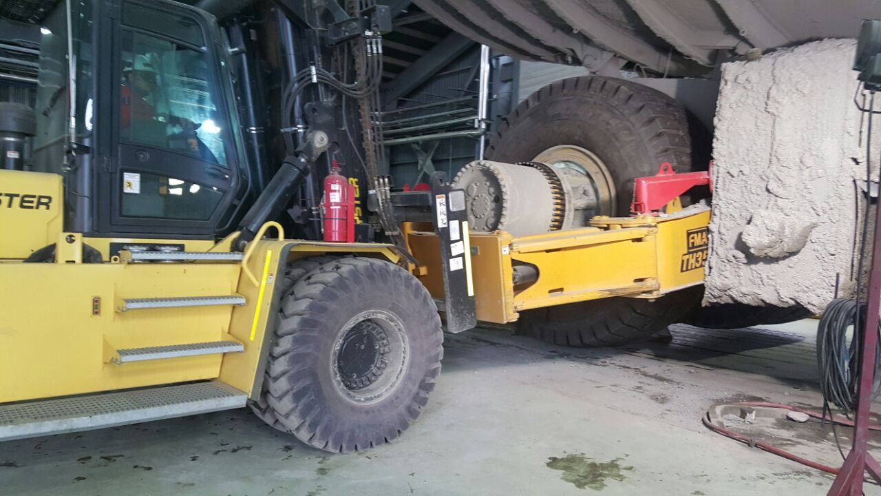
01.JPG
