scedillo-wq/TanqueComb/02.JPG

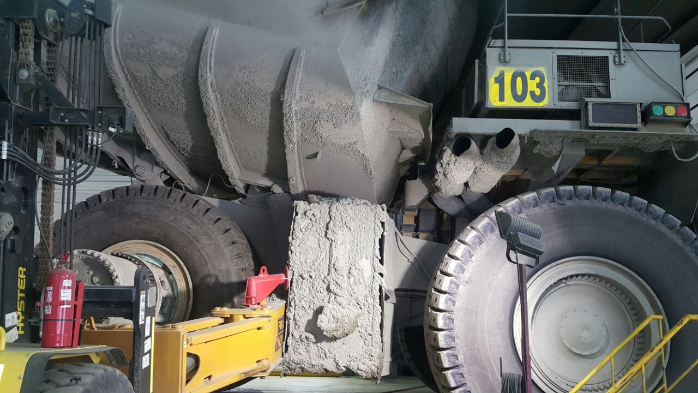
02.JPG
