scedillo-wq/TanqueComb/03.JPG

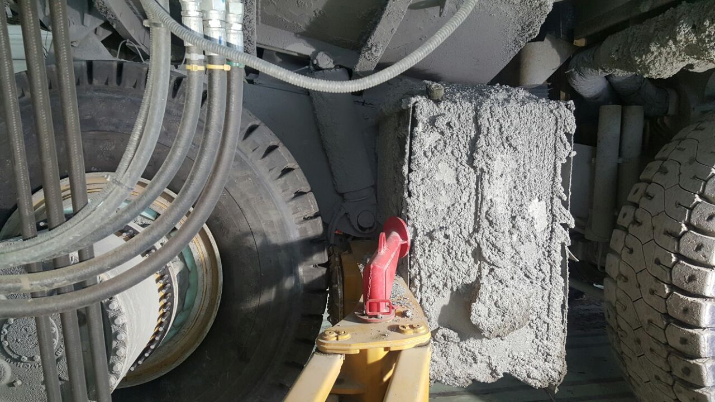
03.JPG
