scedillo-wq/TanqueComb/20260708_105802.jpg

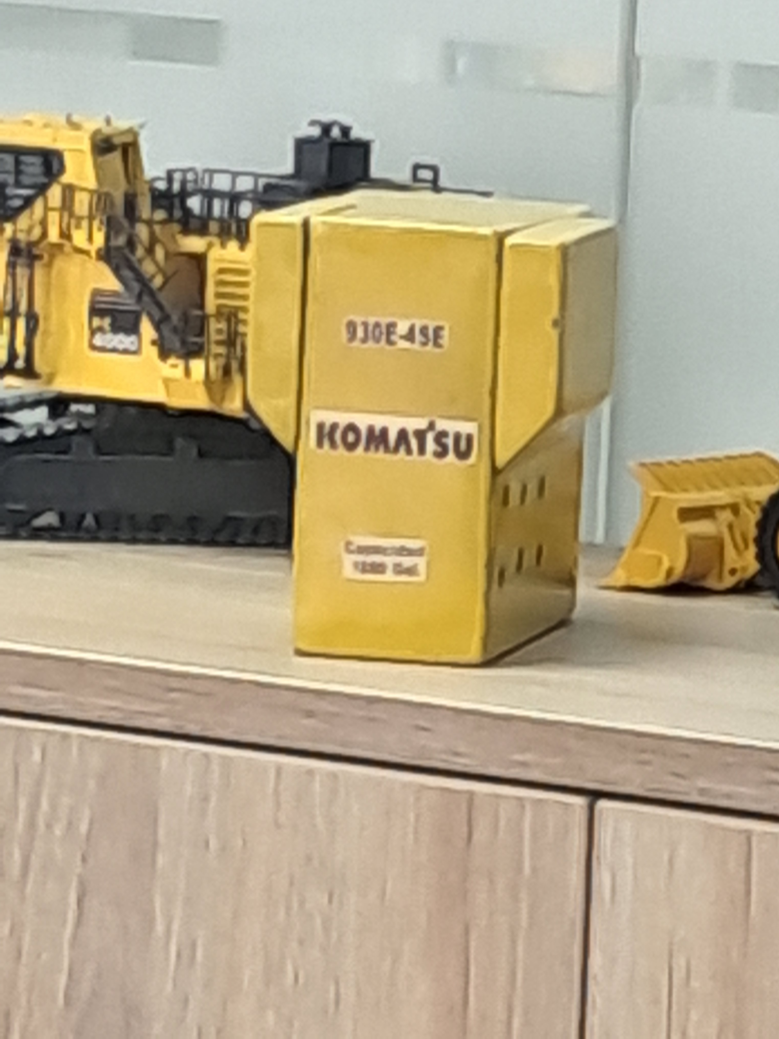
20260708_105802.jpg
