scedillo-wq/TanqueComb/IMG-20260709-WA0028.jpg

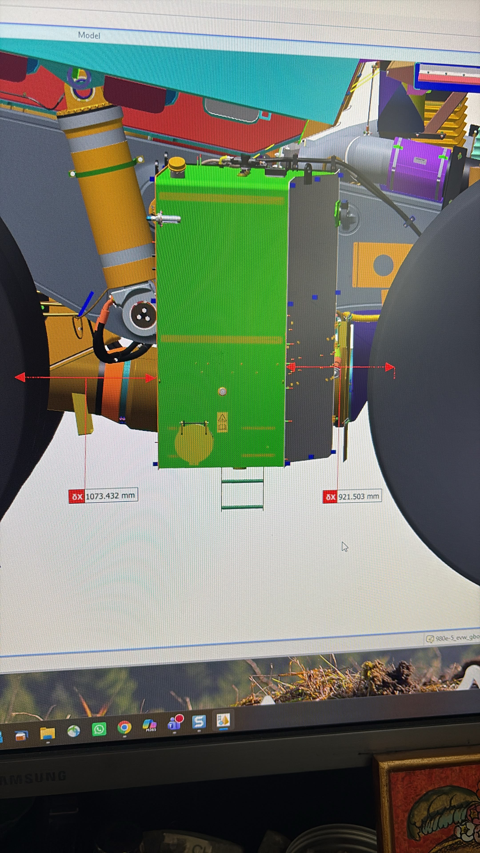
IMG-20260709-WA0028.jpg
