scedillo-wq/TanqueComb/IMG-20260720-WA0035.jpg

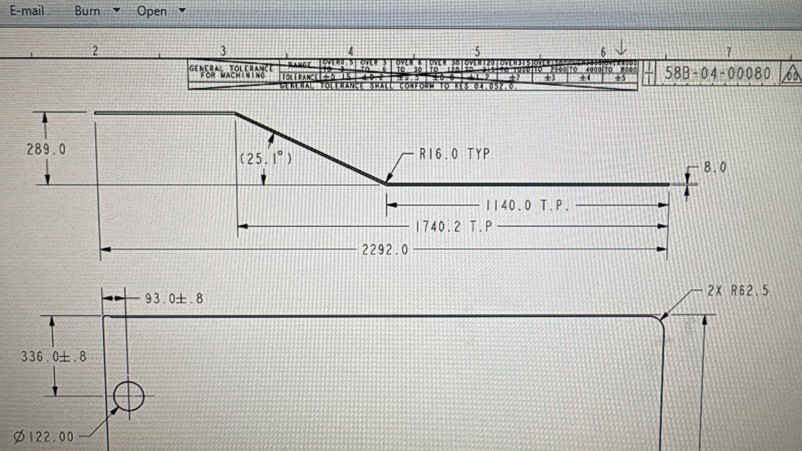
IMG-20260720-WA0035.jpg
