scedillo-wq/TanqueComb/IMG-20260904-WA0021.jpg

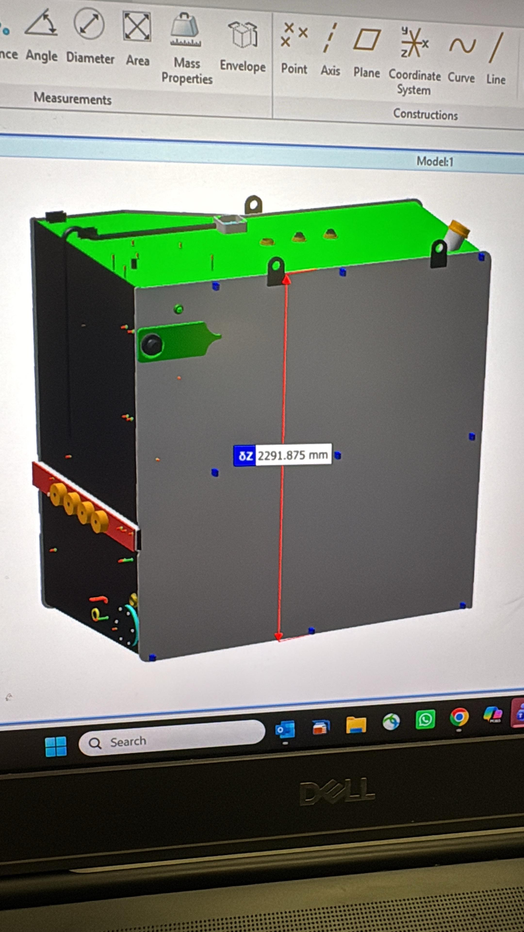
IMG-20260904-WA0021.jpg
