scedillo-wq/TanqueComb/IMG-20260904-WA0027.jpg

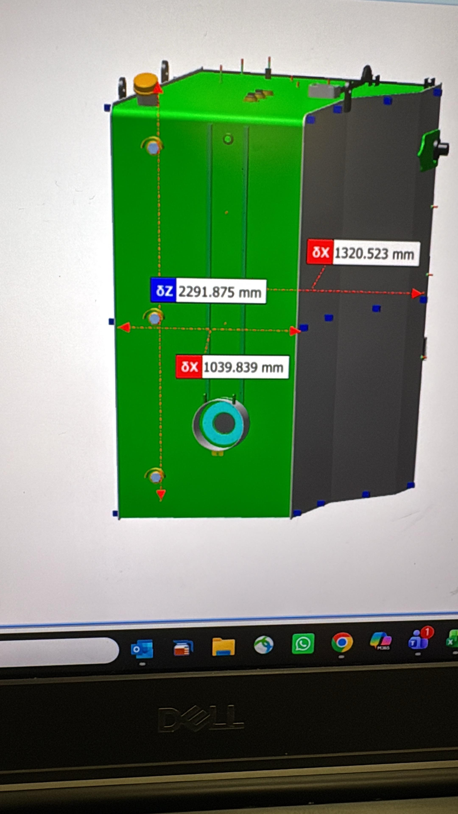
IMG-20260904-WA0027.jpg
