scedillo-wq/TanqueComb/IMG-20261015-WA0002.jpg

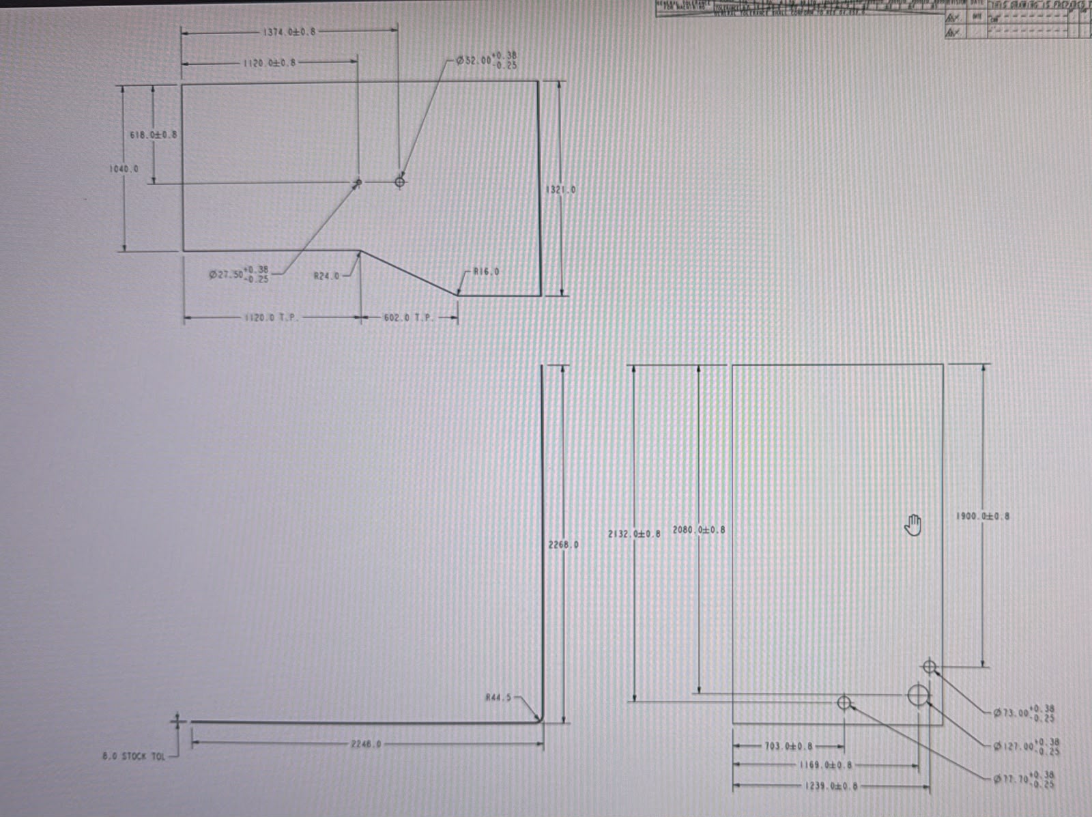
IMG-20261015-WA0002.jpg
