scedillo-wq/TanqueComb/IMG-20261015-WA0003.jpg

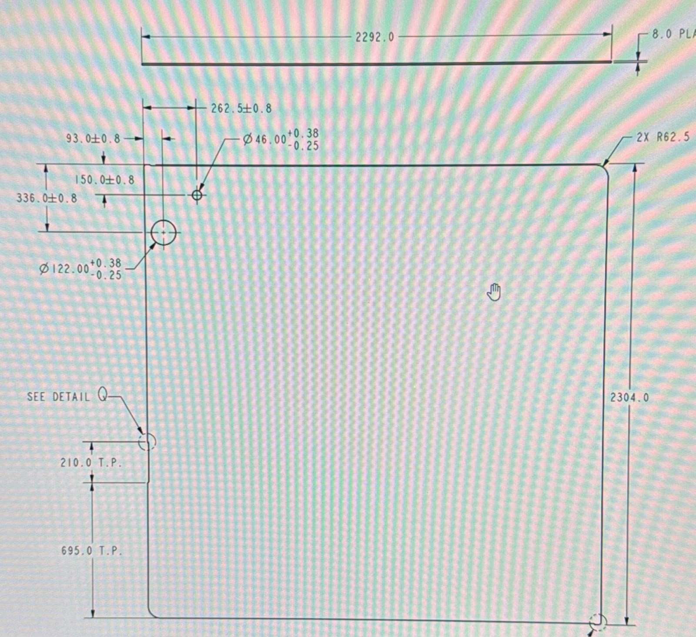
IMG-20261015-WA0003.jpg
