scedillo-wq/TanqueComb/Screenshot_20260720_162426_WhatsApp.jpg

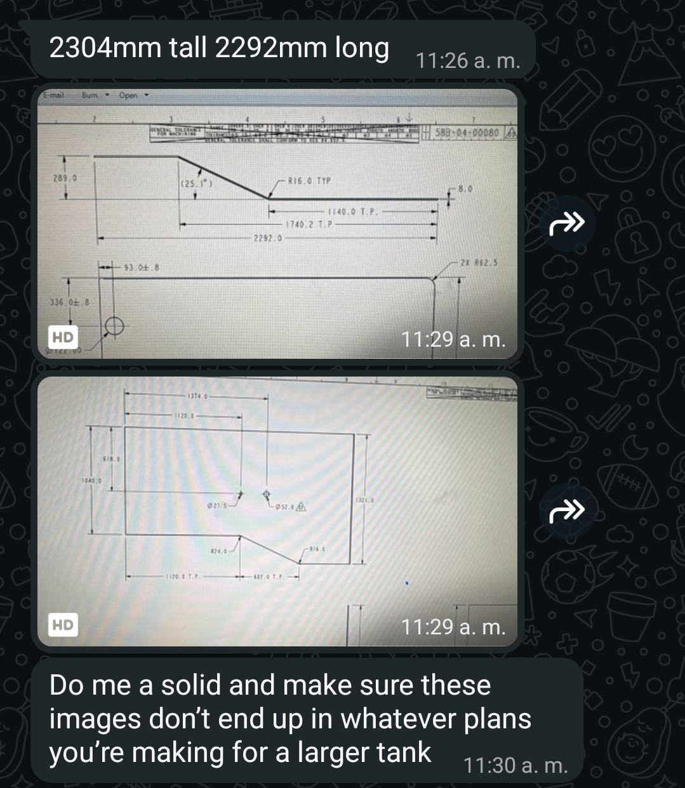
Screenshot_20260720_162426_WhatsApp.jpg
