scedillo-wq/TanqueComb/WhatsApp Image 2026-10-15 at 10.12.22 AM.jpeg

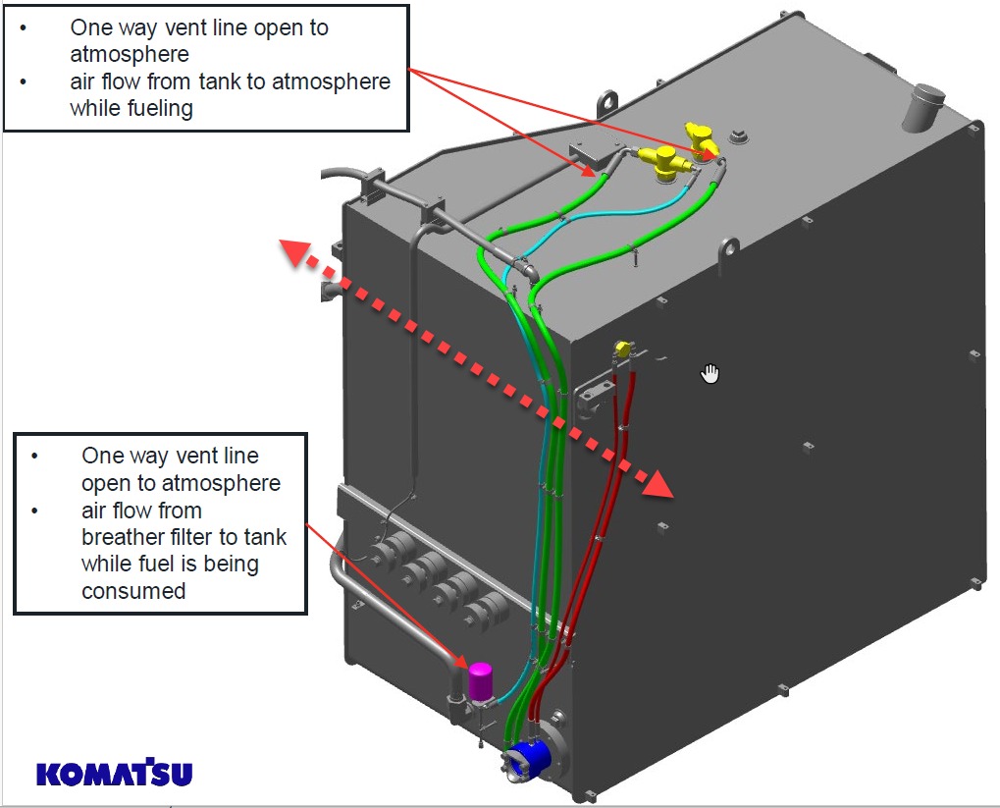
WhatsApp Image 2026-10-15 at 10.12.22 AM.jpeg
