scedillo-wq/TanqueComb/1400 Gal Tank Vol Study Customer.xlsx

Model | D1 (m): Fuel level mounting surface to inside bottom of fuel tank | D2 (m) Height from inside bottom surface of fuel tank to pickup tube | D3 (m): Height from fuel level mounting surface to first sensor position above 208 Ohm. IM looks for anything above 208 Ohms to trigger low level alarm. | D4 (m): Height from inside bottom surface of fuel tank to empty sensor positon | D5 (m): Height from inside bottom surface of fuel tank to jet sensor port. | D6 (m): Height from inside bottom surface of fuel tank to inside upper surface of fuel tank. | A1 (m^2): Surface area of bottom tank surface | Overall tank Volume (gal)* | Volume below pickup port (gal)* | Overall Volume to Jet Sensor Height (gal)* | Total Useable Volume (gal)* | Total Volume @ empty sensor position (gal)* | Total useable volume at the empty position sensor (gal)* | Total Useable Volume to Low Level Warning Sensor Locations (gal)* | Low level useable volume percentage | Total Volume to Low Level Warning Sensor Location (gal)* | Low level total volume percentage
930E-5SE / 980E-5 58B-04-00174 Tank Str | 2.2722 | 0.026 | 0.4352 | 0.2112 | 2.122 | 2.24 | 2.55745 | 1513.359539 | 17.56578037 | 1433.637921 | 1416.07214 | 142.6881851 | 125.1224048 | 276.4583587 | 19.5% | 294.024139 | 20.5%
*Volume calculation ignores internal baffling volume. Estimated to be approximately 19 gal total |  |  |  |  |  |  | 2557450
