scedillo-wq/TanqueComb/Tanque_980E5_Original.step

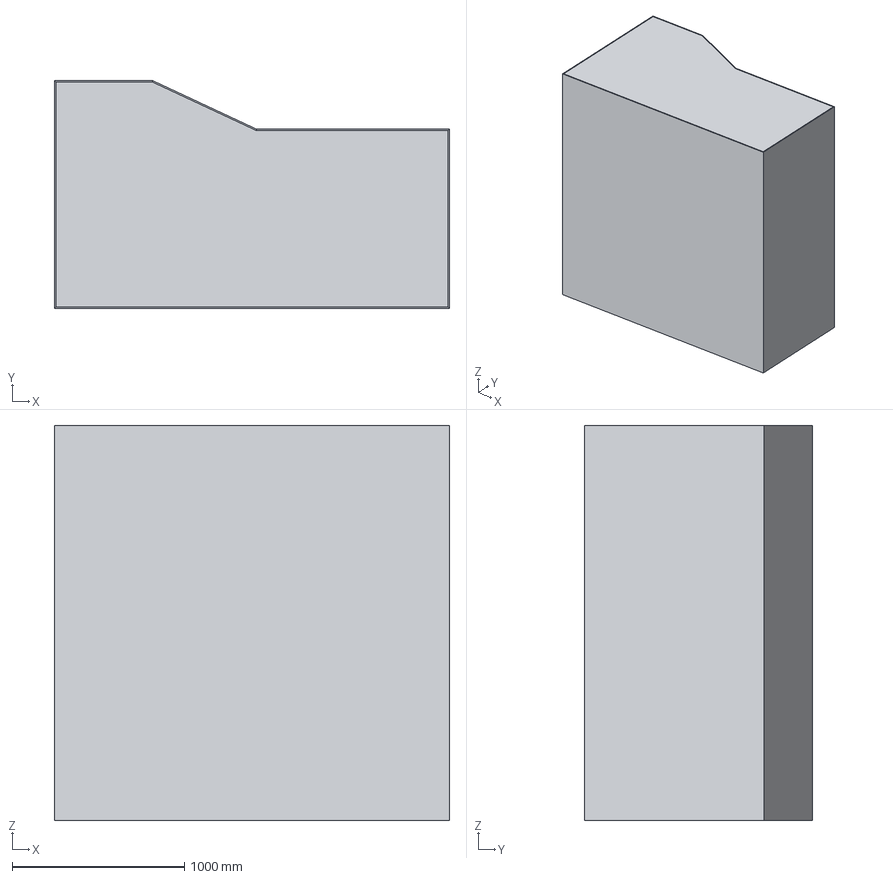
[picture p115: CAD file, 2026-10-15]
Tanque_980E5_Original.step
2292.0 x 1321.0 x 2292.0 mm
PARED_POSTERIOR
PARED_EXTERIOR
PARED_FRONTAL_ANGOSTA
PARED_CHAFLAN
PARED_FRONTAL_ANCHA
PARED_INTERIOR
TECHO
FONDO
MAMPARO_LONG
MAMPARO_T1_POST
MAMPARO_T1_FRONT
MAMPARO_T2_POST
MAMPARO_T2_FRONT
