scedillo-wq/TanqueComb/Tanque_980E5_P2.step

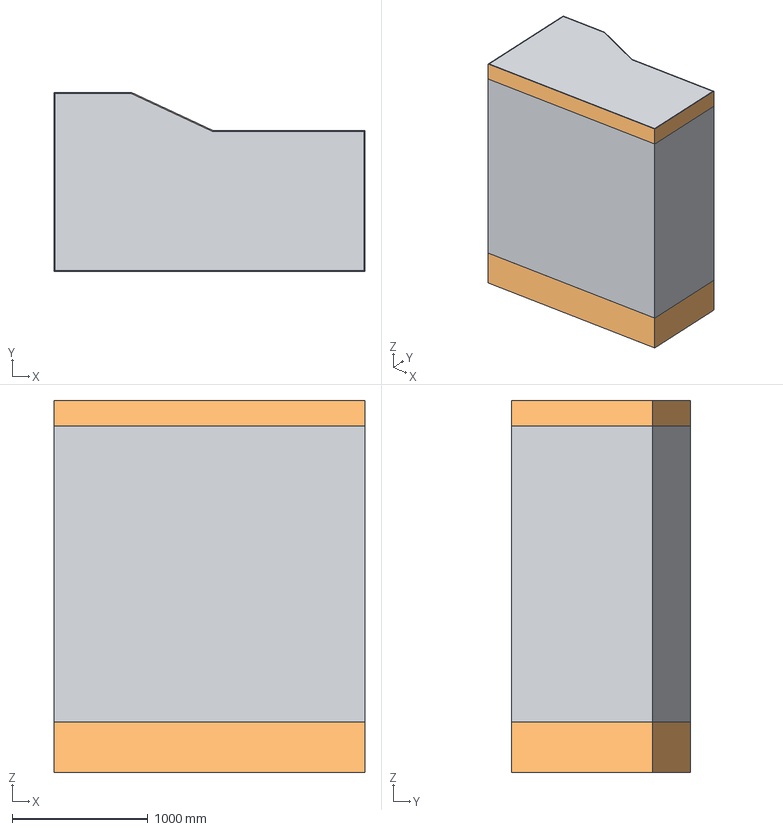
[picture p116: CAD file, 2026-10-15]
Tanque_980E5_P2.step
2292.0 x 1321.0 x 2742.0 mm
PARED_POSTERIOR
PARED_EXTERIOR
PARED_FRONTAL_ANGOSTA
PARED_CHAFLAN
PARED_FRONTAL_ANCHA
PARED_INTERIOR
BANDA_INF_POSTERIOR
BANDA_INF_EXTERIOR
BANDA_INF_FRONTAL_ANGOSTA
BANDA_INF_CHAFLAN
BANDA_INF_FRONTAL_ANCHA
BANDA_INF_INTERIOR
BANDA_SUP_POSTERIOR
BANDA_SUP_EXTERIOR
BANDA_SUP_FRONTAL_ANGOSTA
BANDA_SUP_CHAFLAN
BANDA_SUP_FRONTAL_ANCHA
BANDA_SUP_INTERIOR
TECHO_REUBICADO
FONDO_NUEVO
MAMPARO_LONG
MAMPARO_T1_POST
MAMPARO_T1_FRONT
MAMPARO_T2_POST
MAMPARO_T2_FRONT
MAMPARO_LONG_EXT_INF
MAMPARO_T1_POST_EXT_INF
MAMPARO_T1_FRONT_EXT_INF
MAMPARO_T2_POST_EXT_INF
MAMPARO_T2_FRONT_EXT_INF
MAMPARO_LONG_EXT_SUP
MAMPARO_T1_POST_EXT_SUP
MAMPARO_T1_FRONT_EXT_SUP
MAMPARO_T2_POST_EXT_SUP
MAMPARO_T2_FRONT_EXT_SUP
