scedillo-wq/TanqueComb/Tanque_980E5_P1.step

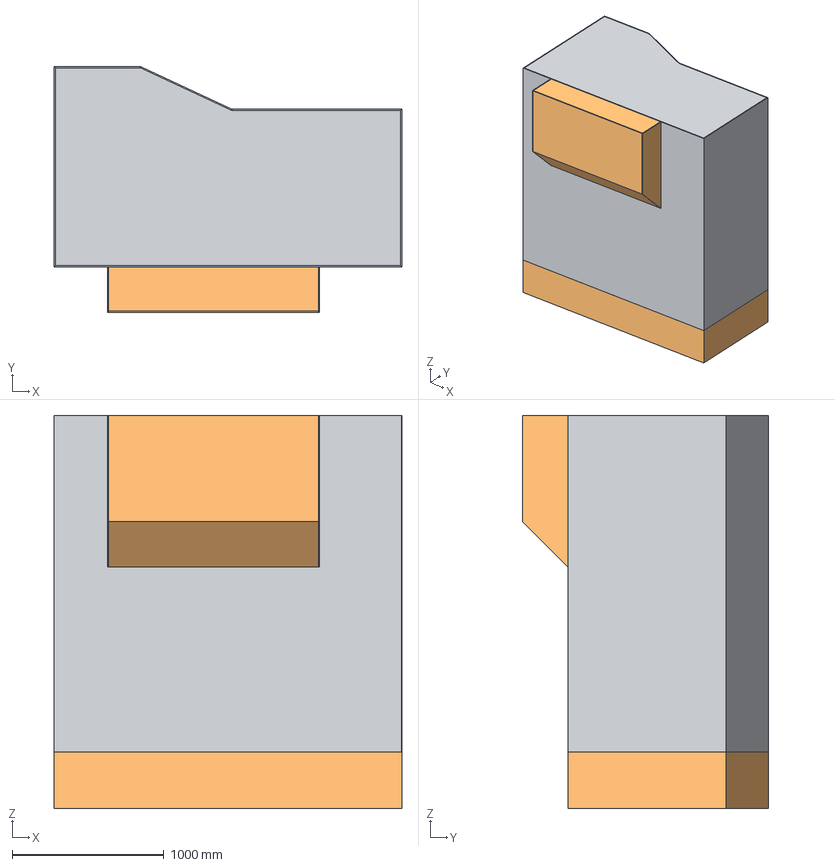
[picture p117: CAD file, 2026-10-15]
Tanque_980E5_P1.step
2292.0 x 1621.0 x 2592.0 mm
PARED_POSTERIOR
PARED_EXTERIOR
PARED_FRONTAL_ANGOSTA
PARED_CHAFLAN
PARED_FRONTAL_ANCHA
PARED_INTERIOR
BANDA_INF_POSTERIOR
BANDA_INF_EXTERIOR
BANDA_INF_FRONTAL_ANGOSTA
BANDA_INF_CHAFLAN
BANDA_INF_FRONTAL_ANCHA
BANDA_INF_INTERIOR
TECHO
FONDO_NUEVO
MAMPARO_LONG
MAMPARO_T1_POST
MAMPARO_T1_FRONT
MAMPARO_T2_POST
MAMPARO_T2_FRONT
MAMPARO_LONG_EXT_INF
MAMPARO_T1_POST_EXT_INF
MAMPARO_T1_FRONT_EXT_INF
MAMPARO_T2_POST_EXT_INF
MAMPARO_T2_FRONT_EXT_INF
CAJA_TAPA
CAJA_CARA
CAJA_CHAFLAN
CAJA_EXTREMO_1
CAJA_EXTREMO_2
CAJA_MAMPARO
