scedillo-wq/TanqueComb/Plano 01_TANQUE COMB. GENERAL V00.PDF

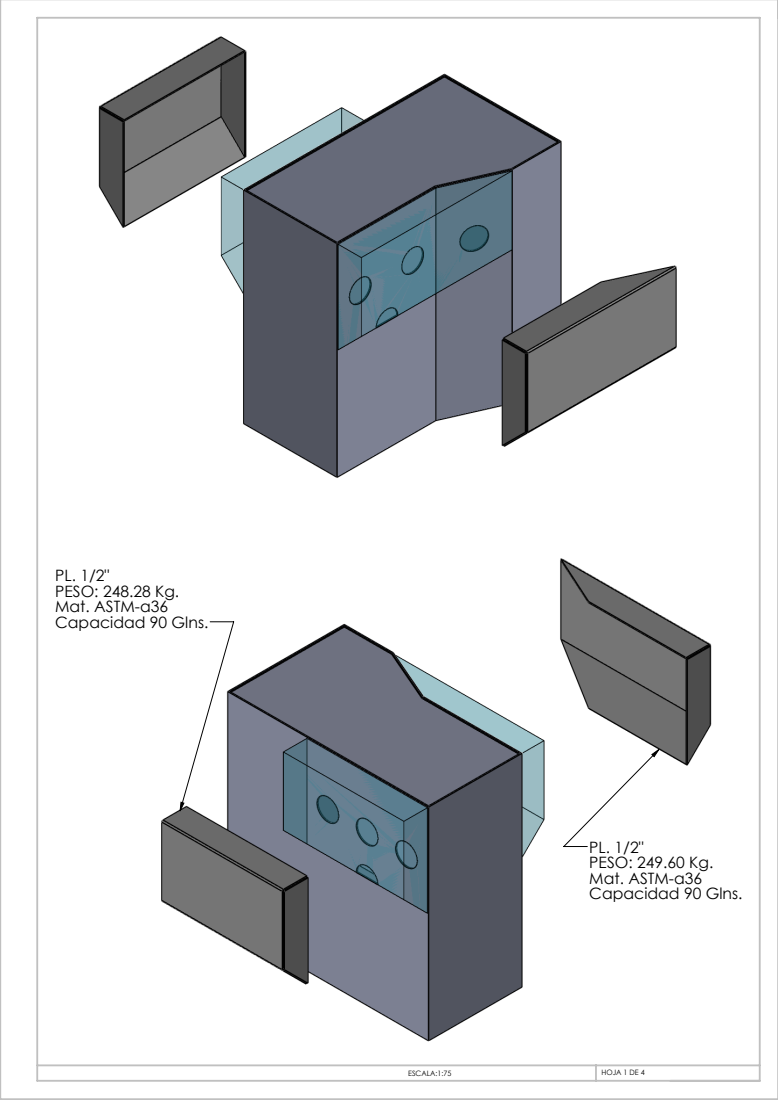
[picture p118: page 1]
PL. 1/2" PESO: 248.28 Kg. Mat. ASTM-a36 Capacidad 90 Glns.; PL. 1/2" PESO: 249.60 Kg. Mat. ASTM-a36 Capacidad 90 Glns.; ESCALA:1:75; HOJA 1 DE 4

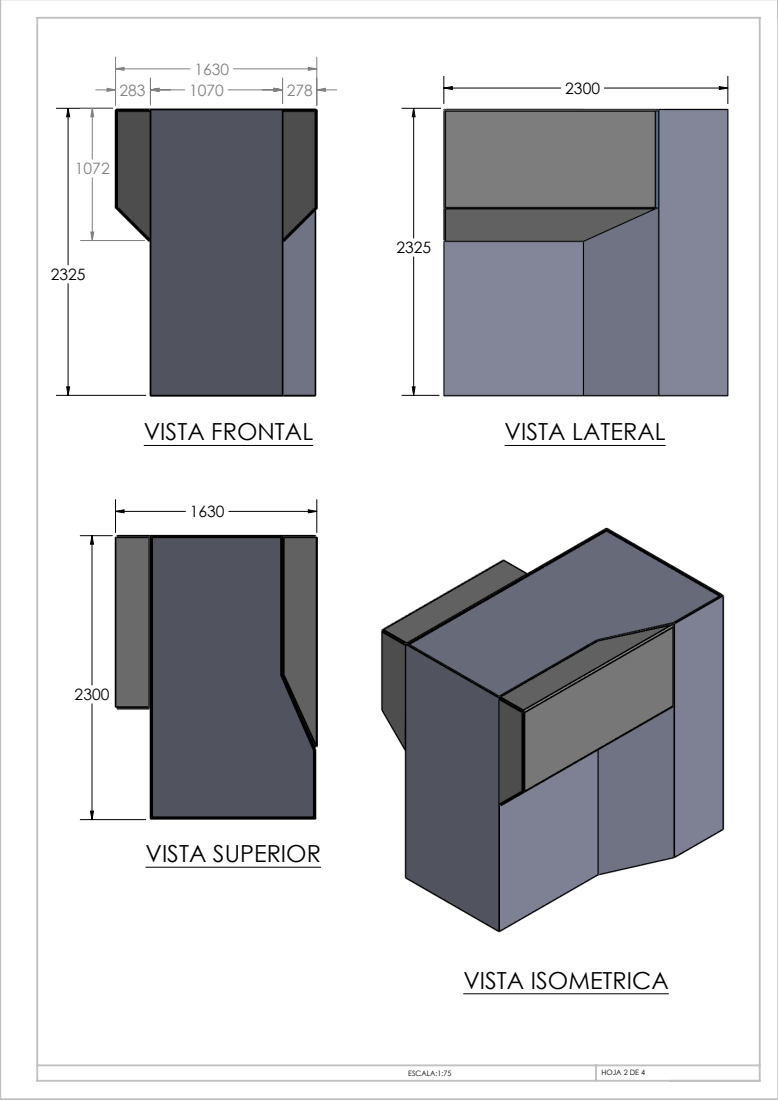
[picture p119: page 2]
VISTA ISOMETRICA; VISTA SUPERIOR; VISTA FRONTAL; VISTA LATERAL

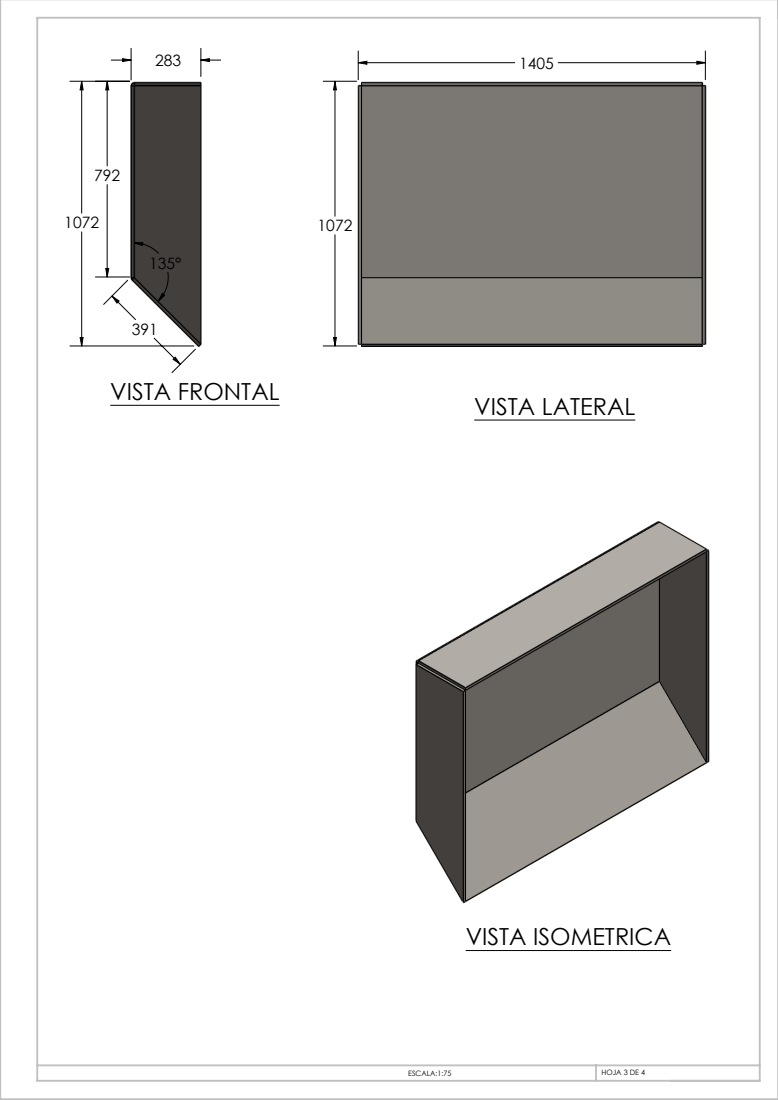
[picture p120: page 3]
VISTA ISOMETRICA; VISTA FRONTAL; VISTA LATERAL

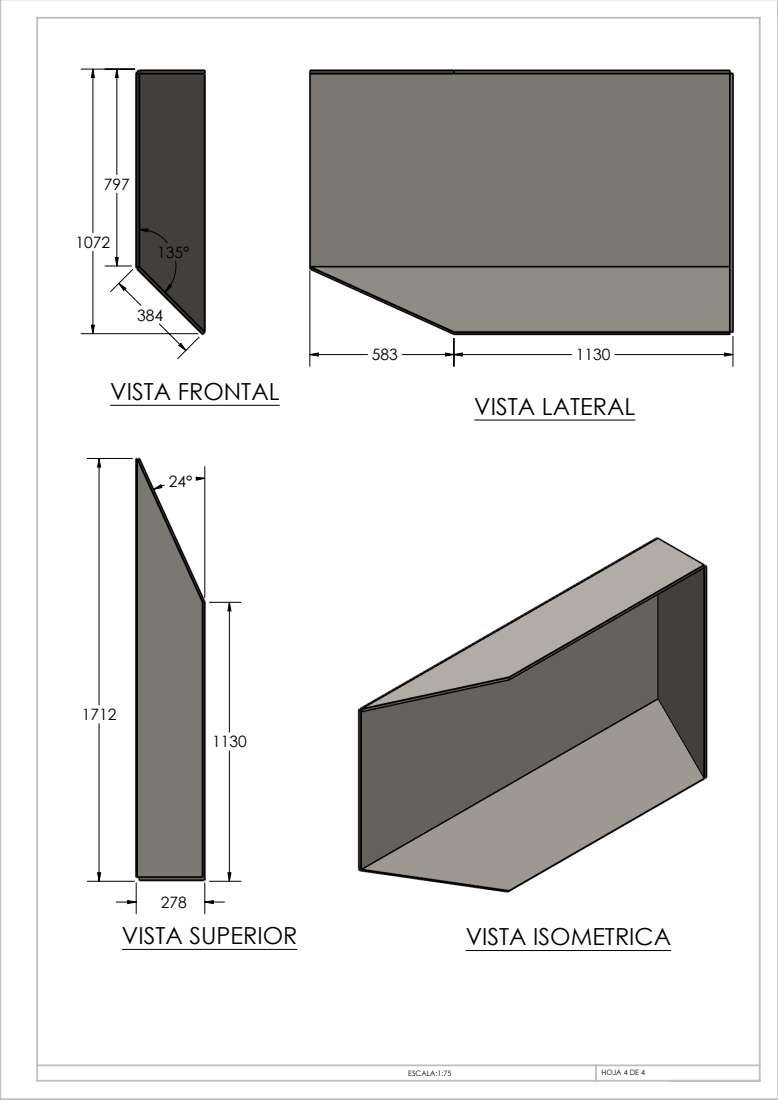
[picture p121: page 4]
VISTA ISOMETRICA; VISTA FRONTAL; VISTA LATERAL; VISTA SUPERIOR
