scedillo-wq/TanqueComb/Plano 02_ TANQUE DE COMBUSTIBLE V001.PDF

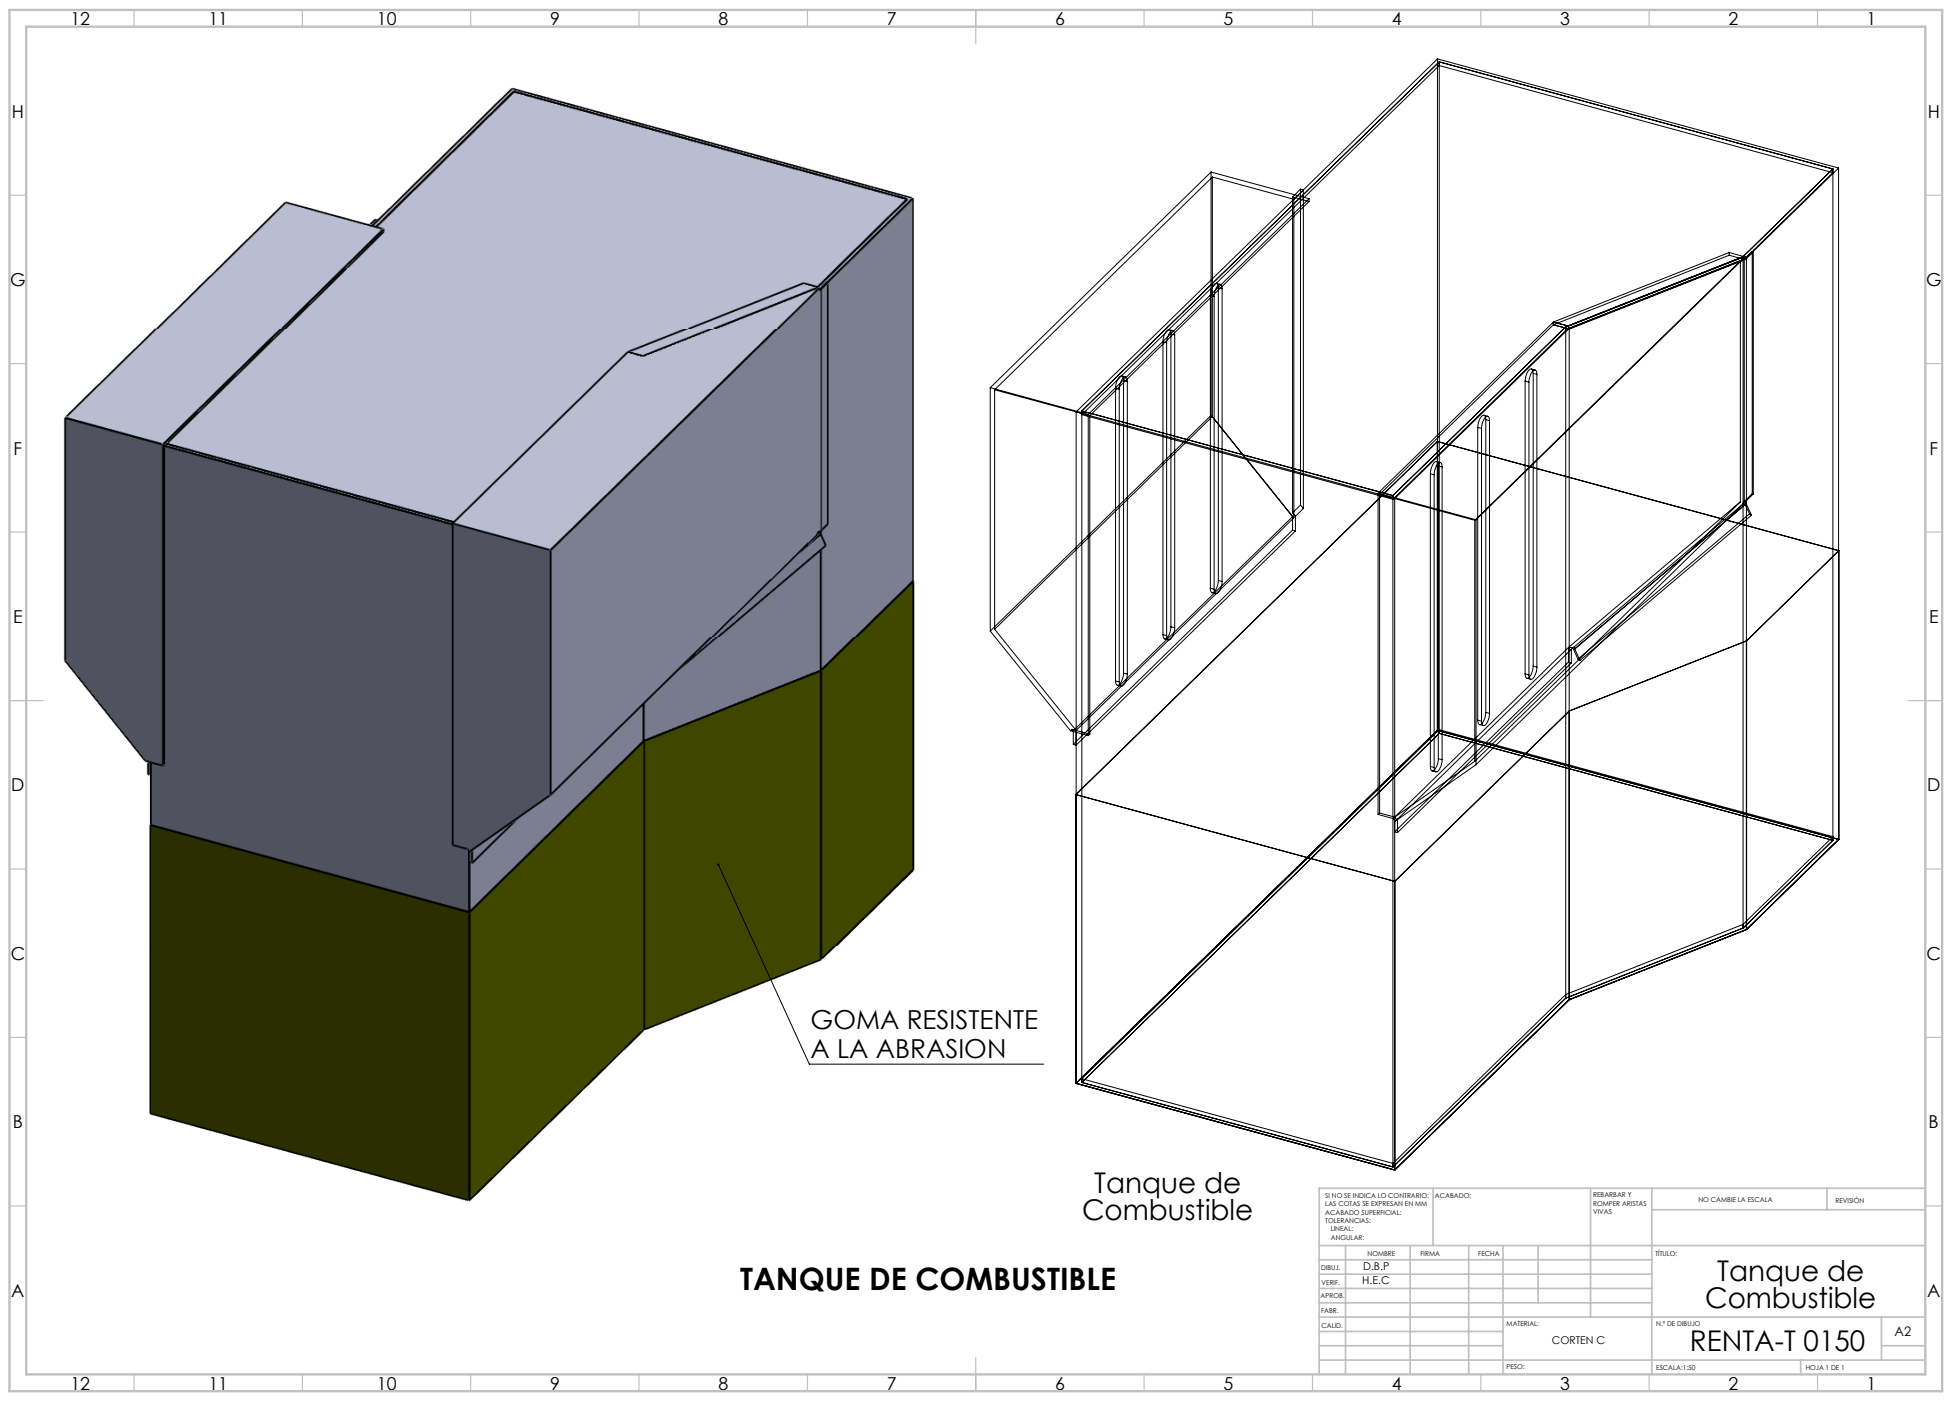
[picture p122: page 1]
GOMA RESISTENTE A LA ABRASION; ESCALA:1:50; HOJA 1 DE 1; Tanque de

SI NO SE INDICA LO CONTRARIO: LAS COTAS SE EXPRESAN EN MM ACABADO SUPERFICIAL: TOLERANCIAS: LINEAL: ANGULAR: | ACABADO: | REBARBAR Y ROMPER ARISTAS VIVAS | NO CAMBIE LA ESCALA | REVISIÓN

NOMBRE | FIRMA | FECHA | | | | TÍTULO: Tanque de Combustible

TANQUE DE COMBUSTIBLE

DIBUJ. | D.B.P
VERIF. | H.E.C

APROB.
FABR.
CALID. | | | | MATERIAL: CORTEN C | N.º DE DIBUJO RENTA-T 0150 | A2

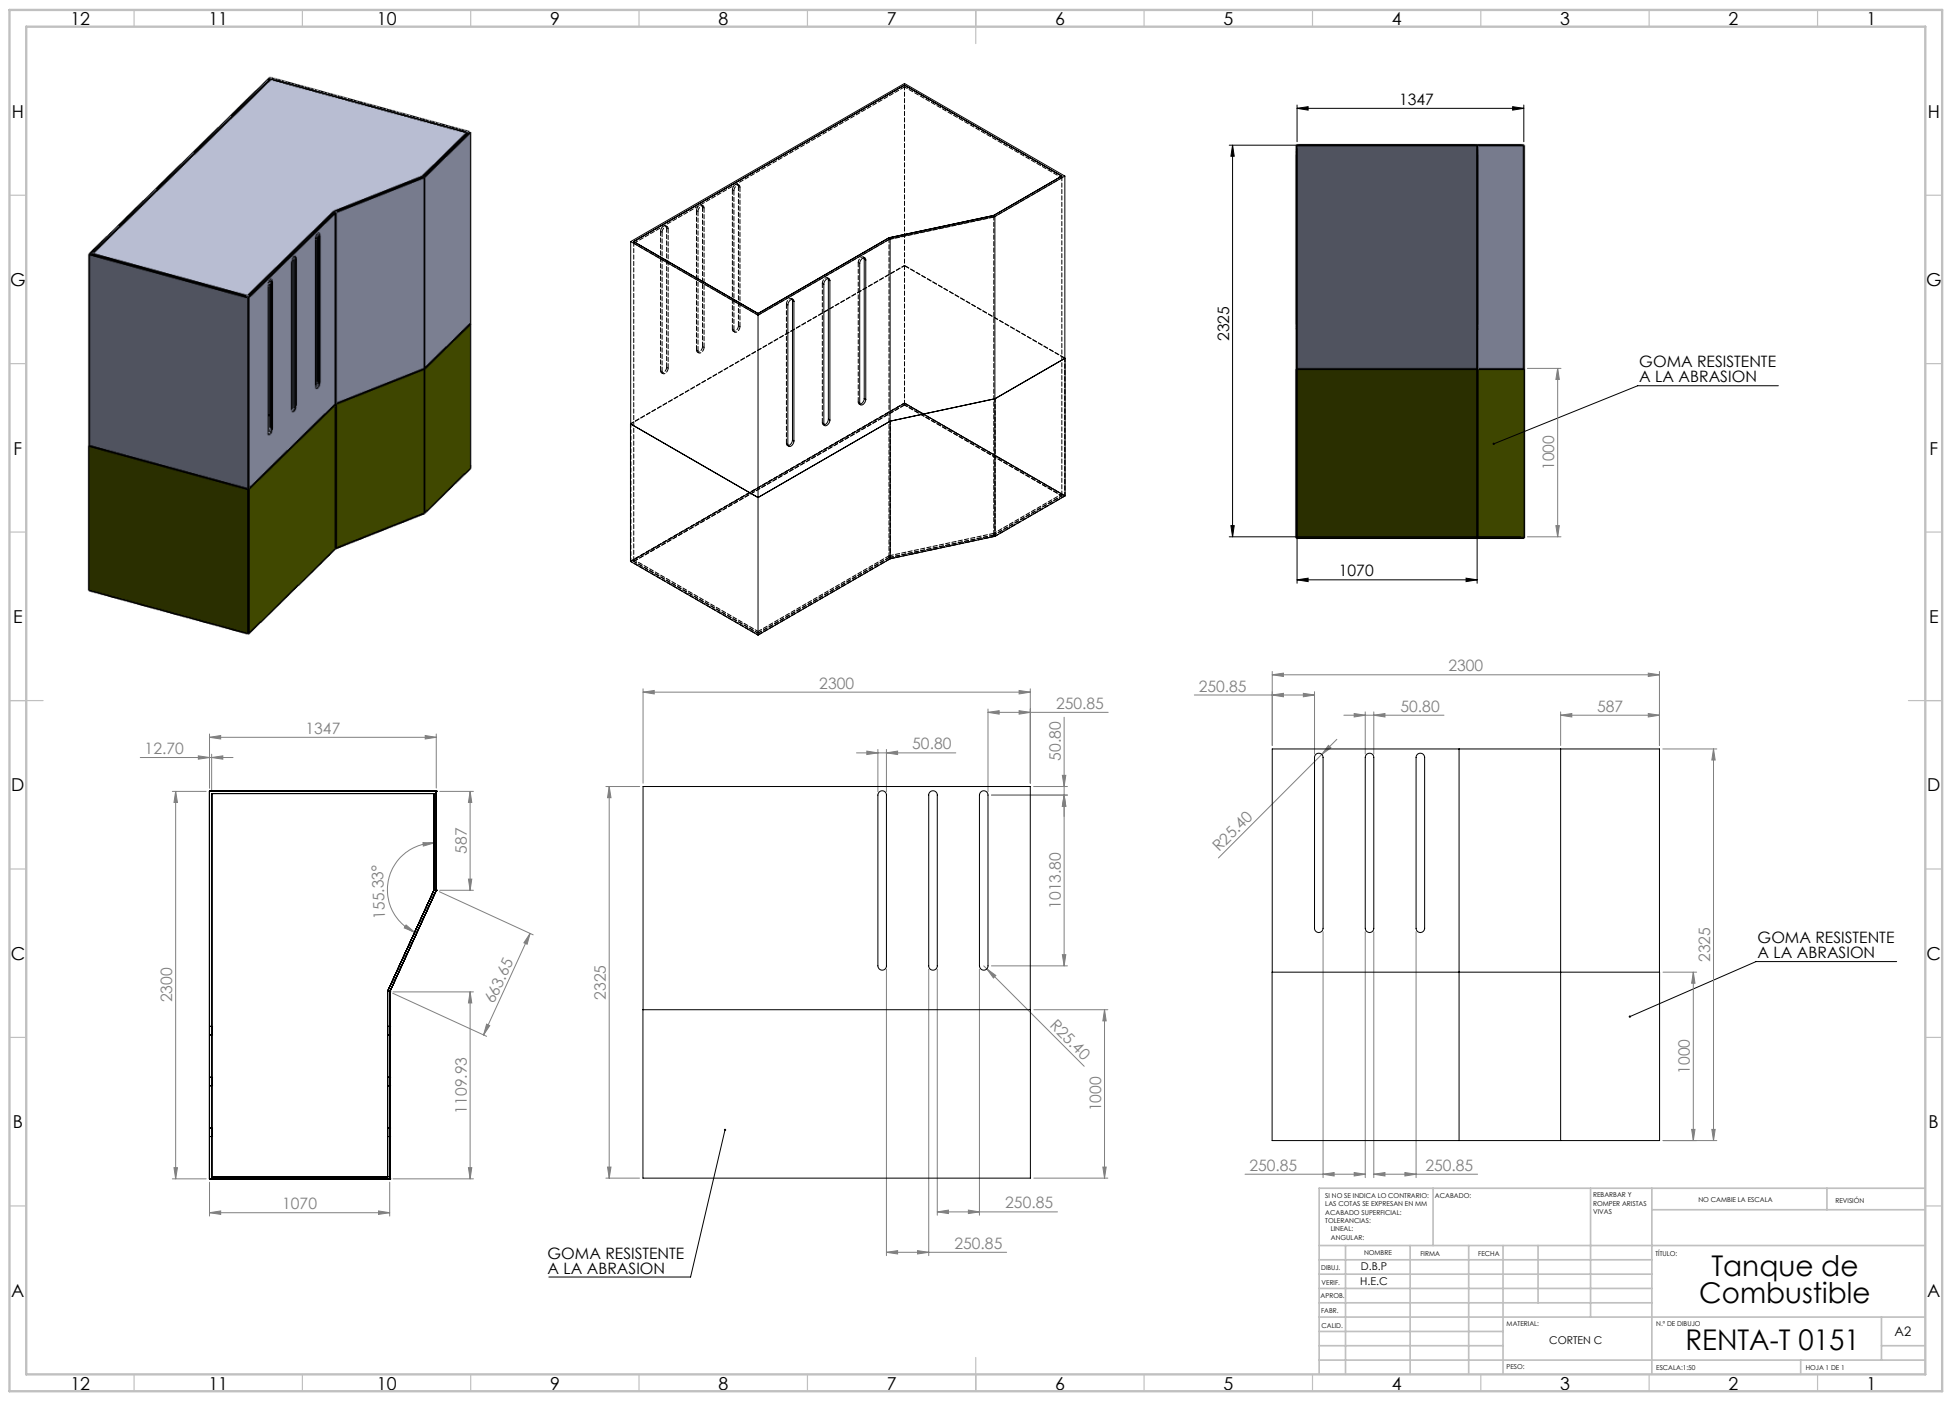
[picture p123: page 2]
GOMA RESISTENTE A LA ABRASION; ACABADO:; REBARBAR Y; ROMPER ARISTAS; NO CAMBIE LA ESCALA; REVISIÓN

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

NOMBRE | FIRMA | FECHA | Tanque de TÍTULO: Combustible

DIBUJ. | D.B.P
VERIF. | H.E.C

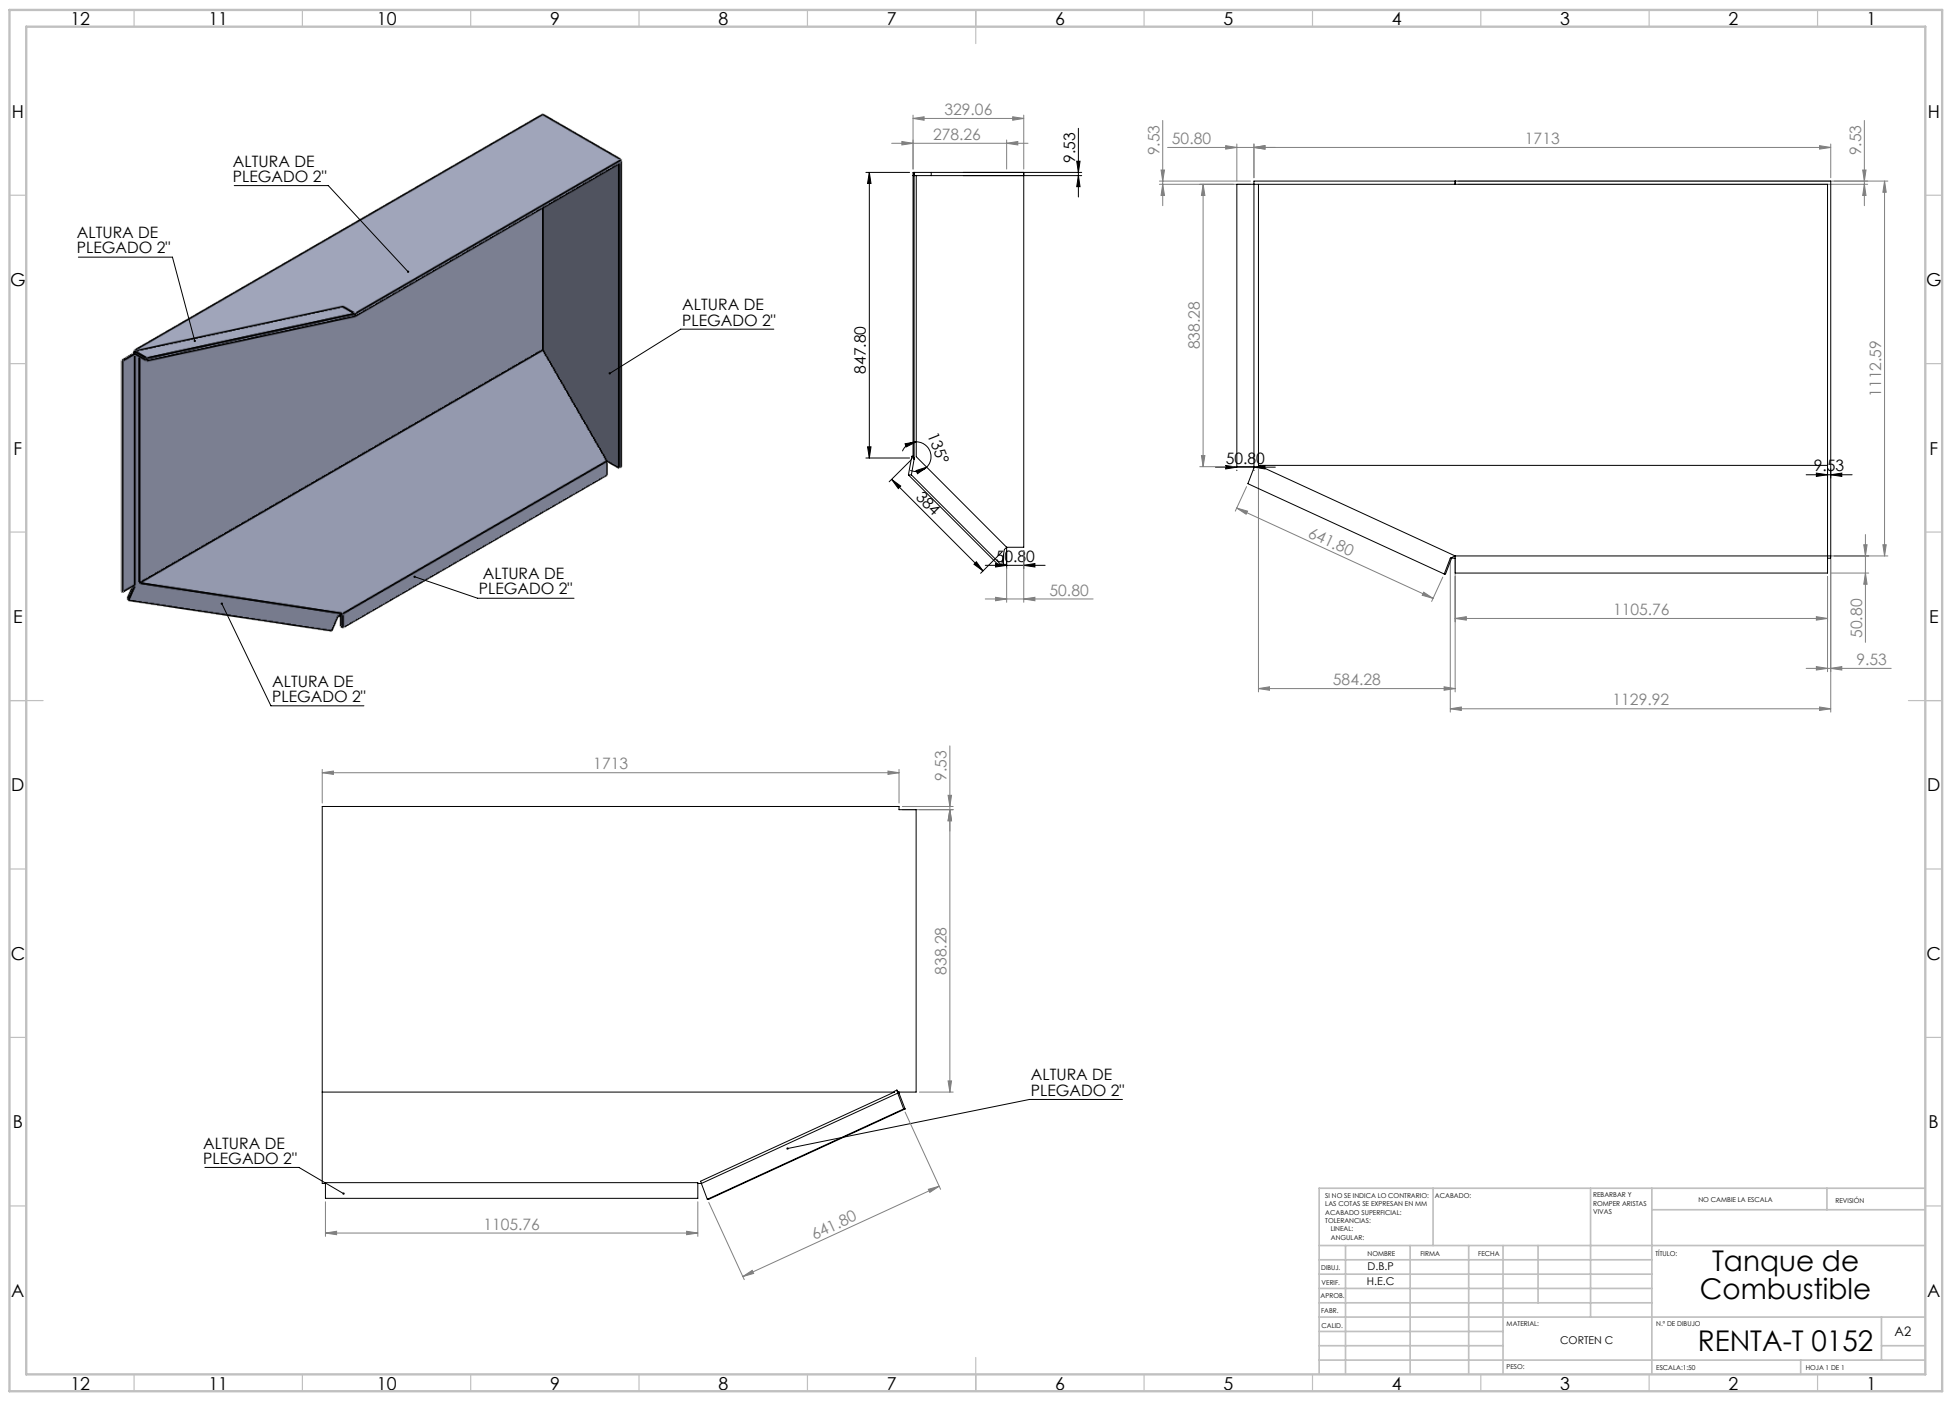
[picture p124: page 3]
ALTURA DE PLEGADO 2"; CORTEN C; RENTA-T 0152

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

NOMBRE | FIRMA | FECHA | Tanque de TÍTULO: Combustible

DIBUJ. | D.B.P
VERIF. | H.E.C

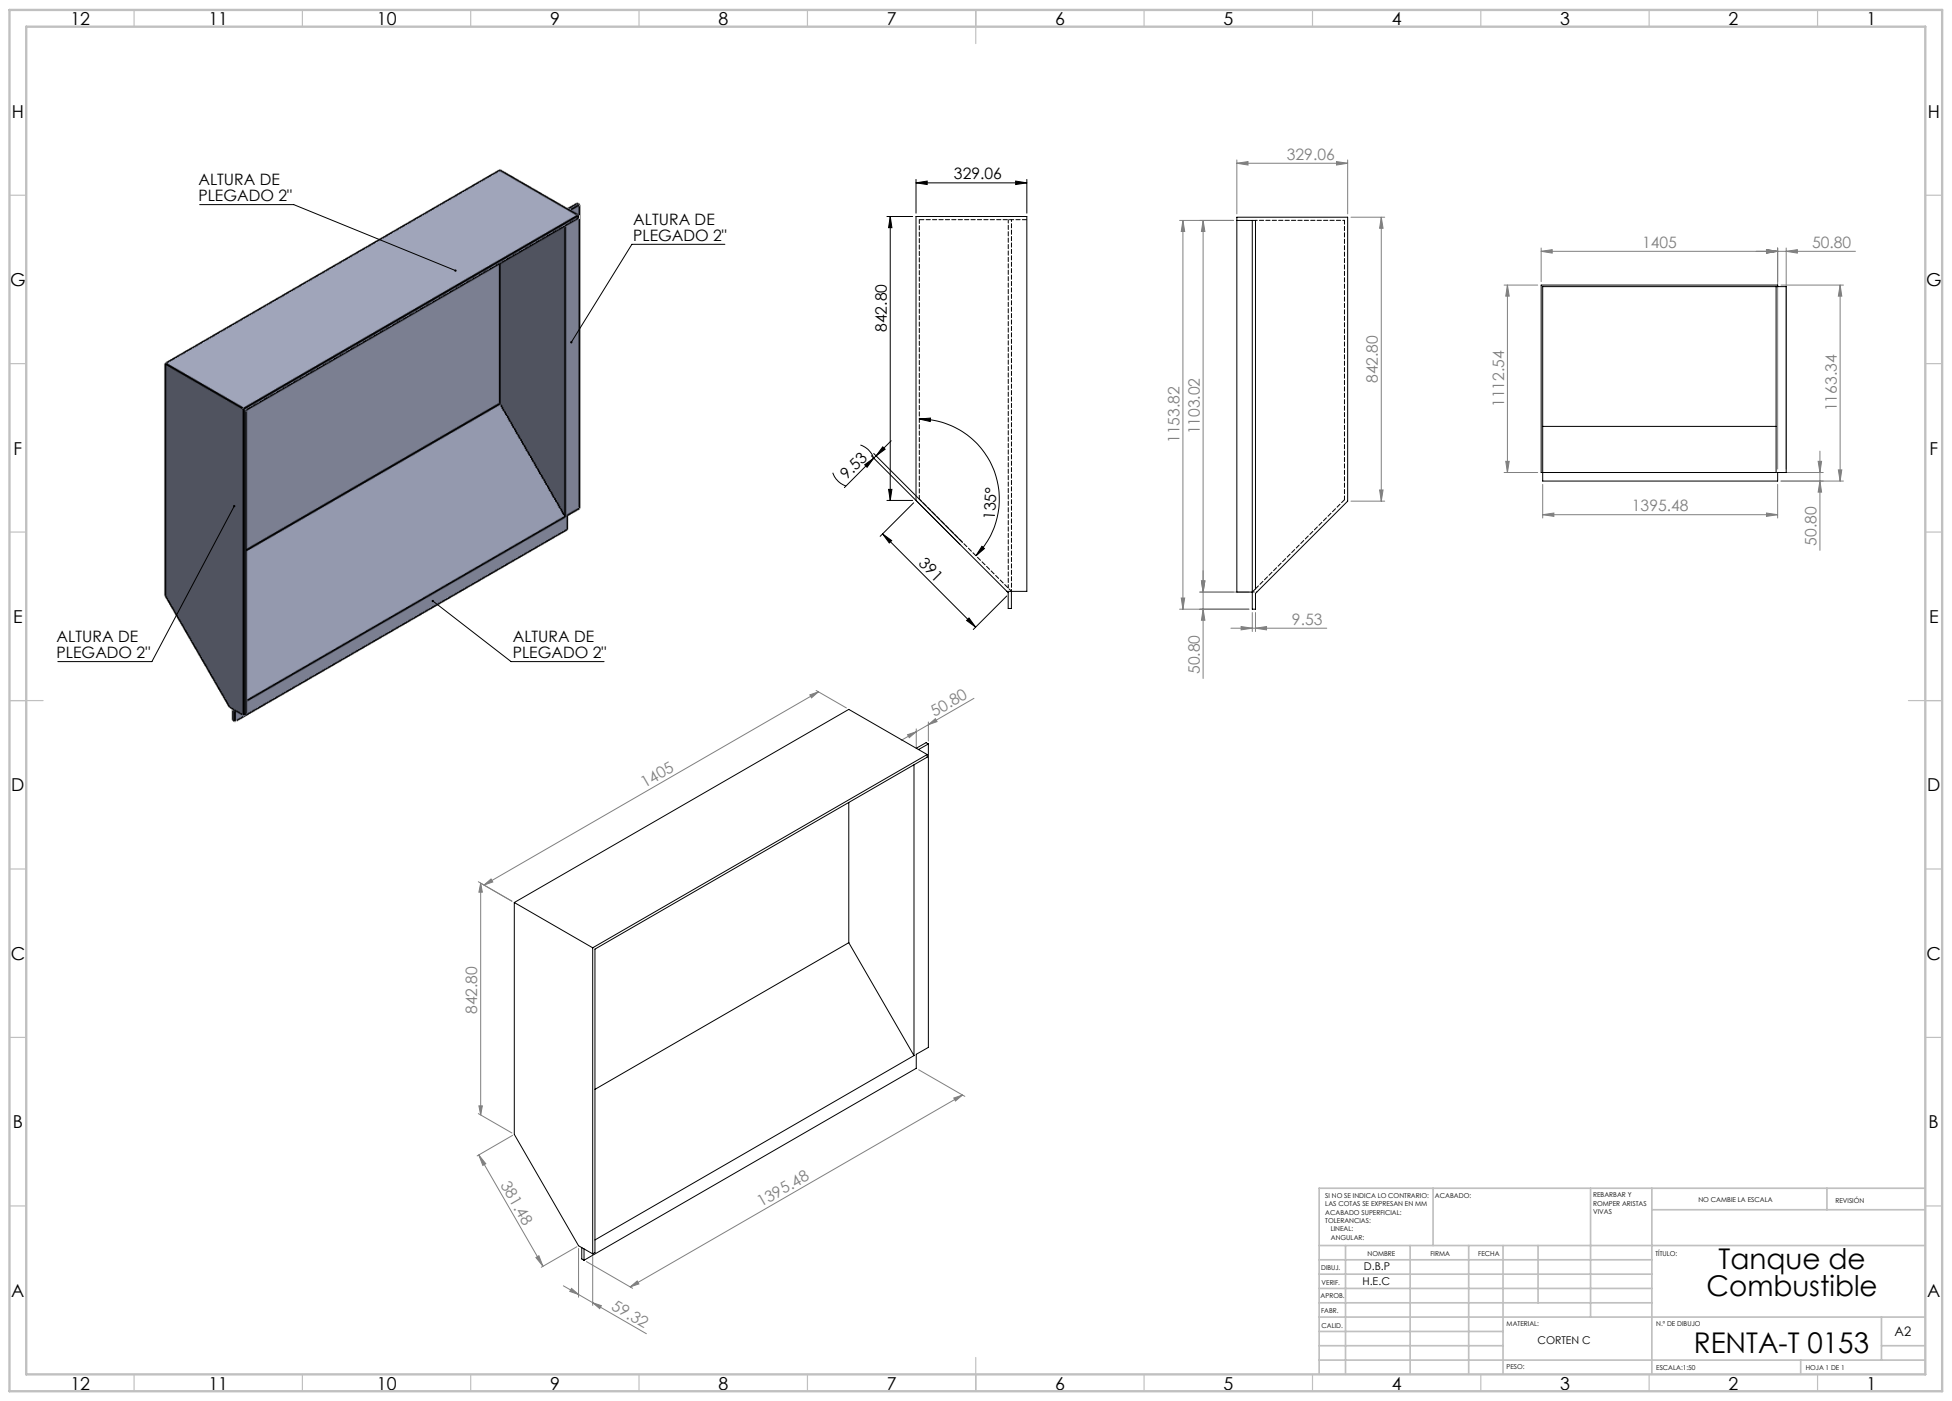
[picture p125: page 4]
ALTURA DE PLEGADO 2"

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

NOMBRE | FIRMA | FECHA | Tanque de TÍTULO: Combustible

DIBUJ. | D.B.P
VERIF. | H.E.C
